spoorcc/busy-light/docs/architecture/README.md

# Architecture

- **Status:** Draft

Describe the system context, decomposition into SW/HW/MECH elements (`ARCH-nnn`),
interfaces between them (electrical, protocol, mechanical), data/power/thermal budgets,
failure behaviour, and test/diagnostic access. Each significant choice links to an ADR in `../decisions/`.
