spoorcc/busy-light/hw/sim/README.md

# Hardware simulation and analysis

- `spice/` -- ngspice netlists/models (with provenance and assumptions in a header comment)
- `scripts/` -- Python analyses (power budget, tolerance/worst-case, level compatibility, pin-mux checks)

Results are referenced by `TC-nnn` and archived per `docs/process/verification-strategy.md`.
