spoorcc/busy-light/mech/analysis/README.md

# Mechanical analysis

Tolerance stack-ups, interference checks (against KiCad STEP), FEM setups and results. Reproducible scripts preferred.
