spoorcc/busy-light/docs/requirements/mech.md

# Mechanical Requirements

- **Status:** Approved (MECH-001 to MECH-009, owner, 2026-11-07, in two steps; bracketed values stay open)
- **Version:** 0.2 (2026-11-07, assistant redraft after ADR-0003 and ADR-0011 Accepted, ADR-0014 Proposed, RV-004, RV-007; all entries stay Draft; only the owner approves)
- **Owner:**

Entries use IDs `MECH-nnn` and follow `docs/templates/requirement.md`.
Process rules: `docs/process/README.md`.

### MECH-001 Housing size

- **Statement:** The printed housing with the board fitted, without cable and plug, shall have a largest outer dimension from 48 mm to 58 mm.
- **Rationale:** SYS-028: size between a table-tennis ball and a tennis ball. Working value in plan 05: diameter [53.0] mm, height [16.5] mm (17.45 mm with feet); the values are redone for horizontal and vertical mounting (RV-004 A1). The cable and its plug are excluded (RV-004).
- **Parent:** SYS-028
- **Acceptance criteria:** A caliper measurement of [3] printed housings gives a largest dimension within the range.
- **Verification method:** Test
- **Verified by:** TC-301
- **Category:** Functional
- **Regulatory:** none
- **Priority:** Must
- **Status:** Approved (owner, Ben Spoor, 2026-11-07, in the working session; recorded by the assistant; values in square brackets stay open until measured)

### MECH-002 Light diffuser

- **Statement:** The housing shall diffuse the light of the 16 LEDs so that no single LED is visible as a point at 1 m and the ring looks like a closed band of colour.
- **Rationale:** SYS-001: the ring is read from desk distance. Points of light make the status harder to read. Owner decision 2026-11-07 (ADR-0011): a wide glow or band, not a sharp ring; concept B (opaque base, one translucent lid) is the working concept and concept A is the fallback only if TC-302 fails.
- **Parent:** SYS-001
- **Acceptance criteria:** Coupon test first: lid coupons of [0.8], [1.2] and [1.6] mm over a ring of 16 LEDs at [4], [6] and [8] mm distance; then the finished lid. A photo test at 1 m under office light shows no point source; the luminous intensity at 0.5 m of SYS-001 is measured through the diffuser.
- **Verification method:** Test
- **Verified by:** TC-302
- **Category:** Functional
- **Regulatory:** none
- **Priority:** Should
- **Status:** Approved (owner, Ben Spoor, 2026-11-07, in the working session; recorded by the assistant; values in square brackets stay open until measured)

### MECH-003 Antenna clearance

- **Statement:** The housing shall have only non-conductive plastic inside a box of [15] mm around the antenna area of the module (no metal, magnet, screw, insert, conductive or metallic filament, metallic or conductive paint, metallised label), and the range test with the finished housing shall show a loss of at most [6] dB against a bare module (the criterion of ADR-0003 spike 7.2). The 15 mm distance from the antenna edge to the nearest wall is a goal, not a pass criterion: it is 14.3 mm at the corners in the working geometry (ADR-0003 finding of 2026-11-04).
- **Rationale:** RISK-011: detuning of the antenna by nearby conductive material. The vendor guideline (15 mm in all directions) also covers LEDs, tracks and ground near the antenna and the centred module: that is a PCB layout matter, recorded in ADR-0003 and HW-005, not a housing requirement. The 15 mm cannot be met literally in a 53 mm unit (plan 05 section 4.6); ADR-0003 (Accepted 2026-11-07) puts the module off-centre toward the rim and lets the spike 7.2 loss decide. DEV-004 covers the keep-out overlap on the PCB spike.
- **Parent:** SYS-038
- **Acceptance criteria:** The housing drawing shows the plastic-only box and the wall distance; the range test of SYS-038 passes with the finished housing, with and without an accessory mounted on the back (RV-007), at three distances.
- **Verification method:** Inspection
- **Verified by:** TC-303
- **Category:** Performance
- **Regulatory:** none
- **Priority:** Must
- **Status:** Approved (owner, Ben Spoor, 2026-11-07, in the working session; recorded by the assistant; values in square brackets stay open until measured)

### MECH-004 Access to USB-C and button

- **Statement:** The housing shall give access to the USB-C connector with a standard cable whose plug overmold fits the Type-C envelope of 12.35 x 6.5 mm, through a window of [14.2] x [8.2] mm, and to the button with a finger, without tools.
- **Rationale:** SYS-017 and SYS-020: the user needs both. Window raised from [14.0] x [8.0] to [14.2] x [8.2] mm by the owner on 2026-11-07: the tolerance check (`mech-housing-first-model.md`) showed zero reserve at worst case with 14.0 x 8.0.
- **Parent:** SYS-017, SYS-020
- **Acceptance criteria:** Fit check with [3] common USB-C cables (including one with an overmolded plug at the envelope limit) and with a finger on the button in the fitted housing, on [3] printed housings; the window is checked at the worst-case tolerance stack (`mech-concept-analysis.md`).
- **Verification method:** Demonstration
- **Verified by:** TC-304
- **Category:** Usability
- **Regulatory:** none
- **Priority:** Must
- **Status:** Approved (owner, Ben Spoor, 2026-11-07, in the working session; recorded by the assistant; values in square brackets stay open until measured)

### MECH-005 Thermal and material

- **Statement:** The housing material (PETG for the prototype, ADR-0011) shall keep its shape at the highest temperature that the analysis or the measurement gives on the housing near the LEDs and the module, with a margin of at least [15] K below the material's heat deflection temperature.
- **Rationale:** RISK-005: printed plastic softens near LEDs and the module.
- **Parent:** SYS-020, SYS-028
- **Acceptance criteria:** The measured temperature at the top current step in the closed housing at [35] C ambient (the run of HW-013 and TC-213, same setup) stays below the heat deflection temperature of the named PETG by the margin; the PETG data (65 to 78 C at 0.45 MPa across brands, ADR-0011 E2) gives a working limit of about [50] C at the housing wall, to be replaced by the data of the actual filament. Orientation: horizontal and vertical. The material and its data sheet are named in the drawing.
- **Verification method:** Test
- **Verified by:** TC-305
- **Category:** Safety
- **Regulatory:** EN 62368-1 *(verify)*
- **Priority:** Must
- **Status:** Approved (owner, Ben Spoor, 2026-11-07, in the working session; recorded by the assistant; values in square brackets stay open until measured)

### MECH-006 Label area

- **Statement:** The housing shall have a flat area of at least [20] x [20] mm on the back of the base, outside the bayonet ring of MECH-007 (in its open centre if ADR-0014 variant V2 is accepted: a circle of [21] mm), for the unit label (identifier, passphrase, QR code) and the "prototype, not for sale" mark, which an accessory on the back does not cover.
- **Rationale:** ADR-0006 puts the passphrase on a label. Owner decision 2026-11-04: the unit is mounted horizontal and vertical and the label is on the back (assumption A1 of plan 05 is withdrawn). The label stays on the base, which does not move when the lid opens, and never on a swappable accessory. The label is inside the 15 mm antenna box of MECH-003, so it must not be metallised. Regulatory labelling is a tight fit on a 53 mm housing (AS4).
- **Parent:** SYS-013
- **Acceptance criteria:** The drawing shows the label area on the back, outside the recess of MECH-007. A printed label of the stated size fits, is not metallised, and stays readable after a wipe test of [20] cycles and after the heat soak of MECH-005. A locked accessory does not cover the label.
- **Verification method:** Inspection and Test
- **Verified by:** TC-306
- **Category:** Usability
- **Regulatory:** none
- **Priority:** Should
- **Status:** Approved (owner, Ben Spoor, 2026-11-07, in the working session, after ADR-0014 was accepted; recorded by the assistant; values in square brackets stay open until the coupon test; [X] N is derived from the heaviest accessory)

### MECH-007 Back mounting interface

- **Statement:** The back of the housing shall have an annular bayonet (ring from radius [16.3] to [21.0] mm, depth [1.2] mm in the 2.0 mm floor, [3] T-shaped lugs of [1.2] mm engagement height behind a lock lip, [3] lock positions) that takes a ring-shaped accessory (stand, clip, rack-mount adapter or blank plate) by a turn of about [30] degrees, with a detent and a release tab, without tools, leaving the centre open, and shall have no metal, magnet or insert in or on the back.
- **Rationale:** NEED-022 and ADR-0014 (Accepted 2026-11-07): a printed bayonet is plastic only, so it respects the antenna box of MECH-003. The annular variant keeps the 21 mm label readable in the open centre (`spike-mech-back-layout.md`, V2); widths are multiples of 0.4 mm (4.4 or 4.8 mm for the ring). The floor skin, print orientation (the recess on the bed side is a bridge), release against a knock and the loads are not shown (RV-007). A printed thread and a tripod socket were rejected. Lock concept confirmed by the owner on 2026-11-07: entry sector, lock sector with a [0.4] mm lip, solid stop (`mech-housing-first-model.md`; `bayonet_geometry.py`).
- **Parent:** NEED-022
- **Acceptance criteria:** The drawing shows the ring, the lugs, the detent and the release tab with tolerances and the print orientation. A test accessory fits and locks on [3] printed housings by one hand in under [10] s, and detaches again; a knock test does not release it. No metal part is in the back (inspection).
- **Verification method:** Inspection and Test
- **Verified by:** TC-307
- **Category:** Functional
- **Regulatory:** none
- **Priority:** Should
- **Status:** Approved (owner, Ben Spoor, 2026-11-07, in the working session, after ADR-0014 was accepted; recorded by the assistant; values in square brackets stay open until the coupon test; [X] N is derived from the heaviest accessory)

### MECH-008 Accessory retention

- **Statement:** An accessory locked to the back shall hold the unit against a pull-off force of at least [X] N (derived from the mass and leverage of the heaviest planned accessory, the rack-mount adapter; the earlier [10] N is withdrawn), before and after [100] attach and detach cycles and after a heat soak at the highest internal temperature of MECH-005.
- **Rationale:** The unit hangs on a wall clip or stands on an accessory. FDM lugs and detents in warm PETG or ASA can creep (plan 05 section 4.8; no strain limit found). The force value is open until it is derived from the heaviest planned accessory; a stand or rack mount loads the lugs in moment and shear (RV-007). PETG creeps when warm (ADR-0014 fallback C, a dovetail, if the coupon fails).
- **Parent:** NEED-022
- **Acceptance criteria:** On [3] housings, the pull-off force is at least [X] N before the cycles, after [100] cycles, and after the heat soak; no lug is cracked; the accessory does not release by itself in a hanging test of [24] h at the soak temperature.
- **Verification method:** Test
- **Verified by:** TC-308
- **Category:** Safety
- **Regulatory:** none
- **Priority:** Should
- **Status:** Approved (owner, Ben Spoor, 2026-11-07, in the working session, after ADR-0014 was accepted; recorded by the assistant; values in square brackets stay open until the coupon test; [X] N is derived from the heaviest accessory)

### MECH-009 PCB retention and reopening

- **Statement:** The housing shall hold the board by snap hooks on the board edge, with no screw through the board and no metal near the antenna zone, and shall open and close [100] times without a broken hook or a loose board.
- **Rationale:** Owner decision 2026-11-07 (ADR-0011 point 7): snap hooks on the board edge, no holes. Metal near the antenna zone detunes it (MECH-003). The unit is opened for programming and repair (HW-006), so reopening has to work; PETG hooks can break (ADR-0011 risk c). The PCB spike outline already carries the notches.
- **Parent:** SYS-028
- **Acceptance criteria:** On [3] printed housings, [100] open and close cycles with no cracked hook; the board does not move by more than [0.3] mm in a shake test; the drawing shows the notches and hooks with tolerances (radial gap D 46 mm to the wall 1.38 mm worst case).
- **Verification method:** Test
- **Verified by:** TC-309
- **Category:** Reliability
- **Regulatory:** none
- **Priority:** Should
- **Status:** Approved (owner, Ben Spoor, 2026-11-07, in the working session; recorded by the assistant; values in square brackets stay open until measured)

### MECH-010 Flammability class of the housing material for units placed on the market

- **Statement:** The housing parts of every unit placed on the market shall be made of a material whose flammability class, at the wall thickness used, meets what the fire classification of SYS-050 asks of the housing.
- **Rationale:** RISK-047. If any circuit is class PS2 and the housing is its fire enclosure, EN IEC 62368-1 asks for V-1 or better for the enclosure material *(verify clause 6.4.8 and Annex S)*; if every circuit is PS1, no fire enclosure is needed and HB is the working minimum. ADR-0011 accepts FDM-printed PETG for the prototype only; common PETG filament has no flammability rating, and a rating of the raw material does not automatically hold for a printed part with layers and infill. This requirement can therefore change the material or the process for sold units, and needs its own ADR.
- **Parent:** SYS-050
- **Acceptance criteria:** The drawing names the material, its maker and grade; the maker's data sheet or a UL yellow card states the class at a thickness at or below the thinnest housing wall; for a printed part, a flame test of [5] printed coupons at the product wall thickness and print settings to IEC 60695-11-10 confirms the class. The 10 internal prototypes are out of scope.
- **Verification method:** Inspection
- **Verified by:** TC-310
- **Category:** Safety
- **Regulatory:** RED 2014/53/EU Art. 3(1)(a); EN IEC 62368-1 clause 6.4 and Annex S; IEC 60695-11-10 *(verify)*
- **Priority:** Must
- **Status:** Draft

### MECH-011 Strength of a wall, ceiling or rack mounting accessory

- **Statement:** An accessory that holds the unit on a wall, on a ceiling or in a rack shall hold a force of [3] times the weight of the unit with its cable, and at least [50] N, applied for [1] min in the direction of the fall, without release or damage.
- **Rationale:** RISK-039. EN IEC 62368-1 clause 8.7 tests the mounting means of equipment that is mounted on a wall or ceiling *(verify the force values and whether the clause applies to a unit of this mass)*. MECH-008 leaves its pull-off force [X] N open; this requirement gives the safety-driven lower bound for the accessories that carry the unit above a person or a surface.
- **Parent:** NEED-022
- **Acceptance criteria:** On [3] printed accessories and housings, the force is applied to the locked unit for [1] min before and after the heat soak of MECH-008; the unit stays locked and no part cracks. A desk stand is out of scope.
- **Verification method:** Test
- **Verified by:** TC-311
- **Category:** Safety
- **Regulatory:** RED 2014/53/EU Art. 3(1)(a); EN IEC 62368-1 clause 8.7 *(verify)*
- **Priority:** Should
- **Status:** Draft
