spoorcc/busy-light/docs/journal/2026-11-07-mech-requirements-redraft.md

# 2026-11-07: mechanical requirements redraft

The assistant redrafted MECH-001 to MECH-008 and added MECH-009 as Draft. Nothing is approved.

Changes: MECH-001 excludes the cable and plug; MECH-002 names the coupon test and the wide-glow decision; MECH-003 turns the 15 mm wall distance into a goal and makes the range loss of at most [6] dB the pass criterion; MECH-004 names the USB-IF plug envelope and the window; MECH-005 names PETG and ties the temperature to the TC-213 run; MECH-006 moves the label to the open centre of the annular bayonet; MECH-007 describes the annular bayonet and is conditional on ADR-0014; MECH-008 withdraws the 10 N figure until it is derived; MECH-009 is new (snap hooks, 100 reopenings).

Open questions for the owner: (1) MECH-003 no longer requires 15 mm to the wall: accept the range test as the criterion; (2) the PETG working limit of about 50 C at the wall comes from the lowest brand data and is replaced by the actual filament data; (3) ADR-0014 is not accepted, so MECH-006, 007 and 008 are conditional; (4) height and label place for horizontal and vertical mounting are not redone (RV-004 A1).

Not run: no CAD, no analysis, no print.
