spoorcc/busy-light/docs/user/specifications.md

# Specifications

- **Status:** Draft -- placeholder, content to be written after requirements are approved
- **Applies to:** product revision TBD (hardware / mechanical / firmware)
- **Source requirements:** TBD

> Scope: Table of electrical, mechanical, environmental and radio data with units and tolerances. Values must trace to requirements.
