spoorcc/busy-light/docs/verification/reports/spike-fab-review.md

# Spike board: assembly and fabrication review (HW-010)

- **Date:** 2026-11-08. **Author:** assistant. **Status:** Draft evidence. Not an approval; only the owner approves a design.
- **Subject:** `hw/kicad/spike-gate/board/busy_light_spike.kicad_pcb` (ring14 run 9, 4 layers, 1.6 mm, 53.9 x 46.1 mm, 100 parts, 59 on the bottom side).
- **Tool and tests:** `hw/kicad/spike-gate/src/pcb_fabreview.py`, `tests/test_pcb_fabreview.py` (7 pass).
- **Basis:** KiCad 10.0.6 `kicad-cli` exports and DRC; JLCPCB numbers of ADR-0020 (Proposed) in `pcb_fabcheck.py`.

## What was run
| Check | Result |
|---|---|
| DRC, all severities, all track errors | 0 unconnected, 0 schematic parity findings; findings only courtyards_overlap 8 and items_not_allowed 1 (U9 antenna keep-out, DEV-004). No silkscreen, solder-mask or edge finding was reported. |
| Fabricator minimums (`pcb_fabcheck.py`) | PASS; via ring at the 0.15 mm absolute minimum on all 131 vias |
| Gerber export (12 files: 4 copper, 2 mask, 2 paste, 2 silkscreen, edge cuts, job), Excellon drill (`.drl`) | files written; not opened in a second viewer |
| Position file (`pos.csv`), BOM (`bom.csv`) | written; see findings |
| `pcb_fabreview.py` (BOM against board, references, fiducials, silkscreen, tbd values) | **4 findings** |

## Findings
| # | Finding | Evidence | Effect |
|---|---|---|---|
| 1 | The schematic BOM has 7 unannotated references: C1B? to C1F?, R_ILIM3B?, R_VD?. The board has them as C1B to C1F, R_ILIM3B, R_VD. | `pcb_fabreview.py` `unannotated`, `bom_vs_board` | The BOM from the schematic does not match the board. Fix in the schematic generator; not investigated. |
| 2 | No reference designators on the silkscreen: all 100 reference texts are on F.Fab or B.Fab. | `refs_on_silk` 0 | Hand assembly, rework and probing have no marks. |
| 3 | No fiducials. | `fiducials` 0 | Pick-and-place machines align on fiducials; JLCPCB assembly may add its own or reject the panel. Not checked with the fabricator. |
| 4 | Five parts still have a tbd value: C2, C3, C4, C5, C6 (HW-014, HW-015, HW-016 are Draft). | `open_values` | The BOM cannot be ordered. |
| 5 | The BOM has no manufacturer part number or supplier number field. | `has_mpn_field` false | No sourcing or availability check is possible. |
| 6 | Two-sided assembly: 41 parts on top, 59 on the bottom; the USB-C receptacle (20 through-hole pads) is edge-mounted. | `pos.csv`, pcbnew | Costs more and needs a second reflow pass; the through-hole part needs hand or selective soldering. |

## Not run
Opening the Gerbers in an independent viewer, a fabricator's own DFM check (JLCPCB online), part availability and lifecycle, 3D fit against the housing (MECH), panelisation, test-point access for a test fixture, RF and antenna, thermal, bench. The 3D render shows the copper only faintly, so solder-mask appearance was not judged.

## Reading
The board file is clean for the DRC and the fabricator minimums. It is **not ready to order**: findings 1 to 5 would stop or slow an assembly order. None of this makes the board "DFx approved" or "fully functional"; both statements need the owner's review, a built board and the bench tests (TC list in the HW-010 verification plan).

## Update after the fixes (2026-11-08, owner choice "all three, including renaming")
| # | Change | Evidence |
|---|---|---|
| 1 | Seven parts renamed to numbered names (KiCad reads a reference without a trailing number as unannotated): C1B to C1F to **C27 to C31**, R_ILIM3B to **R20**, R_VD to **R21**. Generators, rules, tests, evidence files and current reports use the new names; journals, the CHANGELOG and the earlier ring sections keep the old names as history. The schematic was regenerated (`run_full.sh`: ERC 0, intent equal, deterministic) and the board renamed by script (`pcb_rename.py`, 5 tests); one auto-named net (`Net-(R_ILIM3-Pad1)`, now `Net-(R20-Pad2)`) was renamed with it. | BOM has no `?`; BOM and board refs agree; schematic parity shows only the two known C3 and C4 mismatches |
| 2 | Reference designators on the silkscreen by script (`pcb_finish.py`, 12 tests): 73 of 100 parts have one (1.0 mm text, 0.8 mm where tight). 27 parts have none because the DRC found no free place: SW1, D3, DZ14, DZ15, C4, C25 to C27, U1, U14, U15, TP5, R1 to R3, R5, R11 to R15, R17, R18, R20, R_ILIM1, R_ILIM3, R_SU15. | DRC with all severities: no silkscreen finding; render checked by eye (top and bottom) |
| 3 | Four fiducials (two per side, 1.0 mm pad, 2.0 mm mask opening), outside the U9 antenna area, the connector and the rule area. A third per side found no free spot. | `pcb_fabreview.py` counts 4 |

Checks on the finished stored board: strict gate (tolerated classes only: courtyards_overlap 8, items_not_allowed 1, symbol mismatch 2), fab-minimum check PASS, power drops 13.5, 18.0 and 22.7 mV, 131 vias and 1369.9 mm of track (no routing change), 0 unconnected. `pcb_fabreview.py` still reports FINDINGS: 26 parts without a silkscreen designator (the 27th, TP5, is a test point), tbd values C2 to C6, and the BOM has no part-number field. The fiducials are not checked against a fabricator's rules (JLCPCB asks for its own); their count of 4 is below the usual 3 per side.

Name map for the older documents: C1B to C1F = C27 to C31, R_ILIM3B = R20, R_VD = R21.

## Update 2026-11-08 (finding 5, BOM sourcing fields)
`src/sourcing.py` maps a part value to `MPN`, `Manufacturer` and `LCSC`; `layout_full.py` writes them as hidden symbol fields, and the stored schematic was regenerated (ERC 0 findings; the only difference to the old file is the added fields). Only TMUX1101DCKR (U14, U15) has a recorded source (owner decision 2026-11-05, datasheet SCDS410D). `pcb_fabreview.py` now reports parts without an MPN: **92 of the BOM references** (BOM exported with `--ref-range-delimiter ""` so that ranges such as C8-C26 are not counted as one). Finding 5 is therefore half closed: the field exists and is checked; the numbers are not filled in. Filling them needs a datasheet or shop check per part (HW-008, spike 7.4) and was not done; no number was taken from memory. Tests: `tests/test_sourcing.py` (5), `tests/test_pcb_fabreview.py` (+1). Existing defect found, not fixed: a second `layout_full.build()` in one process draws extra symbols (253 then 295), so the new test builds in a fresh process.

## Update 2026-11-08 (MPNs from web lookups)
Owner choice "ICs and specific parts". MPNs and, where seen, LCSC numbers were looked up on the web for 13 more part groups (U1 to U8, U10, U11, U13, D1 to D16, DZ1/DZ14/DZ15, SW1) and stored with their evidence in `src/sourcing.py`. The evidence is mostly distributor listings (DigiKey, LCSC, RS); TI package addenda for TPS3840DL40DBVR and TPS2553DBVR; the ST product page for USBLC6-2P6. No manufacturer ordering table was opened and no datasheet PDF was read for these numbers, so they are lookups, not verified sourcing. Parts without an MPN: **61 references** (92 before).

Points for the owner:
- U9 ESP32-C3-MINI-1: the flash variant (-N4 or -H4) is not decided anywhere in the repo; left empty.
- J1: the GCT USB4085-GF-A in the listings is a through-hole right-angle part, while the footprint is `USB4085_edge`; the edge-mount variant is not identified; left empty.
- U1 TUSB321RWBR: LCSC marks it not recommended for new designs.
- D1 to D16 WS2812B-2020: LCSC lists 2.2 x 2 mm, the footprint is 2.0 x 2.0 mm; check the manufacturer drawing.
- SW1 TL3342F160QG: the force variant is an assumption.
- TVS1, TVS2 (no part chosen), C2 to C6 (tbd), all resistors and capacitors (no manufacturer chosen): left empty.

## Update 2026-11-08 (finding 4, tbd values)
Values set by owner decision (`proposal-tbd-capacitor-values.md`): no tbd value is left (`open_values` empty). Finding 4 is closed for the values; the capacitors have no MPN yet. C4 and C32 are do-not-populate spares and are out of the BOM (`--exclude-dnp`); `pcb_fabreview.py` now takes the DNP footprints out of the BOM comparison and lists them. Parts without an MPN: **60 references** (61 before; C4 left the BOM). Designators missing on the silkscreen: 27 (C32 added). Also corrected: the sourcing fields from the finding-5 update were not on the board footprints, so the strict DRC of the stored board had 100 `footprint_symbol_field_mismatch` warnings after that change (CI would have failed; my check at the time ran ERC only). Fixed in the same change as the capacitor values.

## Update 2026-11-08 (MPNs for passives and U9)
Owner choices: JLCPCB basic-library parts for resistors and capacitors; U9 = ESP32-C3-MINI-1-N4. Added to `src/sourcing.py` with evidence per entry: Uni-Royal 0603WAF series for 10k, 100k, 1k, 330, 470, 150k, 887k; FH thin film TD03G3010BT, TD03G4702BT, TD03G5622BT and Yageo RT0603BRE0727K4L for the 0.1% values; Samsung CL10B104KB8NNNC (100n 0603), CL10A105KB8NNNC (1u), Murata GRM31C5C1H104JA01L (100n C0G 1206); ESP32-C3-MINI-1-N4. Source: LCSC/JLCPCB/DigiKey listing pages found by web search; no datasheet PDF was opened, so these are lookups, not verified sourcing. Open points: 0603WAF1503T5E (150k) LCSC number came from the JLCPCB page only; 0603WAF8873T5E (887k) listing showed 0 stock; the FH 0.1% parts are JLCPCB extended parts (extra feeder fee); 27.4k has no LCSC number; the 0.1% resistor values are not checked against the ILIM tolerance analysis.
Schematic regenerated (strict ERC 0 findings); `pcb_spare_caps.py` copied the fields to the footprints; strict DRC: 9 findings, all the tolerated classes (courtyards_overlap 8, items_not_allowed 1), no parity warning. Tests: `tests/test_sourcing.py` (+1); the 15 errors in `test_gate_logic.py` need the `GATE_NET` environment variable of a run and were not run here.
**Parts without an MPN: 7 references** (60 before): C2, C3, C5, C6 (real parts wait for the DC-bias and effective-capacitance analysis, HW-014/HW-015), J1 (edge-mount variant of the GCT USB4085 not identified), TVS1, TVS2 (no part chosen; the surge decision S1 to S3 of RV-013 is open). Candidate SOD-323 5 V ESD diodes seen in listings, not chosen: Nexperia PESD5V0S1UA (LCSC C179414), Nexperia PESD5V0U1BA (C552574). Their surge rating for a VBUS hit is not checked.

## Update 2026-11-09 (MPNs for C2, C3, C5, C6 after the DC-bias bound)
The maker's DC-bias curves were then read with Claude in Chrome from the Samsung Component Library and replaced the assumed retention (`analysis-dc-bias-caps.md`: C2 1.69 uF at 5.25 V, C5 0.67 uF at 5.5 V). Parts and result in `analysis-dc-bias-caps.md`; script `hw/sim/scripts/dc_bias_caps.py` (9 tests). Value texts changed to `4.7u 16V X5R`, `10u 25V X5R`, `2.2u 16V X5R`, `10u 10V X5R`; MPN, manufacturer and LCSC added to `src/sourcing.py` (listings only, no datasheet opened). Schematic regenerated (strict ERC 0 findings); `pcb_spare_caps.py` synced the footprints; strict DRC: 9 findings, the tolerated classes only (courtyards_overlap 8, items_not_allowed 1). Tests: `tests/test_sourcing.py` (+1, one changed), `test_pcb_fabreview`, `test_pcb_spare_caps`, `test_layout_full` pass. **Parts without an MPN: 3 references** (7 before): J1, TVS1, TVS2. HW-014/HW-015 criterion 1 now uses the maker's typical curve (25 degC, 1 kHz, 1 Vrms); the bench criteria stay open.
