spoorcc/busy-light/docs/verification/reports/spike-pcb-placement-routing.md

# Spike: PCB placement and routing of the full board

Status: spike result, exploratory. It is not a product design and nothing here is approved. ADR-0012 is Proposed, so the PCB flow it describes is not decided, and nothing from this spike merges before the owner decides it. No compliance claim is made.
Traces: HW-010 (Draft proposal), HW-003, ADR-0016, ADR-0012 (Proposed), ADR-0010, SW-009 (proposed readback rule), RISK-042.
Implementation (spike branch `spike/hw-gate`, `hw/kicad/spike-gate/`): `src/pcb_full.py` (placed board), `src/route_grid.py` (router), `src/pcb_check.py`, `src/pcb_dsn.py`, `src/pcb_rules.py`, `run_pcb.sh`, `tests/test_pcb_full.py`, `tests/data/full.net` (netlist of the final full-board sheet).
Rebuild: run `run_full.sh <python> <dir>` for the schematic, then `sh run_pcb.sh <dir> <out>` with the system `python3` (KiCad 10.0.6 `pcbnew`, numpy 2.5.3, scipy 1.18.1, Python 3.14). The `.kicad_pcb` and `.kicad_pro` files are written by script into `<out>/a/` and are not committed, the same rule as the schematic spike. Nothing in them was edited by hand.

**Update (second run, same day):** section 10 adds the mechanical outline from the FreeCAD spike, Freerouting v2.5.0 and the 2-layer against 4-layer comparison. Where sections 1 to 9 differ from section 10 (outline, placement, router, widths), section 10 is the newer result. Sections 1 to 9 describe the first run on a provisional 136 x 64 mm rectangle with the own grid router; they are kept as the record of that run.

## 1. Result in numbers (run of 2026-11-05, final code)

| Item | Result |
|---|---|
| Parts placed | 86 of 86 refs of the netlist (plus 3 provisional mounting holes H1 to H3); no missing and no extra refs |
| Nets | 63 in the netlist (53 named, 10 `unconnected-*`); 63 on the board; 0 pad-to-net differences against the netlist (`pcb_check.py`) |
| Connections to route (excluding GND) | 141; routed 138, **not routed 3** (see section 5) |
| GND | back-layer pour plus a via for every SMD GND pad; **5 GND items stay unconnected** in the KiCad DRC |
| Tracks / vias | 884 track segments, 225 vias, 1646 mm of copper track, router time about 95 s |
| KiCad DRC (`kicad-cli pcb drc`, zones refilled) | **errors: 4 clearance, 8 unconnected items**; warnings: 86 `lib_footprint_issues`, 15 `silk_over_copper`, 1 `hole_to_hole`, 1 `connection_width`, 1 `via_dangling` |
| KiCad schematic parity | 100 warnings, all explained in section 4 (U1, U8, U9 pin names, four substituted capacitor footprints, three holes) |
| Placement build twice | byte-identical (`run_pcb.sh`, uuids normalised) |
| Routing run twice | byte-identical (`cmp` exit 0) |
| Unit tests | `tests/test_pcb_full.py`: 11 tests, all pass under system `python3` (skipped without `pcbnew`) |

The 4 clearance errors: two between a VBUS_IC track and pad 4 (`USB_DP`) of U6 (actual 0.125 mm, rule 0.150 mm) and two between a `+3V3` track and a `CC_OK_NOT_S3` track (actual 0.147 mm, rule 0.150 mm). The board does **not** pass DRC.

## 2. Tools and why

| Tool | Use | Status |
|---|---|---|
| KiCad 10.0.6 `pcbnew` Python | writes the board from the netlist; zone fill; DSN export | used |
| `kicad-cli pcb drc` / `export svg` | DRC with `--schematic-parity --refill-zones`; renders (scratchpad only) | used |
| Own grid router `src/route_grid.py` | A* on a 0.05 mm grid, 2 layers, through vias, Euclidean clearance raster (scipy), neck-down of wide nets, a retry pass | used (fallback) |
| Freerouting v2.5.0 (`freerouting-2.5.0.jar`, GitHub release) | the router I preferred | **not run**: see below |

**Freerouting was not run.** I tried to download the pinned jar into `~/Programming/busy-light-tools/` (outside the repository) and the permission layer of this session refused the download-and-execute action ("Code from External"). I did not work around the refusal. No version hash is recorded because no file was fetched. What exists: `src/pcb_dsn.py export` writes a Specctra DSN from the placed board (tested: it writes 63 nets with the net-class rules, 50 KB), and `pcb_dsn.py import` reads an SES back, refills zones and saves. The import path is **untested**. To use Freerouting the owner can allow the download or run `java -jar freerouting-2.5.0.jar -de x.dsn -do x.ses` on the DSN and then `pcb_dsn.py import`. Its result is likely better than mine (my router has no rip-up and re-route, only one retry pass), but that is an expectation, not evidence.

## 3. Board and placement decisions (all provisional)

- **Layers: 2.** Reasons from the earlier reports: the USB path carries 1.5 A (limit 1.38 to 1.58 A, step 3 up to 2 A worst case), which needs about 0.53 mm (1.5 A) and 0.78 mm (2.0 A) width at 1 oz and a 10 K rise (IPC-2221 curve fit, test `Rules`); the high-impedance ILIM node must stay short; USB 2.0 full speed needs no controlled impedance. The ESP32-C3 antenna wants no copper under or beside it, which a 2-layer board with one GND pour can honour. The cost is that routing is congested (many vias). A 4-layer stack would give an inner GND plane and is the likely answer if Freerouting results are also poor. No stack-up or fabricator rule was checked.
- **Outline 136 x 64 mm**: electronics zone x < 64 mm, 16 WS2812B LEDs in 2 rows of 8 at 8.5 mm pitch with a 100 nF capacitor each, 3 mounting holes M3. Mechanics, LED count and peg azimuth are open, so this outline has no basis in the mechanical design.
- **Rules:** clearance 0.15 mm (the J1 pad gap is 0.15 mm), signal track 0.2 mm (0.15 mm on nets at the 0.4 mm-pitch pads of U1), via 0.6/0.3 mm, copper-to-edge 0.3 mm, hole-to-hole 0.4 mm (relaxed from 0.5 mm because J1's through-hole pads are 0.85 mm apart with 0.4 mm drills). Whether a fabricator accepts these was **not checked**.
- **Placement by rule** (coordinates in `PLACE` in `pcb_full.py`): USB-C J1 with its mating face at the left edge; TVS and ESD parts beside J1; CC IC U1 at J1's CC pads; gate logic cluster in the middle; Q2, Q3, R2, R3 and the three ILIM resistors in a group next to U7 (ILIM parts within 15 mm of U7, tested); U5 with C1 and C1B beside it; the module U9 with its antenna end flush with the top edge and no other pad in its keep-out band (tested); LED field on the right. The placement was adjusted by hand-chosen coordinates and one iteration, not optimised: the render shows long runs.

## 4. Footprints: substitutions and gaps (all PROVISIONAL)

| Ref | Schematic footprint | Used | Why / what to check |
|---|---|---|---|
| U1 TUSB321 | `Package_X2QFN:X2QFN-12` | custom 12-pad footprint made in `pcb_full.py` | The system KiCad libraries have no `Package_X2QFN`. The geometry was read from a **text extract** of TI drawing RWB0012A (1.6 x 1.6 mm, 0.2 mm pads, 0.5 and 0.4 mm pitch). It may be wrong; take the land pattern from the TI drawing before any use. Pad numbers: CC1 1, CC2 2, PORT 4, VBUS_DET 5, GND 10, VDD 12 (datasheet pin table). |
| U9 ESP32-C3-MINI-1 | `RF_Module:ESP32-C3-MINI-1` | `RF_Module:ESP32-C6-MINI-1` | The C3 footprint is not in the libraries. Pad positions of the C6 footprint match the C3 pin diagram (pins 1 to 53, antenna to the top, corner pads 50 to 53), but I did not compare dimensions to datasheet figure 11-1. Its antenna keep-out zone (43 x 20 mm) comes with the footprint. Pad numbers from the C3 datasheet v2.2 table 3-1. |
| U8 REG_3V3 | empty (placeholder) | `SOT-223-3_TabPin2` | No regulator is chosen. Pin map GND 1, OUT 2, IN 3 is an AMS1117-style assumption. A 5 V to 3.3 V linear regulator at the module's peak current dissipates real heat; no thermal analysis was done. |
| C1, C1B | `C_0603` in the sheet | `C_1206` | The 470 nF and 150 nF C0G parts of the N4 addendum are 1206 (the sheet still draws 0603 for them: a schematic follow-up). |
| C3, C4 | `C_0603` | `C_0805`, `C_1206` | 10 uF and bulk values are "tbd"; sizes are guesses. |

Schematic pin names for U1, U8, U9 are names, not pad numbers (the box symbols of the full-board sheet are placeholders), so the generator maps them (`PADMAP`). KiCad's parity check therefore reports 84 `net_conflict` warnings on those three parts. The 13 `footprint_symbol_mismatch` warnings are the substitutions above plus six test points (BOM-exclusion attribute); 3 `extra_footprint` are the mounting holes. All 80 other refs are parity-clean.

## 5. What is not done or not good

- **3 connections are not routed:** `/CC1` and `/CC2` (J1 A5/B5 to U1 pads 1 and 2) and `Net-(U9-GPIO9_(boot))` (U9 pin 23 to TP6). The CC lines are exactly the nets the CC IC depends on (HW-010, HW-003), so the gate is **not** a complete design until they are routed. Likely cause: pads 1 and 2 of my guessed U1 land pattern are 0.4 mm apart with tight neighbours, and the router has no rip-up. I did not diagnose it further.
- **5 GND items unconnected** (U1 pad 10, U2 pad 3, U9 pad 49 and two via stubs): GND stub-and-via pieces that the back pour cannot reach, probably islands cut off by back-layer signal tracks.
- **4 clearance errors** (section 1). The router's raster is conservative but not exact; the DRC is the judge.
- **Layout quality is poor.** The render shows long and winding wide power tracks and 225 vias (about 80 for LED and capacitor GND alone). Track lengths: VBUS_IC 94 mm, +5V 243 mm, +3V3 148 mm. A person would place and route this more tightly.
- **Wide power tracks:** VBUS_IC is routed at 0.8 mm for 75 % of its length and +5V for 67 %; elsewhere it necks down to 0.25 mm near pads (the rest of the 1.5 A path is below the 0.53 mm that IPC-2221 gives, which is a finding, not a pass). +3V3 is meant to be 0.4 mm and is 0.25 mm in places.
- **Thermal relief:** only the zone's thermal spokes on the GND pour. No thermal vias or copper area for the TPS2553 or the regulator.
- **86 `lib_footprint_issues` warnings** mean the footprint libraries are not in a project library table; they say nothing about the layout. **15 silkscreen warnings** and one `hole_to_hole` (J1) were left open.

## 6. Layout rules from the earlier reports: what was measured

| Rule | Result |
|---|---|
| R3 and the U13 tap at the Q3 gate pin | `/ILIM_STEP3_EN` is routed as a star centred on Q3 pad 1 (every pad of the net, U4, U13, R3, R15, goes straight to that pad; 34 mm of track in total). R3 sits 5.7 mm from Q3. Tested only as placement and star setting, not by inspecting every spoke. |
| ILIM resistors near U7, short ILIM trace | R_ILIM1 to 3 within 15 mm of U7; the `/ILIM` net is 16.4 mm of track. "Away from switching nodes" was not analysed. |
| CC lines per the CC IC | **not met**: `/CC1` and `/CC2` are unrouted. |
| Wide VBUS | partly (section 5). |
| Antenna keep-out | no other pad in the band (test); no DRC error inside the rule area. Whether the pour and tracks respect the **real** C3 keep-out was not checked (the zone comes from the C6 footprint). |

## 7. Determinism

- Placement build: two builds are byte-identical (item uuids are set from a fixed seed, then normalised; checked in `run_pcb.sh` and in `test_two_builds_are_identical`).
- Routing: the router uses no random numbers, a fixed net order and fixed tie-breaks. A second routing run on the same placed board gave a byte-identical `.kicad_pcb` (`cmp` exit 0). This holds for this code, machine and KiCad version only. Freerouting, if used, would need its own seed recorded.

## 8. Not run

No signal-integrity, EMC, antenna or thermal analysis. No fabricator DFM check (JLCPCB capabilities, via and annular ring, solder-mask bridges, paste). No 3D or mechanical fit (connector overhang, LED peg positions, mounting holes). No stack-up study, no 4-layer comparison. No Freerouting run. No SPICE. No bench. The footprint substitutions in section 4 need datasheet verification (TUSB321 land pattern, ESP32-C3-MINI-1 land pattern, regulator). Nothing here shows the board is correct, only how far a script-generated layout got.

## 9. Owner items

- Allow the Freerouting download (or run it) and compare with this router; decide 2 or 4 layers from that result.
- Provide a mechanical outline (LED count, peg azimuth, connector position) before a real placement.
- Pick the regulator and confirm the TUSB321 and module land patterns from the datasheets.
- ADR-0012 decides whether this flow is used at all.

## 10. Second run (2026-11-05): mechanical outline, Freerouting, 2 layers against 4 layers

Spike result, exploratory, nothing approved. Code: `src/mech_outline.py` (the mech table with sources), `src/pcb_place.py` (annealing placer), `src/pcb_full.py` (board), `src/pcb_dsn.py` (DSN export, SES import), `src/pcb_stitch.py` (plane vias), `run_pcb.sh`, tests `tests/test_mech_outline.py` (8) and `tests/test_pcb_full.py` (18, need pcbnew). Rebuild: `FREEROUTING_JAR=<jar> sh run_pcb.sh <run_full dir> <out dir> [2|4]`.

### 10.1 Where the outline comes from (all numbers are from a concept spike, not from an Approved design)
Source: branch `spike/mech-concept`, commit `deb9a5c`, file `mech/freecad/busy_light_housing.py` (parameter block) and `docs/verification/reports/mech-spike-model.md` (sections 4 to 6) on that branch. The FCStd files in `.claude/worktrees/agent-ac020049007f58faf/mech/` (V1, V2-posts, V2-pocket) were generated by that script and were not opened with FreeCAD; the script is the source. `spike/mech-back-layout` holds only a 2D back-layout check and gave no PCB numbers. MECH requirements and plan 05 are Draft, ADR-0011 is the concept basis, and the report says "No variant is chosen (HW-005, ADR-0003)".

| Item | Value | Source (script parameter / report) |
|---|---|---|
| PCB disc | D 46.0 mm, 1.6 mm thick | `D_PCB`, `T_PCB` |
| LED ring | 16 LEDs on D 40.0 mm, first LED at 3.75 deg, pitch 22.5 deg | `N_LED`, `D_RING`; `LED_PHASE` is an ASSUMPTION of the mech spike (HW-001 gives no phase) |
| Poka-yoke notch | R 1.5 mm in the edge at 90 deg | `NOTCH_R`, `NOTCH_AZ` |
| Holding | three base posts with edge pegs and hook lugs at 30, 150, 270 deg (post R 20 to 22, 4 mm wide; hook overlaps the PCB top by 0.6 mm); no mounting holes | `POST_AZ`, `R_POST`, `POST_RAD`, `POST_TANG`, `HOOK_OVERLAP` |
| Space under the PCB | 3.0 mm (PCB underside at Z 5.0, floor 2.0) | `Z_PCB_BOT`, `T_FLOOR` |
| Module | 16.6 x 13.2 x 2.4 mm at the board centre, offset 1.0 mm towards azimuth 0, antenna strip 5.4 mm towards -X | `MOD_*` |
| Vendor antenna zone | 15 mm | `ANT_KEEPOUT` (plan 05 section 4.6) |
| USB-C (variant V1) | PCB tab at azimuth 0, 12 mm wide, to R 29.0 (placeholder); receptacle body R 22.5 to 29.85 on the top side (placeholder 7.35 x 8.94 mm) | `V1_TAB_W`, `V1_TAB_R`, `V1_USB_R0`, `USB_L`, `USB_W` |
| Button | side-actuated tact switch at the edge at 240 deg (placeholder body) | `BTN_AZ`, `BTN_BODY_*` |
| Housing limit | largest dimension 58 mm; the V1 model gives 57.43 mm | `MAX_DIM_MECH001`; report 4.1 |

**Variant choice: V1.** It is the only one of the three that passes all 41 checks of the mech report and keeps one-side assembly (SYS-022). Alternatives, not used: V0 (receptacle on the LED side at the board edge) fails its interference check in the mech report; V2-pocket and V2-posts put the receptacle on the PCB underside at azimuth 0 without a tab (plain D 46 disc), conflict with SYS-022 and need a window open through the floor edge, and V2-posts raises the housing by 0.56 mm. V2 would give a plain circular outline and free the top side, so it is worth a second spike if V1 stays infeasible.

### 10.2 Conflicts between the mech placeholders and the real parts of the schematic
The board uses the real footprints of the schematic. Each item is a finding for the owner, not a fix I may decide.
- **Receptacle depth.** The mech spike puts the mouth at R 29.85. With the real WS2812B 5 x 5 pads (reach R 22.3) and the J1 footprint (rear pad edge 9.5 mm behind the mouth) the rear pads of J1 overlap D1 and D16. The generator moves J1 out until the rear pad edge clears the LED pads by 0.45 mm: mouth at R 32.19 mm, tab to R 31.34 mm. Largest housing dimension then about **59.8 mm, above the 58 mm limit (MECH-001)** by 1.8 mm. Open: smaller LEDs or receptacle, a shifted LED phase, a larger limit, or variant V2.
- **LED size.** The mech model uses a 2 mm placeholder LED (corner at R 21.02). The 5 x 5 mm WS2812B reaches R 22.7, which leaves 0.3 mm or less to the edge, overlaps the hook lug areas (DRC `items_not_allowed`: D2 in the hook 30 area, D7 and D8 in hook 150, D13 in hook 270) and puts D5 against the notch (pad 4 of D5 touches the edge, 0.000 mm clearance). Neighbouring LED courtyards overlap (D8/D9, 7.85 mm pitch).
- **Button.** The schematic has a top-actuated TL3342; the mech model has a side-actuated switch at the edge. SW1 is placed inside the ring at R 13, 240 deg. A side-actuated part is needed for the housing hole at the wall.
- **Antenna keep-out.** The vendor zone of 15 mm beyond the module end is not met: the LED ring is 10.16 mm from the antenna edge (mech report 5, "a PCB matter, ADR-0003"). The board keeps only the module's antenna strip (5.4 x 13.2 mm) free of copper and parts on all layers, as a rule area. The module footprint's own 43 x 20 mm keep-out was removed from the board because it would cover half of the PCB. No RF analysis was done.
- **Receptacle on the LED side.** J1 is on the top side at the tab, outside the ring.
- Mech V2 and the posts: the bottom side has 3.0 mm of height, so bottom-side parts must be lower than about 2.5 mm; the footprint heights were not checked.

### 10.3 Placement
- LEDs D1 to D16 on the top side at R 20, azimuth 3.75 deg + k x 22.5 deg, with the footprint rotated so that DOUT of one LED faces DIN of the next. Bypass caps C8 to C23 on the bottom side under the LEDs; the caps of D2 and D13 are moved 2.5 mm tangentially to clear the base posts.
- Module U9 at the centre (offset 1.0 mm), antenna to -X. J1 on the tab. SW1 inside the ring.
- The other 51 parts: a simulated-annealing placer (`pcb_place.py`, seeded, half-perimeter wire length plus overlap penalty, parts may sit on either side) in the region R <= 16.6 mm, outside the module and the antenna strip; on the bottom side also on the tab. Result: no overlapping parts (pad extent plus margin), wire length 474.8 mm (HPWL), seed 1, 160 000 moves, about 7 s. Test points go to the bottom side.
- Determinism: two builds in one process and builds under three different `PYTHONHASHSEED` values give the same file (checked by `sha256`, the first run showed that sets in the cost sum made the result depend on the hash seed; fixed by sorting). The earlier routing runs `m2` to `m5` and `n2`, `n4` in the scratchpad were made before this fix; the numbers in 10.5 are from runs `f2` and `f4` on the final code.
- Both layers carry GND (2 layers: pours on F and B) or GND on In1 and +5V on In2 (4 layers).

### 10.4 Freerouting settings
Freerouting v2.5.0 (release 2026-10-05), jar `freerouting-2.5.0.jar`, sha256 `f6f51bb02245e8e717f9359bd260cc9c5c0b1bc0acc8b7cb2cd5b8ffeb5de3c7`, downloaded with `gh release download` from the official GitHub releases (not committed). Java 27 (OpenJDK). Command: `java -jar freerouting-2.5.0.jar -de b.dsn -do b.ses -mp 60 -mt 4`, defaults otherwise (greedy optimiser, which only runs on a fully routed board). DSN from `pcbnew.ExportSpecctraDSN`; SES imported with `pcbnew.ImportSpecctraSES`, then the zones are filled. Net classes: VBUS_IC and +5V 0.6 mm, +3V3 0.4 mm, default 0.2 mm, clearance 0.15 mm, via 0.6/0.3 mm. Freerouting is not seeded in a way I controlled; the runs `n2` and `f2` (2 layers, planes F and B, 0.6 mm) gave 19 and 31 unrouted connections from different placements, so a second run can differ.
Freerouting treats a net with a pour as a plane net and writes no vias for it. `pcb_stitch.py` adds a via and a short track at each pad of GND or +5V that the DRC reports as unconnected (clearance-checked against pads, tracks, vias, edge and the antenna strip); module ground pads may take a via in the pad. Vias in pads need filled or capped vias at the fabricator (not checked).

### 10.5 Results (runs f2 and f4, final code)
| | 2 layers (planes F and B) | 4 layers (In1 GND, In2 +5V) |
|---|---|---|
| Freerouting, unrouted connections at the end of 60 passes | 31 (173.6 s) | 39 (185.8 s) |
| After import and plane vias: DRC unconnected items | 106: GND 38, +5V 35, VBUS_IC 12, +3V3 11, LED_DATA 2, SEL_STEP2_GPIO 2 | 57: GND 49, +5V 3, ILIM_STEP3_EN 1, CC_OK_NOT_S3 1, CC_OK_1A5 1, U9 GPIO2 strap 1 |
| DRC violations that are not courtyard, silk or library warnings | starved_thermal 7, track_width 4 (0.12 mm tracks, minimum 0.15), copper_edge_clearance 2, pth_inside_courtyard 1, items_not_allowed 5, via_dangling 37 | copper_edge_clearance 2, pth_inside_courtyard 1, items_not_allowed 5, hole_to_hole 1, via_dangling 5 |
| Clearance and short errors | none reported | none reported |
| Courtyard overlaps | 51 (origin not analysed; includes the module's library courtyard) | 51 |
| Vias / track length | 72 / 523 mm | 143 / 693 mm |
| VBUS_IC (1.5 A path) | 8.6 mm routed, 12 connections unrouted | 83.1 mm, all connections routed; 77.2 mm at 0.6 mm and 5.9 mm (7 %) at 0.2 to 0.45 mm near pads |
| CC1 / CC2 | routed, 8.6 / 11.4 mm | routed, 8.0 / 11.5 mm |
| ILIM net | 14.8 mm | 11.7 mm |
| Gate star at the Q3 gate | `/ILIM_STEP3_EN` routed, 15.3 mm | one connection unrouted, 14.7 mm routed |
| Net comparison against the schematic netlist | 0 pad-net differences, 86 of 86 refs | same |
Reading: neither board is DRC clean and neither is fully routed. The 4-layer board routes the signals, the CC lines and the whole VBUS_IC path; its remaining unconnected items are mostly ground: 49 GND items, of which 22 are module ground pads that could not get a via (dense pads, antenna strip) plus pads in tight areas. The `via_dangling` count of the 2-layer board (37) comes from stitching vias that reach no second copper. Earlier runs on an older placement: 2 layers with planes on F and B at 0.8 mm VBUS width 31 unrouted; plane on B only 53; no planes, 4 layers, 48; 4 layers with planes, 0.8 mm, 40; 2 layers at 0.6 mm 19 (the last on the placement before the determinism fix).

### 10.6 Layer decision (owner rule: try 2 layers first, 4 layers only if 2 layers is really hard or infeasible)
Evidence for the switch, with the 2-layer result kept alongside:
- Freerouting could not complete 2 layers in any of four runs (31, 53, 19 and 31 unrouted connections; each run started with 143 unrouted nets and had at most 40 to 60 passes); 0 violations by its own checker, but unconnected.
- The VBUS_IC path at 0.6 mm stays unrouted on 2 layers (12 to 13 connections), the 1.5 A width rule cannot be met there. It is routed on 4 layers.
- The ground return cannot be made a plane on 2 layers because parts sit on both sides and the pour is cut up (7 starved thermal connections, 38 GND items unconnected).
- Contributing causes, not proven separately: movable parts limited to R 16.6 mm inside the ring, 51 parts on two sides, a 16-LED +5V ring, the antenna strip, and a 5 x 5 mm LED ring on a 46 mm board.
On this evidence I took the 4-layer result as the spike's main result. This is a spike decision for the owner to confirm; a 4-layer board changes cost (HW costs, SYS-021) and needs ADR-0012 to cover it.

### 10.7 Comparison with the own grid router
Not run on the new board: `src/route_grid.py` knows only the old rectangular outline (it stays in the repository, untouched, as the record of the first run). Its first-run numbers (138 of 141 connections on the 136 x 64 mm rectangle, 225 vias) are not comparable with the numbers above. Freerouting finished 2 layers with more unrouted connections than the grid router left on the rectangle, but on a board with about a fifth of the area (about 1700 mm2 against 8700 mm2).

### 10.8 Weak points of the first run: status
- **CC lines:** routed on both variants (8 to 11.5 mm each). The lengths are not matched or shielded; Rd/CC rules from the CC IC datasheet were not applied.
- **VBUS width:** 0.6 mm at 1.0 oz external, 10 K rise. The highest current limit in the top step is 1577 mA (E192 0.1 % set); IPC-2221 gives 0.56 mm for 1.577 A (0.53 mm for 1.5 A, 0.78 mm for 2.0 A). The router necks the track to 0.2 to 0.45 mm for 5.9 mm in total at pad exits on the 4-layer board; the rule is not met for those parts. Not checked: the TPS2553 and connector pad neck-down against the thermal limit.
- **Thermal relief:** the TPS2553 and the regulator have no extra copper area or thermal vias; only the pour spokes. With 3.0 mm free under the PCB and the closed housing the thermal question is open.
- **R3 and the U13 tap at the Q3 gate:** the placer keeps R3 within 6 mm of Q3 (tested); the router does not enforce a star. The ILIM net is 11.7 mm (4 layers).
- **Remaining:** 57 unconnected items and 5 DRC findings on the 4-layer board (LED against hook areas, D5 against the notch, one J1 pad in the D1 courtyard, a via pair at 0.11 mm hole distance), and every conflict of 10.2.

### 10.9 Not run
- No signal-integrity, EMC, antenna, thermal or current-density analysis; no fabricator DFM check (via in pad, 0.12 mm tracks, minimum drill, 4-layer stack-up, impedance); no 3D or housing fit (the FreeCAD model was not opened; footprint heights not checked against the 3.0 mm under-PCB space); no comparison with V0 or V2; no second Freerouting setting study (passes, greedy against global optimiser); no SPICE; no bench.
- The stub vias of `pcb_stitch.py` are a heuristic; 49 GND items stay open.
- The TUSB321 land pattern, the module footprint (C6 library part for the C3 module), the regulator and the placeholder capacitor sizes of the first run are still unverified (section 4).
- No compliance claim. Nothing in this section is approved or accepted.

### 10.10 Owner items
Choose the layer count (the evidence is in 10.5 and 10.6) and whether ADR-0012 covers a 4-layer board. Decide the receptacle conflict (10.2: 59.8 mm against the 58 mm limit; options: smaller LED, shifted LED phase, larger limit, variant V2). Choose a side-actuated button. Decide how to treat the antenna keep-out against the LED ring (ADR-0003). Confirm that Freerouting v2.5.0 may be used in this flow, and the via-in-pad rule for the module ground pads.

## Update 2026-11-07: rerun with the AND gate and the supply-pin protection (HW-010, ADR-0018)
- Command: `run_full.sh`, then `run_pcb.sh <dir> <out> 4 inner` with Freerouting v2.5.0 (pinned jar, KiCad 10.0.6). The placer put the new parts (R_SU1, R_SU14, R_SU15, C26, DZ1, DZ14, DZ15, the AND gate U10) without a change to the placement rules.
- Observed: unplaced-board DRC (4 layers, no router): only `unconnected_items` above the waiver (266 > 241). Routed: Freerouting started with 266 unrouted connections and finished with 48 unrouted and 0 violations in 221 s; M1 (routed board, plane nets excluded) 3 unrouted. Stitched: 247 DRC findings = 46 violations + 86 unconnected items on 4 nets (/CC1, /GATE_OK_RB, GND, one 887 k net) + 110 schematic-parity warnings (84 net_conflict, 26 footprint_symbol_mismatch, the known placeholder and stand-in cases).
- The strict waiver check **fails**: 86 unconnected items, 6 track_width errors, 9 via_dangling warnings and 1 hole_to_hole warning are not on the waiver list. This is worse than the earlier run on unconnected items and has not been analysed. Routing is not deterministic.
- Not done: the net fixture `tests/data/full.net` and the committed DRC fixtures are not refreshed; no manufacturing check; the new parts are not placed with intent (the annealer did it).

## Update 2026-11-07: strict-gate fixes after the AND-gate rerun (HW-010, DEV-006)
- Causes found: Freerouting 2.5.0 writes 0.10 and 0.12 mm wires at tight pads (the SES file has them), so `track_width` failed; it also leaves vias with copper on one layer (`via_dangling`); the stitcher checked every pad against all layers and in sorted order, so a pad never joined a via that its neighbour got later; the stitcher did not check hole-to-hole distance between vias of the same net.
- Changes: default track 0.15 mm (the 0.2 mm default made the router squeeze); dangling vias removed before stitching; stitcher retries in passes and joins existing ground vias with a track on the pad's layer only; via search keeps 0.7 mm centre distance to every via; silk of U9, U2, U4, TVS2 and J1 ignored by a named `.kicad_dru` rule (DEV-006, proposed).
- Observed (run on the full flow, 4 layers, planes `none`, Freerouting 522 s, 34 unrouted in its log; one run, not deterministic): stitched board strict check: `clearance`, `track_width`, `via_dangling`, `hole_to_hole`, `isolated_copper`, silk classes and `lib_footprint_mismatch` all 0; still failing: `unconnected_items` 50 (21 ground pads of the module U9 inside the antenna keep-out, 7 small ground pads, the rest on signal nets the router left open) and `track_dangling` 2 (ends of the open signal nets).
- A via in a U9 ground pad inside the keep-out was tried; it gave 18 `items_not_allowed` and dangling vias (the inner plane has the cut-out), so it was reverted.
- Not run: a second router run; the committed DRC fixtures are not refreshed.

## Update 2026-11-07 (later): antenna strip corrected, slot added (HW-005, ADR-0003, DEV-004)
- Cause of the 21 module ground pads in the strip: the strip was 5.4 mm and the pad area was centred in the module body. The ESP32-C3-MINI-1 datasheet v2.2 (fig 11-1, section 3.1) puts the antenna area beyond the pad rows: 16.6 - 11.2 - 0.8 = 4.6 mm, and the pad area is not centred. The board also uses the ESP32-C6-MINI-1 footprint as a stand-in for the C3 (pad rows 9.8 mm apart, as in the C3 figure; other dimensions not compared).
- Changes: `MOD_ANT_L` 4.6 mm; U9 placed so that its pad area starts at the end of the strip (moved 1.6 mm toward +X); a 1.0 mm slot in Edge.Cuts 1.5 mm beyond the antenna end (owner idea, vendor guide 1.4.7 advises cutting the board around the antenna), with a copper keep-out of 0.5 mm round it because the router does not see Edge.Cuts slots (first run without it: 22 `copper_edge_clearance`); tests for the strip length, the pad position and the slot (pure and pcbnew).
- Observed (one run, Freerouting 177 s, 20 unrouted in its log): stitched board strict check: 0 unconnected ground items, 0 copper-edge, 0 silk, 0 `via_dangling`, 0 `track_width`, 0 `hole_to_hole`; still failing: `unconnected_items` 30 (14 on VBUS_IC, 14 on +3V3, 1 /ILIM_STEP2_EN, 1 /CC_OK_NOT_S3), `clearance` 2 (an In2 track at 0.114 and 0.121 mm from a SUP_CT via), `track_dangling` 1.
- Not done: the slot is not in the housing or the mechanical model (the housing has no part under it; posts and hooks are at 30, 150 and 270 degrees); no RF check that the slot helps; the real C3 footprint (pad sizes) is not drawn; fabricator slot rules not checked (1.0 mm router bit assumed). The STEP model is saved in the datasheet folder; the Autodesk footprint source link of the datasheet returns 404.

## Update 2026-11-07 (last): placement and routing experiments (HW-010, ADR-0012)
All runs: same netlist, 4 layers, Freerouting 2.5.0, KiCad 10.0.6, strict check of the stitched board (`stitched-4l`). Numbers are from single runs.

| Run | Change | Unconnected items | Other strict findings |
|---|---|---|---|
| A | antenna strip 4.6 mm, slot, slot keep-out | 30 | 2 clearance, 1 dangling track |
| B | threads 1, 2, 4 and passes 25 to 150 | 30 each (identical) | same; the router is deterministic here, its settings are exhausted |
| C | +3V3 width 0.4 to 0.3 mm (1.0 A by IPC-2221, TLV757P rating) | 23 | 0 clearance, 5 dangling tracks |
| D | C plus VBUS_IC placement weight 3.0 and `R_MOVE` 16.6 to 17.3 mm (owner choice: loosen the ring) | **14, all VBUS_IC** | 1 clearance, 1 dangling track |
| E | D with VBUS_IC routed first and locked (`KEYFIRST=1`) | 8 (2 GND, 5 USB data, 1 UART RX) | 4 clearance, 3 dangling tracks |
| F | E with the four USB data nets also first | 12 | 11 clearance |
| (earlier) | all 17 key nets first and locked, before the placement change | 56 | 2 `items_not_allowed` |

- Reading: placement was the lever (D); routing order is not: locking the first stage's tracks pushes the failure to other nets (E, F). Neither D nor E is clean.
- The 14 items of D are the pads of VBUS_IC (R_SU1, R_SU14, R_SU15, R_VD, R1, R6, C2, TVS1, U5, U6, U7 and the J1 pins), a net of 10 or more pins that is routed at 0.6 mm everywhere, although only the path J1 to U6 carries the 1.5 A; the branches (supply-pin resistors, divider, TMUX supply) carry microamps. A router class cannot give one net two widths.
- Options that need a decision (not made): (a) a VBUS_IC copper pour on one layer near the connector; (b) a schematic change that names the low-current branches as a separate net behind the main path; (c) narrower tracks on the branches by a post-route step that is not yet written.
- Not done: no commit; the committed DRC fixtures and the README images are not refreshed; no electrical or RF check of the result.

## Update 2026-11-07 (main path split): VBUS_IC routed in two classes (HW-010, ADR-0012)
- Idea: only the path connector J1, TPS2553 input (U7 pin 1), C2 and TVS1 carries the switch current (up to 1.577 A, 0.6 mm by IPC-2221). The other pins of VBUS_IC (supervisor, ESD part, dividers, supply-pin resistors, enable) draw microamps. `run_pcb.sh` with `KEYFIRST=1` routes the main path alone at 0.6 mm (stage 1), locks it, then routes everything else with the VBUS_IC class at `BRANCH_WIDTH` 0.2 mm (stage 2); the branches join the locked main path. No schematic change. Code: `pcb_rules.MAIN_PATH_PADS`, `is_main_path_pad`, `pcb_dsn.py keyonly` and `branchwidth`.
- Observed, one run each (4 layers, planes `inner`, Freerouting 2.5.0; the router is not deterministic with 4 threads):

| Run | Setting | Unconnected | Clearance | Dangling |
|---|---|---|---|---|
| pl4 | planes `none` | 2 | 1 | 0 |
| pl5 | planes `inner` | **3** | **0** | **0** |
| pl6 | `inner`, In1 and In2 as power layers in the DSN | 22 | 3 | 0 |
| pl7 | as pl5 (same settings), after changing the via removal | 7 | 5 | 1 |

  pl5 and pl7 have the same settings; the difference is router variance, not a design change. The best run is not a result that can be repeated on demand.
- Reading: the split removes the VBUS_IC problem (stage 1 routes all main-path nets without an open item; the 14 open VBUS_IC items of the single-pass run are gone). What is left is 2 to 12 mixed findings that change from run to run: ground stubs, /ILIM_STEP2_EN, a few clearance findings at U9 and a via. Marking In1 and In2 as power layers (so that signals stay off the planes) leaves the board unroutable (pl6): this stack needs signals on the inner layers, and the router puts some VBUS_IC and signal tracks on In1 and In2, which cuts the GND plane in places. That is a layout weakness, not checked electrically.
- Via removal: a via that the DRC calls dangling is removed only when no pad is there and its track ends lie on one layer (`pcb_rules.joins_nothing`); the earlier version could remove a layer change.
- Not done: no run is clean; no repeatable result; a post-route cleanup of the leftovers (a small maze router, or hand-placed copper by script) is the next step; the README images and the DRC fixtures are not refreshed; no commit.

## Update 2026-11-07 (clean-up): post-route grid router `pcb_fix.py` (HW-010, ADR-0012)
- Method: after Freerouting and the stitcher, `run_pcb.sh` (`CLEANUP=1`, default) calls `src/pcb_fix.py auto`: up to 3 rounds of (1) remove the track run (up to junctions, vias and pads) at each `clearance` finding, (2) connect every `unconnected_items` pair with a deterministic A* grid router (0.05 mm grid, four layers, through vias; obstacles are the copper of other nets, the board edge, the slot, rule areas and the hole-to-hole distance, grown by the clearance plus half the track width plus 0.06 mm), (3) rip up and reroute a net from its pads when a pair still fails (also with the nearest blocking nets; all or nothing), (4) remove free-ended track pieces and dangling vias, (5) check with the strict DRC. The result is `final.kicad_pcb`. The router is checked only by the KiCad DRC.
- Observed (run pl8: `KEYFIRST=1`, planes `inner`, Freerouting 2.5.0, KiCad 10.0.6; the clean-up itself has no random part): stitched board 5 unconnected items and 135 findings; after the clean-up **1 unconnected item** (/ILIM, U7 pin 5 on the back to R_ILIM3 on the front) and in the strict check only the tolerated known classes: `courtyards_overlap` 14 and `items_not_allowed` 1 (both U9, DEV-004), `footprint_symbol_mismatch`, `net_conflict`, `ignored_checks`. Clearance, track width, hole-to-hole, copper-to-edge, silk (DEV-006), dangling vias and dangling tracks: 0.
- Rerun of the clean-up alone on the same stitched board of pl8: rounds gave 2, 8, 1, 1 open items (the second figure is after the ripup step, before routing).
- Open: the /ILIM connection (pin 5 of the TPS2553 sits in a crowded spot on the back); Freerouting's own output varies from run to run, so the stitched input differs between runs (pl5 to pl8: 3 to 7 open items); the clean-up has been run on pl7 and pl8 only. The inner layers still carry some signal and VBUS_IC tracks (cuts in the GND plane, not checked electrically). Stand-in footprints, antenna arrangement (DEV-004), electrical and RF checks: not done.
- Tests: `tests/test_pcb_fix.py` (6: description parsing, track runs, counts, a real route round a foreign pad on a small board with the clearance checked, a blocked board gives no path); 87 tests pass in the pcb, mech-outline, placement and run-script files.

## Update 2026-11-07: ignored checks switched on, six repeat runs

- Change: the generated project files now switch on the checks KiCad ignores by default. ERC: `single_global_label`, `four_way_junction`, `simulation_model_issue`, `footprint_filter` (`lib_tables.ERC_ON`). DRC: `missing_courtyard`, `track_not_centered_on_via`, `tuning_profile_track_geometries`, `footprint_filters_mismatch`, `footprint_type_mismatch` (`pcb_full.DRC_ON`). The ignored-check maxima in `known-open-violations.json` are 0 now.
- ERC (`run_full.sh`, `SPIKE_ALLOW_KNOWN_OPEN=0`): 0 findings, drawn nets equal intent nets (55), output identical on a second run.
- Six full flows in parallel (`KEYFIRST=1`, planes `inner`, 4 threads each, runs q1 to q6): open items after the clean-up 2, 1, 3, 1, 0, 0. Runs q5 and q6 have 0 open items, no clearance, track-width, dangling-via, hole or edge finding, strict DRC (`SPIKE_ALLOW_KNOWN_OPEN=0`) shows only the tolerated items: courtyards_overlap 14 and items_not_allowed 1 (U9, DEV-004), footprint_symbol_mismatch 26, net_conflict 84, and the new `footprint_filters_mismatch` 16 (the LED stand-ins D1 to D16, DEV-002, added to the waiver list). So 2 of 6 runs end complete; the flow is not deterministic (Freerouting).
- Local fix of /ILIM by rip-up of neighbouring ground and +5V stubs failed on the pl8 board: the VBUS_IC main path on In1 and the TPS2553 pin pattern block every layer. Not pursued; repeated runs were the cheaper way.
- Not run: schematic-to-board parity beyond the DRC parity items, electrical checks of the plane cuts by VBUS_IC tracks on In1/In2, RF check. Tests: 96 passed in pcb_full, pcb_fix, pcb_rules, lib_tables, mech_outline, pcb_place; `test_gate_logic.py` errors without a checkout change (missing dependency, not analysed).

## Update 2026-11-08: real footprints, best-of-N, power check

- Footprints (from the datasheets, tests in `tests/test_pcb_full.py`): U9 is `CUSTOM:ESP32-C3-MINI-1`, the library C6-MINI-1 pads without zone and 3D model; the numbers equal datasheet v2.2 figure 11-1 (48 pads 0.8 x 0.4, four 0.7 corner pads, 3 x 3 grid of 1.45 mm ground pads, rows 11.9 and 9.9 mm). U1 land pattern redrawn from TI drawing RWB0012A (read as an image); **the earlier provisional pattern was wrong** (pad sizes and rows). U8 is TLV75733PDBV in SOT-23-5 (ADR-0019), EN tied to IN, pin 4 marked no-connect. The LEDs use the KiCad symbol `LED:WS2812B-2020` with the 2020 footprint (ADR-0004; the part number is still open). **Finding:** the 2020 symbol numbers its pins 1 DOUT, 2 VSS, 3 DIN, 4 VDD; the earlier board paired the 5050 symbol numbers (1 VDD, 2 DOUT, 3 VSS, 4 DIN) with the 2020 footprint, which would have wired the LEDs wrong. Still stand-ins: C3 (0805) and C4 (1206), values open; test points and mounting holes.
- ERC: 0 findings. `footprint_symbol_mismatch` fell from 26 to 8.
- Routing (`run_best.sh`, 6 parallel runs, `KEYFIRST=1`): with VBUS_IC and +3V3 kept off the inner layers (`OUTER_ONLY=1`, a `use_layer` rule in the DSN, honoured by `pcb_fix.py`) the best run has 4 open items; with the inner layers allowed (`OUTER_ONLY=0`) the best run has 1 open item (U9 GPIO8 to R17) and the others 4 to 9. So the plane protection costs routability on this placement.
- Best run (inner allowed) under strict DRC: 1 unconnected item, 1 `connection_width` (a 0.14 mm ground stitch track), 1 `silk_overlap` (U6, DZ15), `lib_footprint_issues` 100 (limit 93); the rest tolerated as before. **It does not pass the strict gate.**
- Power check (`src/pcb_power_check.py`, 0.1 mm raster, copper 35 um outer and 17.5 um inner assumed; currents are the analyst's assumptions, the 50 mV target is not a requirement): on that board VBUS_IC J1 to U7 85 mV at 1.5 A (57 mOhm), +3V3 53 mV at 0.5 A (106 mOhm), +5V 24 mV at 1.0 A. Both VBUS_IC and +3V3 miss 50 mV. The GND plane (In1) has 5 pieces with 36.5 % removed and carries 285 mm of signal track; the +5V plane (In2) has 2 pieces, 38 % removed, 299 mm of signal track. Run q5 (old footprints, same method) had VBUS_IC at 47 mV. The solver result for a net with no joined path is reported as `inf`/null; copper thickness, current crowding and temperature are not modelled.
- Not run: the flow on a placement tuned for the real footprints; antenna or RF checks; fabricator rules; thermal.
- Owner decisions 2026-11-08 (session): VBUS_IC and +3V3 stay off the plane layers (`OUTER_ONLY=1`, default); DEV-006 silk waiver declined, so it is off by default now (`SPIKE_SILK_WAIVER=1` for comparison) and the silk findings count again; DEV-004 stays open; DEV-002 shrunk and the ignored-check part of DEV-003 closed (texts in `docs/standards/deviations.md`). Consequence: the board needs a placement made for the real footprints before it routes complete with the plane rule on (best run with the rule: 4 open items).

## Update 2026-11-08 (later): re-placement for the real footprints

- Method: `run_best.sh` with 8 runs; run i uses the placement seeds 16(i-1)+1 to 16i (`PLACE_SEED_START`), plane rule on (`OUTER_ONLY=1`), `KEYFIRST=1`, real footprints. Open items after the clean-up per run: 6, 13, 7, 5, **1**, 12, 17, 26 (the last two also have 1 hard finding). Earlier batch with the old placement and the same rule: best 4.
- Best run (run 5): 1 open item, a pair of GND copper clusters at about (38.4, 30.3) mm (R2 pin 2 side on F.Cu and U4 pin 2 side on B.Cu); both clusters have ground vias, so the likely cause is a split In1 ground plane there (not confirmed; the plane has 4 pieces). Findings: courtyards_overlap 15 (limit 16), items_not_allowed 1 (U9), silk_edge_clearance 2 (J1; the silk waiver is off). It does not pass the strict gate.
- Power check on that board: VBUS_IC 34.5 mOhm, 51.8 mV at 1.5 A (target 50 mV, an analyst value, narrowly missed); +3V3 26.4 mV at 0.5 A; +5V 23.5 mV at 1.0 A. In1 (GND): 4 pieces, 26.6 % removed, 316 mm of signal track still on it; In2 (+5V): 1 piece, 31 % removed, 293 mm of signal track. The plane rule moves VBUS_IC and +3V3 only; the signal nets still use In1 and In2.
- Not done: close the last open item; keep the signals off In1; fix the J1 silk at the board edge; analyse `lib_footprint_issues`.

## Update 2026-11-08 (night): fine rules, ground plane kept solid, fabricator facts

- Fabricator facts (JLCPCB, read 2026-11-08, only this fabricator): capability page, multilayer column: track and space 0.09 mm (1 oz), via hole minimum 0.15 mm, via diameter minimum 0.25 mm, annular ring recommended 0.20 and absolute minimum 0.15 mm, via hole to hole 0.2 mm, pad hole to pad hole 0.45 mm, pad to track 0.1 mm, SMD pad to pad 0.15 mm, copper to routed edge 0.2 mm. Stack-ups JLC04161H-7628 and -3313: outer copper 35 um, inner copper 15.2 um (0.5 oz). My first experiment profile (via 0.45 / 0.2, ring 0.125) was under the absolute ring minimum; it was stopped and rerun with 0.5 / 0.2 (ring 0.15). The power check now uses the 15.2 um inner copper.
- Rules in the code: `SPIKE_PROFILE=fine` (0.1 mm track and clearance, vias 0.5 / 0.2), `SPIKE_IN1_SIGNALS` (0 default: In1 carries GND only; the router gets `use_layer` rules for every class), `OUTER_ONLY` (VBUS_IC, +3V3 outer layers). The J1 footprint is a project copy without the three silk lines at the board edge (`CUSTOM:USB_C_Receptacle_GCT_USB4085_edge`).
- Experiment (4 runs each, placement seeds 1 to 64, `run_best.sh`, `KEYFIRST=1`, new footprints): signals allowed on In1 (`exA`): open items after the clean-up 0, 2, 1, 1. Signals off In1 (`exB`): 0, 4, 0, 2. Earlier, spike rules: best 1 (In1 allowed) and 6 (In1 closed).
- Best run `exB` run 3 under the strict gate (`SPIKE_PROFILE=fine`, `SPIKE_ALLOW_KNOWN_OPEN=0`, board in its run folder with its libraries): 0 unconnected, no clearance, width, edge, hole or silk finding; tolerated only: courtyards_overlap 14 and items_not_allowed 1 (U9, DEV-004), footprint_symbol_mismatch 8, net_conflict 77. ERC 0 findings. In1 (GND): 1 piece, 11.7 % removed, no signal track; In2 (+5V): 2 pieces, 29.7 % removed, 444 mm of signal track.
- Power check on that board (15.2 um inner copper): VBUS_IC 39.6 mOhm, 59.3 mV at 1.5 A (above my 50 mV target, an analyst value; not a requirement), +3V3 24.2 mV at 0.5 A, +5V 11.8 mV at 1.0 A.
- Not run: the batch with the annular ring raised to the recommended 0.20 mm; a fabricator DFM check; other fabricators; thermal; antenna and RF; a repeat of this result (2 of 4 runs complete on exB, not a guarantee); the VBUS_IC path is not yet widened or shortened.
- Decision draft: `docs/decisions/ADR-0020-pcb-fab-rules-and-inner-layer-use.md` (Proposed).

## Update 2026-11-08 (late): generated LED ring cells, pin swap check

- Ring cells (`src/pcb_ring.py`, tests `tests/test_pcb_ring.py`, 4 tests): the 16 LEDs on the top layer and their bypass capacitors on the bottom layer form one cell each; the capacitor is turned so its +5V pad lies under the LED +5V pad (14 of 16 cells within 1 mm; D2 and D13 are shifted by the placement). Per cell: +5V and GND, LED pad to via to capacitor pad (grid router of `pcb_fix.py`, outer layers only, 0.25 mm stubs; the vias meet the In2 and In1 planes), and the data link DOUT to the next DIN (15 links, 0.1 or 0.15 mm). All 47 links complete on the placed board; no clearance, hole, edge or width finding in the test. The ring is locked before the autorouter runs; the router does not see the +5V pads of the ring (`RING=1`, default; the DSN export blanks them).
- Effect (12 and 8 run batches, fine rules, signals off In1): complete runs 2 of 8 (first batch) and 3 of 8 (second batch); the strict gate leaves one or two small findings on each complete run (dangling track, off-centre track end on a via, silk). VBUS_IC drops 37.8 mV at 1.5 A on the best run of the first batch (was 59 mV without the ring cells) and 44.8 mV on the best of the second; +5V plane in 1 piece, 18.7 to 28 % removed; GND plane 1 piece, 11.5 % removed, no signal track.
- Pin swaps: the module pads of the eight movable GPIOs (GPIO0, 3, 4, 5, 6, 7, 10; GPIO1 and 4 are reserved for the sensor) were tested over all assignments on the placed board, wire length (half perimeter) 77.4 mm now, best 75.2 mm: a 3 % gain. The pin map is written into HW-010 and the ADRs. Not changed.
- Picker: `pcb_pick.py` ranks runs by open items, then by the FAIL lines of the strict gate; `run_best.sh` copies the libraries with the best board.
- Not run: a batch that finishes with the strict gate clean (running when this was written); fabricator DFM check; antenna and RF checks; thermal check.

## Update 2026-11-08 (end of day): 12 runs with the ring cells and the strict-gate picker

- `run_best.sh`, 12 runs, fine rules, ring cells, signals off In1: open items after the clean-up 2, 8, **0**, 3, **0**, **0**, 3, 7, 1, 1, 4, **0**; strict FAIL lines per run 4, 3, 1, 2, 2, 3, 3 ...; 4 of 12 runs have no open item.
- Best run (run 3): 0 open items; one strict FAIL left: `connection_width` 1 (a ground neck under 0.1 mm); everything else tolerated (courtyards_overlap 14, items_not_allowed 1 on U9, footprint_symbol_mismatch 8, net_conflict 77). VBUS_IC 37.8 mOhm, 56.6 mV at 1.5 A on this run (the best runs of the other batches gave 37.8 and 44.8 mV; the value varies from run to run), +3V3 35.6 mV at 0.5 A, +5V 9.7 mV at 1.0 A. GND plane 1 piece, 11.7 % removed, no signal track; +5V plane 1 piece, 26 % removed.
- After the batch: `connection_width` was added to the findings the clean-up removes and routes again (`pcb_fix.RIPUP_KINDS`); not rerun. So no run passes the whole strict gate yet; the nearest has one warning.
- Not run: the batch with that change; the VBUS_IC path is not yet fixed by constraint (drop varies 38 to 59 mV against my 50 mV target); fabricator DFM check; antenna and RF; thermal.

## Update 2026-11-08 (late): `connection_width` clean-up and power-path ties (HW-010)

Fine rules, ring cells, 12 runs per batch, same inputs (`full7`). Evidence: `ring4.log`, `ring5.log` in the session scratchpad (not committed).

| Batch | Change | Runs with 0 open items | Runs with 0 strict findings | Best run | Drops VBUS_IC / +5V / +3V3 (mV) |
|---|---|---|---|---|---|
| ring4 | `connection_width` added to the rip-up kinds | 4 of 12 (runs 3, 5, 6, 9) | 1 (run 3) | run 3: gate clean (waived items only) | 38.8 / 8.9 / 56.6 |
| ring5 | plus soft placement ties J1 A4, J1 B9, C2.1 to U7.1 (weight 3) and U8.5 to U9.3 (weight 6) | 1 of 12 (run 4) | 0 | run 4: 0 open, 3 strict warnings (`silk_over_copper` 1, `track_dangling` 1, `track_not_centered_on_via` 1) | 9.5 / 13.0 / 18.1 |

Reading: the ties cut every drop by a factor of 2 to 3 (the +3V3 drop falls from 56.6 to 18.1 mV, below the 50 mV analyst target), but routing completion got worse in this batch (12 runs only; Freerouting is not deterministic, so the difference may be partly chance). The 50 mV target is an analyst assumption, not a requirement. The ring5 best run is not gate-clean; the ring4 best run is, but its +3V3 drop is above the target. Not run: lower tie weights, more runs.

### ring6: tie weights halved (VBUS_IC ties 1.5, +3V3 tie 3.0)

12 runs, same inputs. Evidence: `ring6.log` (session scratchpad, not committed).

| Runs with 0 open items | Runs with 0 strict findings and 0 hard findings | Best run | Drops VBUS_IC / +5V / +3V3 (mV) | GND plane | +5V plane |
|---|---|---|---|---|---|
| 4 of 12 (runs 3, 4, 5, 6) | 2 (runs 4 and 6) | run 4 | 16.5 / 19.9 / 41.5 | 1 piece, 11.8 % removed | 1 piece, 22.4 % removed |

Reading: the halved ties keep routing completion at the ring4 level and still bring all three drops under the 50 mV analyst target (an assumption, not a requirement). This is the chosen setting. One batch only; Freerouting is not deterministic. Not run: antenna/RF, thermal, fab DFM check of the result.

## Update 2026-11-08 (evening): datasheet pad numbers on U1 and U9, test points out of the BOM (HW-010)

Change: the box symbols of U1 (TUSB321) and U9 (ESP32-C3-MINI-1) carry the pad numbers of the datasheets (`layout_full.PAD`; TI SLLSEO6C section 5; Espressif datasheet v2.2 table 3-1, the nine centre pads are pin 49). The name-to-pad table `pcb_full.PADMAP`, which only the board side used, is deleted, so the DRC schematic parity check now covers both parts. The test point symbols are out of the BOM, like their footprints. ERC 0 findings, intent and drawing 55 nets each, two builds identical (`full8`). Tests: `test_layout_full.py` 30 pass (new: datasheet pad numbers, 22 GND pads on GND, test points out of the BOM); `test_pcb_full.py`, `test_kicad_strict.py`, `test_pcb_ring.py`, `test_lib_tables.py` 63 pass. The fixture `tests/data/full.net` is the new netlist.

### ring7: 12 runs, fine rules, ring cells, ring6 tie weights, input `full8`

Evidence: `ring7.log` (session scratchpad, not committed); `git status` at the start in `ring7.gitstatus` (the four changed files of this update).

| Runs with 0 open items | Runs with 0 strict findings and 0 hard findings | Best run | Drops VBUS_IC / +5V / +3V3 (mV) | GND plane | +5V plane |
|---|---|---|---|---|---|
| 2 of 12 (runs 1, 3) | 0 | run 1 | 30.4 / 9.3 / 24.3 | 1 piece, 11.5 % removed | 1 piece, 20.1 % removed |

Best run, strict gate (`stitched-4l`): 16 findings, against 98 in ring6 run 4. `net_conflict` 0 (was 77), `footprint_symbol_mismatch` 2 (was 8: only C3 and C4 left, sizes not designed, HW-014 Draft), `courtyards_overlap` 12 and `items_not_allowed` 1 (all on U9, antenna, DEV-004, ADR-0003), and one strict FAIL: `silk_over_copper` 1 (silk outline of U9 over pad 4 of U3, a part the placer put in the module area).

Reading: the pin numbers removed every `net_conflict`. No run of this batch passes the strict gate (ring6 had 2 of 12). The changed netlist changes the placement input, so this batch is a new random draw; one batch each cannot show whether the change made routing worse. Not run: a second batch; fabricator DFM check; antenna and RF; thermal.

## Update 2026-11-08 (ring8 to ring10): tidiness score, placement grid, antenna keep-out

Aim (owner request): a board that looks hand-made. Basis: HW-010 (Approved, spike board); no new requirement. All batches: 12 runs, `SPIKE_PROFILE=fine`, `SPIKE_ALLOW_KNOWN_OPEN=0`, `full8` netlist, Freerouting 2.5.0, tree not clean (new files `src/pcb_quality.py`, `tests/test_pcb_quality.py`; see below). One change per batch. Freerouting is not deterministic: one batch is one batch.

New tools: `src/pcb_quality.py` (vias, track length, off-45 length, sharp corners, LED ring spread, share of passives in rows, share of parts on 90 degrees, distance of a passive to its partner) is the tie-break of `pcb_pick.py` after the gate score; `run_best.sh` takes `SEED_OFFSET`; `pcb_place.py` takes `PLACE_GRID` (mm, default 0 = off); `pcb_full.py` takes `PLACE_ANT_KEEPOUT=1` (no movable part in the vendor keep-out of `mech_outline.vendor_keepout_rect`, 15 mm beyond the module end).

| Batch | Change against ring7 | Runs with 0 open items | Runs with 0 strict FAIL and 0 open | Rows (mean of 12) | Best run |
|---|---|---|---|---|---|
| ring7 | none (reference) | 2 | 0 | 33 % | run 1 |
| ring8 (3 x 12) | new seeds, tidiness tie-break | 11 of 36 | 0 | not measured | 1 FAIL at best |
| ring9 g05 | `PLACE_GRID=0.5` | 2 | 0 | 79 % | run 8: 2 FAIL |
| ring9 g10 | `PLACE_GRID=1.0` | 5 | 0 | 95 % | run 4: 1 FAIL (courtyards 15 > 14); parts left of the module, in the antenna keep-out |
| ring10 | grid 1.0 and `PLACE_ANT_KEEPOUT=1` | 1 | **1 (run 3)** | 95 % | run 3 |

ring10 run 3, strict gate `stitched-4l`: 0 open items, 0 FAIL, 0 hard findings. Tolerated classes: courtyards_overlap 9 (max 14, U9 antenna, DEV-004), items_not_allowed 1 (DEV-004), footprint_symbol_mismatch 2 (C3, C4, HW-014 Draft). Power check: drops 42.6 / 18.7 / 27.8 mV (ring7 best: 30.4 / 9.3 / 24.3), all within the 50 mV analyst target (an assumption, not a requirement); GND plane 1 piece, 12.2 % removed; +5V plane 1 piece, 20.9 % removed. Tidiness: 149 vias, 1536 mm track, 21 sharp corners, 14.4 mm off-45 (about 123 segments, mostly 0.1 mm jogs at pads of the rotated ring LEDs), passive to partner 5.0 mm (ring7: 3.4).

Reading: the grid made the passives line up (33 % to 95 %); the keep-out removed the parts from the antenna zone. One gate-clean run of 12 is a single result, not a rate. The run is worse than ring7 run 1 in vias (149 against 124), track length and decoupling distance. Not attributed: the grid and the keep-out were not tested apart in the final batch. Test of the keep-out: `AntennaKeepout` in `tests/test_pcb_full.py` passes; it was not shown to fail without the rule.

Not run: a second ring10 batch, decoupling ties for C5/C6 at U8, grouped placement of the USB/power/CC blocks, fab DFM check, RF, thermal, bench. The 13 antenna findings stay per ADR-0003 and DEV-004 until spike 7.2.

## Update 2026-11-08 (ring11 to ring14): regulator ties, functional blocks, orientation, clean-up fix

Aim and basis as in the ring8 to ring10 section (owner request: a board that looks hand-made; HW-010 Approved; no new requirement). All batches: 12 runs, `SPIKE_PROFILE=fine`, `SPIKE_ALLOW_KNOWN_OPEN=0`, `full8` netlist, Freerouting 2.5.0, grid 1.0 and antenna keep-out unless stated. Evidence: `ring11.log` to `ring14.log` in the session scratchpad (not committed).

| Batch | Change against the previous one | Runs with 0 open items | Runs with 0 open and 0 strict FAIL | Best run |
|---|---|---|---|---|
| ring11 | pin ties C5-U8 and C6-U8 (`PIN_TIES`) | 1 | 0 | run 10: 2 FAIL (track_dangling 2, track_not_centered_on_via 3) |
| ring12 | `PLACE_BLOCKS=3` (7 functional blocks, `pcb_rules.BLOCKS`) and `PLACE_ORIENT=1.5` (like parts on one axis, switch circuits as twins) | 4 | 0 | run 8: 1 FAIL (track_not_centered_on_via 2) |
| ring13 | ring12 plus `PLACE_STRICT=1` (ICs match in rotation and side) and `PLACE_ROWS=3` (test points in a row) | 0 | 0 | run 8: 1 open, 2 FAIL |
| ring14 | ring12 settings, strict and rows off, `SEED_OFFSET=200`, clean-up fix in the pipeline | 3 (runs 4, 8, 9) | **2 (runs 4, 9)** | run 9 |

Clean-up fix (`pcb_fix.snap_to_vias`, called by `last_pass`): the function existed but nothing called it. Track ends 0.009 and 0.05 mm beside a via made the gate fail with `track_not_centered_on_via`. The call moves such ends onto the via centre and removes a track that ends up with no length. It acts only at the sites the gate reported: a first version that snapped everywhere broke a clearance (0.093 against 0.100 mm). Regression tests: `tests/test_pcb_fix.py::SnapToVias`. Applied by hand to a copy of ring12 run 8 (gate clean), then run inside the pipeline in ring13 and ring14.

ring14 run 9 (best), strict gate `stitched-4l`: 0 open items, 0 FAIL, 0 hard findings. Tolerated classes: courtyards_overlap 8 (max 14, U9 antenna, DEV-004), items_not_allowed 1 (DEV-004), footprint_symbol_mismatch 2 (C3, C4, HW-014 Draft). Power check (`pcb_power_check.py`; the 50 mV target is an analyst assumption, not a requirement): +3V3 22.7 mV, +5V 18.0 mV, VBUS_IC 13.5 mV. Planes: GND 1 piece, 11.7 % removed; +5V 1 piece, 21.5 % removed. Layout numbers: 131 vias, 1370 mm track, 14 sharp corners, 95 % of passives in rows, 87.5 % of like parts on one axis, passive to partner 3.8 mm, block member to anchor 7.5 mm. ring14 run 4 also has 0 FAIL but one path drops 58.0 mV (over the 50 mV assumption); it is not chosen.

Visual review of run 9 (3D render, `kicad-cli pcb render`; the render shows the copper only faintly): the LED ring is even and the antenna slot is clear. Flaws a reviewer can name: the six test points are spread over the lower half instead of one row; the ICs point in mixed directions; the 1206 bulk capacitors stand alone; the blocks are looser than in ring12 run 8.

Reading: ring12 gave the most open-item-free runs, but none passed the gate until the clean-up fix. With the fix, ring14 (same settings, new seeds) gave 2 gate-clean runs of 12. That is a single batch, so the pass rate is not known beyond "above 0 of 12". The strict-IC and test-point-row rules (ring13) did not help: 0 of 12 route fully; they are left off by default. The ties of ring11 changed the partner distance by about 0.2 mm, within the noise of one batch.

Not run: a second ring14 batch, fab DFM check (a partial check against fabricator minimums is in the next section), RF, thermal, bench. No statement "DFx approved" or "fully functional" is made. The 13 antenna findings stay per ADR-0003 and DEV-004 until spike 7.2. Schematic simplification (one resistor for the ILIM pair, fewer supervisor timing capacitors) is a separate revision: it needs a requirement and an ADR (owner decision 2026-11-08).

### Fabricator-minimum check of ring14 run 9 (`src/pcb_fabcheck.py`, tests `tests/test_pcb_fabcheck.py`, 8 pass)

What it is: a read-only script that compares the board with the JLCPCB multilayer minimums recorded in ADR-0020 and `pcb_rules.py` (capability page read 2026-11-08, not read again). It is not a fabricator review: no fabricator saw the files and no other fabricator was checked.

| Check | Limit (JLCPCB) | Board (run 9) | Result |
|---|---|---|---|
| Track width | 0.09 mm | 0.10 mm minimum | pass |
| Via diameter | 0.25 mm | 0.50 mm | pass |
| Via drill | 0.15 mm | 0.20 mm | pass |
| Annular ring | 0.15 mm absolute minimum | 0.15 mm (all 131 vias) | pass at the minimum |
| Via hole to via hole | 0.2 mm | no pair below | pass |
| Pad hole to pad hole (slots as capsules) | 0.45 mm | no pair below | pass |
| SMD pad to pad (KiCad DRC rule, 0.15 mm) | 0.15 mm | 0 violations | pass |

Notes: (1) All 131 vias are below the recommended ring of 0.20 mm; they sit exactly at the absolute minimum, with no margin. (2) The track minimum has 11 % margin (0.10 against 0.09 mm). (3) Track and space and the copper to edge distance are not recomputed: the strict gate holds 0.1 mm clearance and 0.3 mm edge, both above the fabricator minimums. (4) The first version of the hole check treated the 2.1 mm slots of the USB-C shell as circles and reported four false failures; slots are now modelled as capsules (test first). (5) The pad-to-pad rule was shown to detect: at a limit of 0.5 mm it reports 155 pairs.

Not checked: Gerber and drill export and a viewer check, silkscreen against pads on the fabricator side, solder-mask bridges and slivers, paste, panelisation, assembly (DFA: courtyards, orientation, polarity, fiducials), impedance, stack-up. The fine profile that every gate-clean board used is an experiment: ADR-0020 is **Proposed**, the owner has not decided, and the risk register entry for yield at 0.1 mm lines is not written. This check therefore does not support the statement "DFx approved" or "fabrication ready".

## Update 2026-11-08 (ring15): test points pulled softly into a row (HW-010)

Basis as in ring14: 12 runs, `SPIKE_PROFILE=fine`, `SPIKE_ALLOW_KNOWN_OPEN=0`, `full8` netlist, Freerouting 2.5.0, `PLACE_GRID=1.0`, `PLACE_ANT_KEEPOUT=1`, `PLACE_BLOCKS=3`, `PLACE_ORIENT=1.5`, `SEED_OFFSET=300`. One change against ring14: `PLACE_ROWS=0.5` (ring13 used 3 together with strict ICs and gave no fully routed run). Strict ICs stay off.

| Batch | Change | Runs with 0 open and 0 strict FAIL | Best run |
|---|---|---|---|
| ring15 | `PLACE_ROWS=0.5`, new seeds | **3 (runs 1, 2, 5)** | run 1 |

Picker table (unconnected / strict FAIL; tidy = sharp corners, off-45 mm, vias, track mm): run 1: 0 / 0, (12, 18.5, 133, 1330.1); run 2: 0 / 0, (19, 11.0, 126, 1364.5); run 5: 0 / 0, (16, 11.3, 135, 1411.2). The other nine runs have 1 to 8 unconnected nets or 1 to 3 strict FAIL.

Power check of the three gate-clean boards (`pcb_power_check.py`; drops at 1.5 A VBUS_IC, 1.0 A +5V, 0.5 A +3V3; target 50 mV is an analyst assumption):

| Board | VBUS_IC | +5V | +3V3 |
|---|---|---|---|
| ring15 run 1 (picker's best) | 50.4 mV, over target | **no path found (infinite)**; the +5V plane is in 2 pieces | 34.3 mV |
| ring15 run 2 | 42.5 mV | 19.0 mV | 6.3 mV |
| ring15 run 5 | 41.9 mV | 17.2 mV | 24.2 mV |
| ring14 run 9 | 13.5 mV | 18.0 mV | 22.7 mV |

The picker ranks by gate and tidiness only, so it chose run 1. The power check shows run 1 is not usable as the best board (the checker finds no copper path on +5V although the DRC reports 0 unconnected; the cause was not investigated). Run 5 (next candidate) was checked in full: strict gate pass (courtyards_overlap 10), fab-minimum check PASS, power check pass; sharp corners 16, vias 135, track 1411 mm, passives in rows 0.951, like parts on one axis 0.929, block member 8.18 mm. In its bottom render the six test points are not in a row, so `PLACE_ROWS=0.5` did not do its job.

Against ring14 run 9 (13.5 mV on VBUS_IC, 14 sharp corners, 131 vias, 1370 mm, rows 0.951, like parts 0.875, block member 7.47 mm), run 5 is better only on like parts on one axis. **Ring15 produced no better board; ring14 run 9 stays the stored result.** Tooling change made afterwards: `pcb_pick.py` now ranks power-check failures (`power_fails_from`, 2 tests) after the gate and before tidiness. Re-picking the 12 ring15 runs gives run 5 (run 1 has 2 power FAIL); the pick is still below ring14 run 9 on the numbers above.

Limits: one batch, so three of 12 is a rough number, not a rate. The effect of `PLACE_ROWS=0.5` cannot be separated from seed luck. ADR-0020 is Proposed and the fab numbers are JLCPCB only. Not run: full fab review (Gerber, silkscreen, solder mask, assembly), RF, thermal, bench; no statement "DFx approved" or "fully functional" is made.

The 15 errors of `tests/test_gate_logic.py` are by design: the tests read a netlist named by the environment variable `GATE_NET` (see its docstring) and are not run without it. They are not a defect of the placer or router.

## Stored result (2026-11-08)
The board is stored in `hw/kicad/spike-gate/board/` (ring14 run 9; provenance and checks in its README). The README images (`docs/verification/reports/images/spike-*.png`) are re-rendered from it with `render_readme_images.sh`. The strict gate was re-run on the stored copy: 11 tolerated findings, none else.
