spoorcc/busy-light/docs/verification/reports/images/spike-hw-kicad-render.png

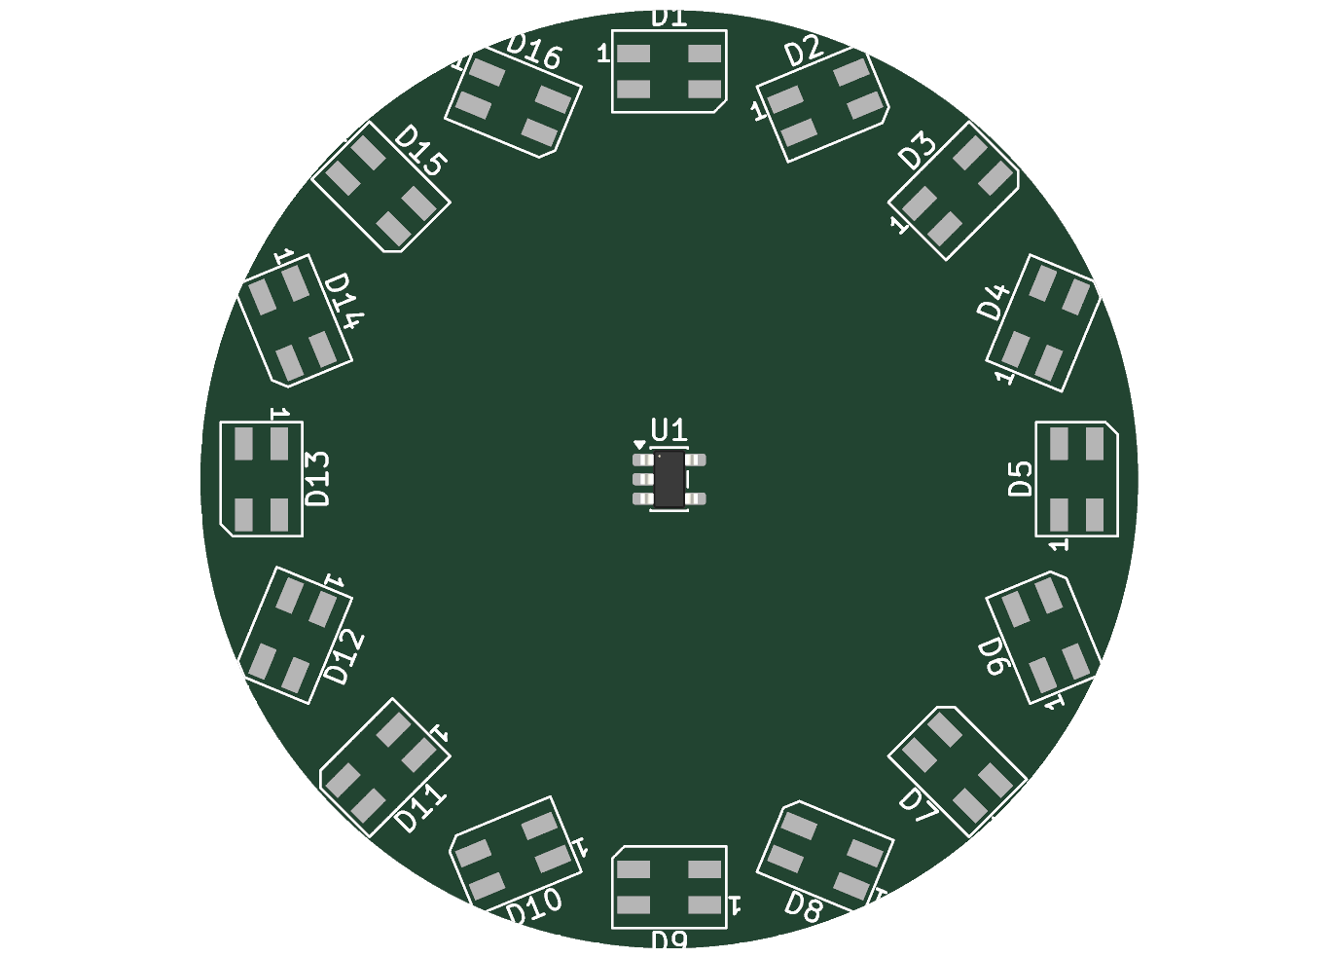
docs/verification/reports/images/spike-hw-kicad-render.png
