spoorcc/busy-light/docs/verification/reports/images/spike-mech-back-layout.png

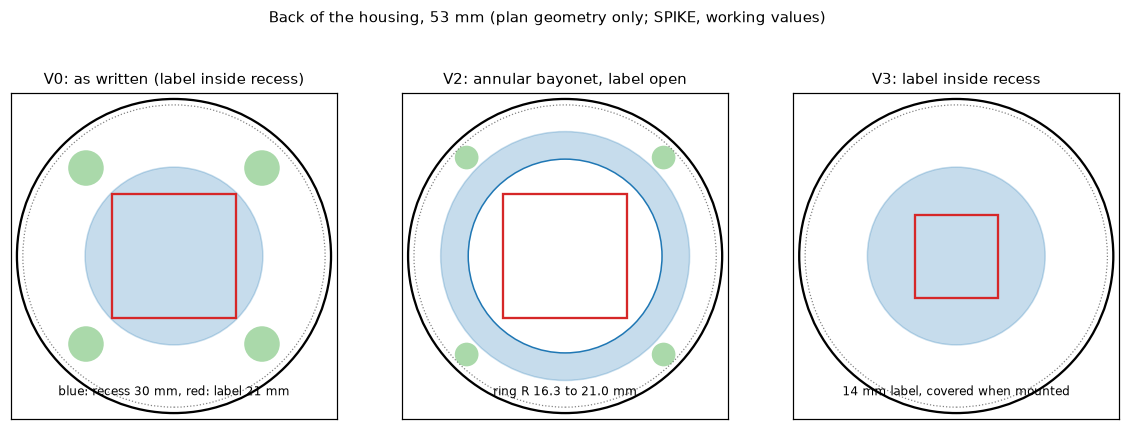
docs/verification/reports/images/spike-mech-back-layout.png
