spoorcc/busy-light/docs/verification/reports/images/spike-mech-back-options.png

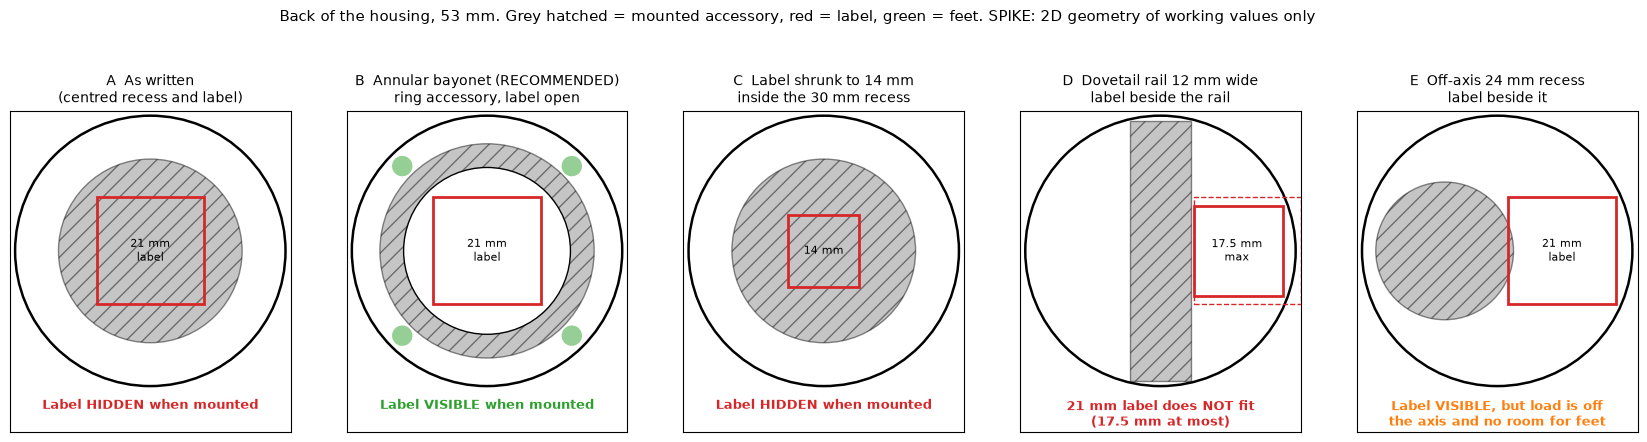
docs/verification/reports/images/spike-mech-back-options.png
