spoorcc/busy-light/docs/verification/reports/images/spike-mech-housing-concept-b.png

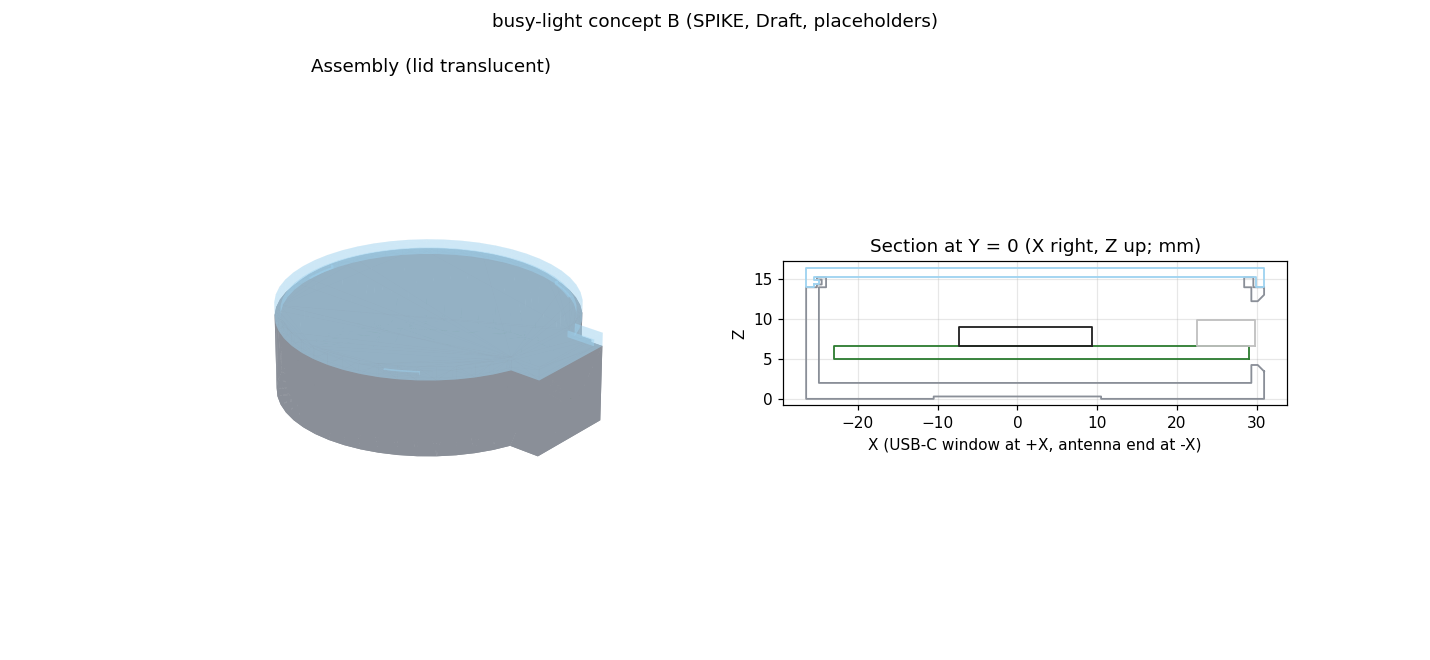
docs/verification/reports/images/spike-mech-housing-concept-b.png
