spoorcc/busy-light/docs/user/installation.md

# Installation and Setup

- **Status:** Draft -- placeholder, content to be written after requirements are approved
- **Applies to:** product revision TBD (hardware / mechanical / firmware)
- **Source requirements:** TBD

> Scope: Mounting, power, first start, network or app pairing (if any), firmware version check.
