spoorcc/busy-light/docs/user/user-guide.md

# User Guide

- **Status:** Draft -- placeholder, content to be written after requirements are approved
- **Applies to:** product revision TBD (hardware / mechanical / firmware)
- **Source requirements:** TBD

> Scope: How to use every function. Include the indicator state table (state, colour, pattern, meaning, user action).
