spoorcc/busy-light/docs/verification/test-cases-sw.md

# Software test cases

- **Status:** Draft stubs; the procedures of TC-105, TC-106, TC-107, TC-109 and TC-110 are approved as the working procedures by the owner (2026-11-07, after RV-011); bracketed values stay open; nothing has been run

### TC-101 Input limits of the extractor and mapper

- **Verifies:** SW-001
- **Level:** Unit / integration
- **Procedure:** TBD
- **Expected result / pass criteria:** see acceptance criteria of SW-001
- **Automated:** TBD
- **Evidence:** TBD

### TC-102 Limit on concurrent network sessions

- **Verifies:** SW-002
- **Level:** Unit / integration
- **Procedure:** TBD
- **Expected result / pass criteria:** see acceptance criteria of SW-002
- **Automated:** TBD
- **Evidence:** TBD

### TC-103 Fuzz tests of external inputs

- **Verifies:** SW-003
- **Level:** Unit / integration
- **Procedure:** TBD
- **Expected result / pass criteria:** see acceptance criteria of SW-003
- **Automated:** TBD
- **Evidence:** TBD

### TC-104 Image confirmation and forced restart

- **Verifies:** SW-004
- **Level:** Unit / integration
- **Procedure:** TBD
- **Expected result / pass criteria:** see acceptance criteria of SW-004
- **Automated:** TBD
- **Evidence:** TBD

### TC-105 Raise the current limit only after a stable reading

- **Verifies:** SW-005
- **Level:** Unit / integration, then bench with TC-203
- **Procedure:** see the procedure below
- **Procedure (2026-11-07, approved by the owner as the working procedure after RV-011; values in brackets are the open values of the requirement; not run):** Unit level: the injected-clock and fake-GPIO cases (a) to (g) of the proposed outline below, written as ztest cases in `sw/app/tests/` with the module under test linked on the host (native_sim). Each case lists the read sequence as a table and the expected select output at each tick. Add: (h) the value table of SW-005 criterion 3 with one CC input: CC_OK_1A5 low gives step 1, CC_OK_1A5 high gives step 2 until TC-213 allows step 3 (the middle step is the Kconfig constant `BL_ADVERT_STEP`, Proposed amendment of SW-005); (i) a changed read period of [50] ms keeps the count at [6]; (j) HOLD_OK_RB low for one read inside the count restarts it. Bench: as the outline below, with a scope on HOLD_OK_RB and the select GPIO. Pass: all unit cases green in CI; at the bench the step is selected within [700] ms of the HOLD_OK_RB rise. Not run; no firmware or test harness exists.
- **Expected result / pass criteria:** see acceptance criteria of SW-005
- **Automated:** TBD
- **Evidence:** TBD
- **Proposed procedure outline (Draft, 2026-11-05, owner decision; proposal P6 of `docs/verification/reports/analysis-sw005-holdoff-timing.md`; it belongs to the Proposed amendment of SW-005 and is not Approved; "Procedure: TBD" above stays until the owner approves the amendment):** Unit level with an injected clock and a fake GPIO: (a) 6 equal reads at 100 ms give the step at read 6; (b) a change at read 5 restarts the count; (c) HOLD_OK_RB low during the count restarts it; (d) a falling edge of HOLD_OK_RB sets the select outputs low and the next raise needs a new count; (e) a default reading never sets a select output; (f) the step arrives within 700 ms of the rising edge of HOLD_OK_RB with 5 ms of clock jitter; (g) [changed by the Proposed single-input amendment of SW-005] each unknown state gives step 1 and a logged count: EN2 high with select 2 low; EN3 high with select 3 low; EN2 and EN3 both high; HOLD_OK_RB low. Bench level, with TC-203: a scope on HOLD_OK_RB and on the select GPIO, a 1.5 A source, the limit step read from the input current; the time from VBUS applied to the raised step is recorded against the [2] s of SYS-020 (TC-020). Not run: no firmware exists.

### TC-106 Reduce load before lowering the current step

- **Verifies:** SW-006
- **Level:** Unit / integration, then bench with TC-203
- **Procedure:** see the procedure below
- **Procedure (2026-11-07, approved by the owner as the working procedure after RV-011; not run):** Unit level on native_sim with an injected clock and a fake LED layer that records the requested budget: (a) the stable advertised value falls (SW-005 read period [100] ms): the LED layer is asked for the lower budget within [50] ms measured from the read that shows the fall, and the select output goes low after the budget is reached, not before; (b) the select output is never lowered while the old budget is still requested; (c) a falling edge of HOLD_OK_RB is covered by TC-109 and not repeated here; (d) the time base is the injected clock, and the case fails if the read period constant is changed without the [50] ms being recomputed. Bench, with TC-203: scope on the CC input read and the LED current, a source that changes its advertisement from 1.5 A to default. Pass: unit cases green; at the bench the LED current is lowered within [50] ms of the read that shows the fall. Not run; no firmware exists.
- **Expected result / pass criteria:** see acceptance criteria of SW-006
- **Automated:** TBD
- **Evidence:** TBD

### TC-107 Back-off after a brown-out reset

- **Verifies:** SW-007
- **Level:** Unit / integration, then bench with TC-203
- **Procedure:** see the procedure below
- **Procedure (2026-11-07, approved by the owner as the working procedure after RV-011; not run):** Unit level in `sw/app/tests/gate/` on native_sim with a fake retained store, a fake reset-cause source, an injected clock and a fake HOLD_OK_RB. Cases: (a) a forced brown-out with both HOLD_OK_RB high and the flag clear counts once and holds the lowest step for [60] s on the injected clock; the step is not raised at [60] s minus one tick and is raised at [60] s (the window edge is inclusive); (b) [3] counted resets within [10] min keep the lowest step after a further reset until a power-up, and the LED state shows it; the third reset at [10] min plus one tick does not trigger it; (c) a forced reset with HOLD_OK_RB low at the first read does not change the counter; (d) a forced reset with the retained flag set does not change the counter, and the flag is read before the readback configuration of SW-009 and cleared only after use; (e) the counter and the reset cause survive the reset hook; (g) a stale flag: the gate closed without a reset, the flag was set, HOLD_OK_RB is high again and the hold-off has ended; the flag is cleared at that point, and a later real brown-out is counted (proposed rule, needs the owner's decision); (i) a watchdog reset counts like a brown-out: [3] watchdog resets in [10] min keep the lowest step until the next power-up (Proposed amendment of SW-007); (h) the clock for the [60] s and the [10] min window is a stored elapsed time or an RTC stamp, not an absolute tick count that restarts at 0; the case resets the injected clock to 0 and the back-off still ends at the right time; (f) with the retention switched off by the test (fallback option (b) of SW-007) only HOLD_OK_RB at the first read decides, and a reset longer than the remaining hold-off is counted (documented cost). Bench, with TC-203: force a brown-out by a VBUS dip with a hold-off active and one with it finished; read the counter over the debug port; check that the RTC memory keeps the flag over this reset cause (the open check of SW-007). Pass: all unit cases green in CI. Bench: if the flag survives the reset, the result passes; if it does not, SW-007 option (b) is used, case (f) is rerun as the governing case and the cost is recorded. Not run; no firmware exists.
- **Expected result / pass criteria:** see acceptance criteria of SW-007
- **Automated:** TBD
- **Evidence:** TBD

### TC-108 Tolerance of Power Delivery traffic and source changes

- **Verifies:** SW-008
- **Level:** Unit / integration, then bench with TC-203
- **Procedure:** TBD
- **Expected result / pass criteria:** see acceptance criteria of SW-008
- **Automated:** TBD
- **Evidence:** TBD

### TC-109 Follow the hardware gate state and shed load

- **Verifies:** SW-009
- **Level:** Unit / integration, then bench with TC-210
- **Procedure:** see the procedure below
- **Procedure (2026-11-07, approved by the owner as the working procedure after RV-011; values in brackets are the open values of the requirement; not run):** Unit level: cases (a) to (g) of the proposed outline below, with a fake GPIO that can raise an edge and an injected clock, in `sw/app/tests/`. The time [X] is a parameter of the test; the test fails if [X] is left unset. Inspection: the build-configuration items of the outline below are checked by a script that reads `.config` and the devicetree output and fails on any difference. Bench, with TC-210: dips of 10 us, 10 ms and 100 ms on VBUS; record the time from the HOLD_OK_RB fall to the lower LED current, whether the processor resets, and the 5 V and 3V3 fall times (this gives the hold-up time that sets [X]); read the pad configuration registers of GPIO20 and GPIO21 over the debug port at the first read of the readbacks. Pass (unit): all cases green, and the test fails while [X] is unset. Pass (bench, after [X] is set by the owner from the record of this test): the measured shed time is at most [X]. SW-009 gives [X] in the statement and [50] ms in the acceptance criterion; until the owner resolves which governs, [X] is the parameter and [50] ms is its proposed value. Not run; no firmware exists.
- **Expected result / pass criteria:** see acceptance criteria of SW-009
- **Automated:** TBD
- **Evidence:** TBD
- **Proposed procedure outline (Draft, 2026-11-05, owner decision; proposal P6 of `docs/verification/reports/analysis-sw005-holdoff-timing.md`; it belongs to the Proposed amendment of SW-009 and is not Approved; "Procedure: TBD" above stays until the owner approves the amendment):** Unit level: (a) edge interrupt to load shed within [X] ms of the falling edge of HOLD_OK_RB, EN2 or EN3, with [X] open until a rail hold-up is measured; (b) a falling edge shorter than the poll period is latched and not missed; (c) HOLD_OK_RB low with CC_OK inputs high gives the lowest step; (d) [changed by the Proposed amendment of SW-009, ADR-0018 option E] with the gate open, a fall of GATE_OK_RB caused by a limiter fault sheds the load within [X] ms and lowers the selects; (e) the readback code calls gpio_pin_configure with GPIO_INPUT only, and a readback before configuration is reported as invalid; (f) no test or run drives both select outputs; (g) a forced reset with HOLD_OK_RB low, and one with the retained flag set, do not increase the brown-out counter (SW-007). Inspection: the build configuration lists usb_serial as zephyr,console, uart0 disabled, CONFIG_SERIAL_ESP32_USB=y, CONFIG_UART_ESP32 not set, CONFIG_ESP_CONSOLE_USB_SERIAL_JTAG=y (zephyr.dts and .config stored in docs/verification/). Bench, with TC-210: a forced VBUS dip of 10 us, 10 ms and 100 ms; record the time from the HOLD_OK_RB fall to the LED current and whether the MCU resets (recorded, not a pass criterion until [X] is set); read IO_MUX_GPIO20_REG and IO_MUX_GPIO21_REG after start-up (FUN_WPU and FUN_WPD 0, MCU_SEL 1); the log is visible on USB-C alone and no UART activity is seen on GPIO21 after the application starts; unplug the cable with 3V3 up and show that the firmware uses the lowest step. Not run: no firmware exists.

### TC-110 Restart of a hung firmware returns the current limit to the lowest step

- **Verifies:** SW-010
- **Level:** Unit / integration, then bench with TC-210
- **Procedure:** see the procedure below
- **Procedure (2026-11-07, approved by the owner as the working procedure after RV-011; values in brackets are the open values of the requirement; not run):** Unit level: a test build with a hook that stops the select loop but leaves a timer and an interrupt running; the watchdog fake must show no service from the timer or the interrupt, and a timeout within [10] s. Bench, with TC-210: with a select output high and a 1.5 A source, trigger the hook; record the time to reset with a scope on the 3V3 rail and the select GPIO, the select GPIO state through the reset (pull-downs at reset, ADR-0010), and the input current after the restart (at most [623] mA until SW-005 raises a step again). Pass: reset within [10] s, select outputs low after the reset, current at most [623] mA. Repeated hang: three forced hangs in [10] min leave the step lowest until the next power-up (Proposed amendment of SW-010). Repeat 10 times; pass is 10 of 10, with the current meter accuracy stated and added to the [623] mA limit check. The watchdog fake records the calling context (loop, timer, interrupt). Not run; no firmware exists.
- **Expected result / pass criteria:** see acceptance criteria of SW-010
- **Automated:** TBD
- **Evidence:** TBD

### TC-111 Security configuration policy

- **Verifies:** SW-011
- **Level:** Inspection
- **Preconditions / setup:** release build of the firmware with its `build/zephyr/.config`.
- **Procedure:**
  1. Run `python3 -I scripts/check_kconfig_policy.py --dotconfig build/zephyr/.config`.
  2. Record the SWC-001 and SWC-002 findings.
- **Expected result / pass criteria:** see acceptance criteria of SW-011
- **Automated:** yes (`scripts/ci_sw_static.sh`, CI job software)
- **Evidence:** native_sim gate build on 2026-11-10: 0 forbidden options; 5 hardening options not set (HW stack protection, canaries, fortify, watchdog, MCUboot), report only

### TC-112 Static analysis of the project C code

- **Verifies:** SW-012
- **Level:** Inspection
- **Preconditions / setup:** west workspace; native_sim build with `compile_commands.json`; clang-tidy and cppcheck installed.
- **Procedure:**
  1. Run `scripts/ci_sw_static.sh build` with `SW_CI_OUT` set.
  2. Keep `clang-tidy.txt` and the cppcheck XML files.
  3. Record the files marked NOT RUN.
- **Expected result / pass criteria:** see acceptance criteria of SW-012
- **Automated:** yes (`scripts/ci_sw_static.sh`, CI job software)
- **Evidence:** local run on 2026-11-10 (clang-tidy 18.1.3, cppcheck 2.13.0): clang-tidy no finding in main.c and gate.c; cppcheck MISRA on gate.c 0 Mandatory/Required, 14 Advisory (15.5 x11, 17.8 x2, 8.7 x1, categories from the table in `check_sw_static.py`, verify); main.c NOT RUN for cppcheck

### TC-113 Radio settings stay within the approved values

- **Verifies:** SW-013
- **Level:** Integration
- **Preconditions / setup:** target hardware with the release firmware; the module's RED test report (power table, channels).
- **Procedure:**
  1. Read the active country code and transmit power limit from the driver after start.
  2. Repeat after a factory reset and after a settings import.
  3. Try to change them through each interface.
- **Expected result / pass criteria:** see acceptance criteria of SW-013
- **Automated:** TBD
- **Evidence:** none yet
