spoorcc/busy-light/docs/verification/test-plan.md

# Verification Plan

- **Status:** Draft

Strategy per level (unit/integration/system/bench), tooling (Zephyr `twister`, native_sim,
HIL), environments, evidence retention, and entry/exit criteria. Test cases (`TC-nnn`) follow
`docs/templates/test-case.md`.
