spoorcc/busy-light/docs/templates/test-case.md

### TC-000 Short title

- **Verifies:** SW-000
- **Level:** Unit | Integration | System | Bench | HIL | Inspection | Analysis
- **Preconditions / setup:** Equipment, calibration status, firmware/hardware revision under test.
- **Procedure:**
  1.
- **Expected result / pass criteria:**
- **Automated:** yes (`path/to/test`) | no
- **Evidence:** Where results are stored (CI artefact, `docs/verification/reports/TC-000-<date>.md`)
