spoorcc/busy-light/CHANGELOG.md

# Changelog

All notable changes to this project are documented in this file.

The format is based on [Keep a Changelog](https://keepachangelog.com/en/1.1.0/),
and this project adheres to [Semantic Versioning](https://semver.org/spec/v2.0.0.html).

Scope: the changelog covers the product as a whole (software, hardware, mechanical and user-visible documentation).
Hardware and mechanical revisions are named in the entries (for example "hardware rev A").

## [Unreleased]

### Added
- Regulatory documents brought to technical-file form (all Draft, legal references from secondary sources and marked *(verify)*): product description (`technical-file/01-general/`); applicability assessment RAA-001 v0.3 restructured with a scope test per act, the manufacturer role, acts found not applicable with reasons, conformity strategy, dates and open decisions D1 to D8; product risk assessment (`technical-file/03-risk-and-safety/risk-assessment.md`: method, scales, proposed criteria, 32 scored hazards for safety, EMC, radio, cybersecurity summary and substances; 9 High, none shown as reduced); standards list v0.2 with the EN IEC 62368-1 clauses that shape the design (power source classes, fire enclosure, touch temperature, mounting, optical radiation), EMF route, basic EMC standards, guidance documents and standards not applied; conformity test plan with the port classification; compliance matrix v0.3 with one table per act and article.
- Draft requirements from the safety and radio assessment: SYS-050 (fire safety and energy source classification), SYS-051 (accessible surface temperature), SYS-052 (RF exposure), SYS-053 (flash rate of light patterns), HW-021 (board material flammability), MECH-010 (housing material flammability for sold units), MECH-011 (mounting accessory strength), SW-013 (radio settings within the module's approved values), with TC-050 to TC-053, TC-113, TC-221, TC-310, TC-311; risks RISK-047 to RISK-054 (fire, burn, ESD, over-voltage from a faulty source, substances, flashing light, small parts, radio settings).
- Automated rule HWC-010 (report): supply track width against the IPC-2221 formula for the net's design current; on the spike board many segments of VBUS_IC and +5V are narrower than the 0.57 mm it asks for 1.6 A on an outer layer (copper areas are not counted).

### Fixed
- The secret scan flagged its own test file once the file was tracked (a quoted option name in `scripts/test_check_sw_policies.py`); the test string is now split.
- Automated compliance checks in CI (Proposed ADR-0022, catalogue `docs/regulatory/automated-checks.md`): hardware rules HWC-001 to HWC-009 on the KiCad files without a KiCad install (`scripts/check_hw_compliance.py`, `scripts/kicad_sexp.py`; ESD clamp on every external interface net, test points, board identification, MPN, RoHS/REACH register, lifecycle, debug-access inventory); firmware rules SWC-001 to SWC-009 (Kconfig security policy `sw/kconfig-policy.yaml`, secret scan, SHA-pinned actions and verified downloads, clang-tidy CERT C and cppcheck MISRA addon in `scripts/ci_sw_static.sh`, suppression hygiene, SPDX SBOM by `west spdx`); DOC-001 compliance-matrix consistency check. All with tests. First run on the spike board: CC1 and CC2 without an ESD clamp, VBUS_IC without a test point, no board name or revision text, J1/TVS1/TVS2 without MPN in the stored schematic (sourcing.py not applied), TUSB321 marked NRND; waived under DEV-007 (Proposed).
- Materials register `hw/compliance/materials.yaml` (33 part numbers, RoHS/REACH status unknown for all, no declaration on file) and the approach `technical-file/07-supplier-declarations/rohs-reach-weee.md` (HW-019).
- Regulatory documents: candidate standards list per RED article and for the CRA (`technical-file/04-standards-and-testing/standards-list.md`), CRA Annex I mapping with gaps, labelling and user-information item list; applicability assessment update of 2026-11-10 (RED cyber delegated act repealed from 11 December 2027 by (EU) 2026/339, CRA reporting from 11 September 2026, default CRA class); compliance-matrix rows for every requirement with a regulatory reference. All legal references from secondary sources and marked *(verify)*.
- Draft requirements SYS-048 (regulatory marking and user information), SYS-049 (EMC), HW-018 (ESD clamp on every external interface net, includes the CC lines), HW-019 (material declarations and lifecycle), HW-020 (board name and revision), SW-011 (firmware security configuration), SW-012 (static analysis), with TC-048, TC-049, TC-111, TC-112, TC-218 to TC-220; deviation DEV-007 (Proposed).
- Spike board: real capacitor parts for C2 (4.7 uF 16 V), C3 (10 uF 25 V), C5 (2.2 uF 16 V), C6 (10 uF 10 V) with MPN and LCSC numbers, and a DC-bias bound script `hw/sim/scripts/dc_bias_caps.py` (Samsung DC-bias curves read for each part; HW-014, HW-015, HW-010). BOM references without MPN: 2 (J1, TVS2; closed by a later entry).
- DC-bias analysis extended to the 100 nF X7R capacitors (CL10B104KB8NNN, retention 0.998 at 5.6 V) and to the room for the spares C4 and C32 (65 uF nominal together); protection-part capacitance bounded at 1 nF against 3.67 uF of room on VBUS_IC (snippets); a real spare value still open (HW-014, HW-015).
- Spike board TVS1 chosen by the owner under surge option S1 (measure the real hot-plug surge first, RV-013 finding 9): Nexperia PESD5V0S1BA,115 (LCSC C19224) in the sourcing table; a plain 5 V TVS clamps at 10 to 14 V, so the 6 V and 7 V parts rely on the supply-pin resistors and zeners and on the TC-210 step 4 measurement (HW-010).
- Part evidence for TVS1 (`hw/evidence/parts/pesd5v0s1ba.yaml`, 11 claims) and the Nexperia BZX84-C5V1 (11 claims added to `bzx84c5v1.yaml`) from the downloaded datasheets; a source-missing claim for the USBLC6-2P6 VBUS pin capacitance; all claims unverified (HW-012, HW-010).
- Spike board J1 and TVS2 have an MPN now: J1 GCT USB4085-GF-A (LCSC C7095263; no edge-mount variant exists, the project footprint is the USB4085 pad pattern at the board edge), TVS2 Nexperia PESD3V3L1BA,115 (LCSC C51450, owner choice 2026-11-09); evidence files `usb-c-receptacle.yaml` and `pesd3v3l1ba.yaml` (unverified), the placeholder `tvs-sod323.yaml` is removed. BOM references without MPN: 0 (HW-008, HW-010, HW-012). The USBLC6-2P6 VBUS-pin capacitance is not published; the sensitivity shows 3.67 uF would be needed to matter (HW-015).
- Draft ADR-0021 (surge option S1, measure first), draft requirement HW-017 (damping footprint in the VBUS path of the prototype), TC-217 and RISK-046; nothing Approved or Accepted, no board change yet.
- Spike board capacitor values (owner decisions 2026-11-08, finding 4 of `spike-fab-review.md`): C2 4.7u, C3 10u 0805, C5 2.2u, C6 10u, C4 and new C32 are 1206 do-not-populate spares on +5V (HW-014, HW-015, HW-016, proposal report `proposal-tbd-capacitor-values.md`); `pcb_spare_caps.py` with tests applies them to the stored board (C32 on the bottom side, routed by `pcb_fix.py`); no tbd value is left and the C3/C4 footprint-mismatch waiver is gone. Fix: the sourcing fields of the previous change were missing on the board footprints, which gave 100 `footprint_symbol_field_mismatch` warnings in the strict DRC; they are now written to the footprints.
- Spike board BOM sourcing fields (finding 5 of `spike-fab-review.md`): hidden `MPN`, `Manufacturer` and `LCSC` fields on every schematic part from `hw/kicad/spike-gate/src/sourcing.py` (only parts with a recorded source: 28 part groups, web lookups of 2026-11-08, to be re-checked at order time; 7 of the BOM references have none yet: C2, C3, C5, C6, J1, TVS1, TVS2) and a `pcb_fabreview.py` finding that lists parts without an MPN; stored schematic regenerated (ERC 0, no other change). Numbers for the other parts need datasheet or shop evidence (HW-008, HW-010).
- Spike board tooling: tidiness score `pcb_quality.py` (vias, off-45 length, sharp corners, rows, ring spread, passive distance) as tie-break of the run picker, placement grid `PLACE_GRID`, antenna keep-out `PLACE_ANT_KEEPOUT`, `SEED_OFFSET` for `run_best.sh`; batches ring8 to ring10 recorded (HW-010). One of 12 ring10 runs passes the strict gate. Batches ring11 to ring14: regulator pin ties, functional blocks and orientation costs in the placer (`PLACE_BLOCKS`, `PLACE_ORIENT`, off by default), and a clean-up fix (`snap_to_vias` is now called); two of 12 ring14 runs pass the strict gate. Batch ring15 (`PLACE_ROWS=0.5` soft test-point row): three of 12 runs pass the strict gate, none better than ring14 run 9; the run picker now ranks power-check failures before tidiness. Assembly check `pcb_fabreview.py` and the report `spike-fab-review.md` (4 findings). Fixes: seven parts renamed to numbered references (C27 to C31, R20, R21), silkscreen designators for 73 of 100 parts and four fiducials by script (`pcb_finish.py`, `pcb_rename.py`); still not ready to order (tbd values, no part numbers). CI: `scripts/ci_hw.sh` checks the stored spike board through the strict wrapper (waiver list, DEV-004) instead of the raw kicad-cli exit code; the board project now switches on the four default-ignored ERC checks; ruff line-length and format fixes in `bulk_cap_bounds.py`. The routed board (ring14 run 9) is stored in `hw/kicad/spike-gate/board/` and the README images are re-rendered from it. Fabricator-minimum check `pcb_fabcheck.py` (JLCPCB numbers of ADR-0020; run 9 passes, ring at the absolute minimum; partial, ADR-0020 still Proposed).
- Skill `pcb-route-and-gate` (order of work, gate and lessons for the spike board), reviewed by goldfish (RV-012).
- Draft requirement HW-014 (bulk capacitance of the +5V rail, [10] to [100] uF effective) with TC-214, the analysis `analysis-5v-bulk-capacitance.md` and the script `hw/sim/scripts/bulk_cap_bounds.py` with tests (HW-004, HW-010).
- Draft requirement HW-015 (capacitance on VBUS before the switch, 1.0 to 10.0 uF effective, USB 2.0 Device Capacitance ECN) with TC-215.
- Goldfish review RV-013 of HW-014 and HW-015: rejected for In Review; the HW-014 lower bound is not sound as drafted.
- HW-014 redrafted after the owner decision of 2026-11-08 (lower bound = part makers' minimum, upper bound [100] uF); draft requirement HW-016 (spare capacitor footprints on +5V) with TC-216; bound script with a sensitivity table.

### Changed
- Strict waiver limits of the spike profile `stitched-4l` lowered to the observed counts (owner decision 2026-11-08): `net_conflict` 0, `footprint_symbol_mismatch` 2 (C3, C4 only), `courtyards_overlap` 14 (U9 only); test added (DEV-002, DEV-004).
- Spike board: U1 and U9 schematic symbols carry the datasheet pad numbers (`layout_full.PAD`), `pcb_full.PADMAP` deleted, test points out of the BOM in the schematic; batch ring7 removes all 77 `net_conflict` findings (98 to 16 findings), no run passes the strict gate (HW-010, DEV-002).
- README images and captions of the hardware spike regenerated from the best of 12 runs (HW-010).
- Hardware spike PCB placement: soft ties pull the VBUS_IC and +3V3 current paths together (weights 1.5 and 3.0; in one 12-run batch two boards pass the strict gate and all power drops are under the 50 mV assumption); clean-up re-routes `connection_width` findings (HW-010).

### Fixed
- Hardware spike PCB gate: wires under 0.15 mm (default track now 0.15 mm), dangling vias (removed), hole-to-hole of stitch vias, silk findings (waiver DEV-006, declined by the owner 2026-11-08, off by default); the stitcher joins pads to existing ground vias, layer by layer, in retry passes; 6 new tests. Antenna strip set to the 4.6 mm of the ESP32-C3-MINI-1 datasheet and the module pad area placed outside it (the 21 unconnected module ground pads are gone); 1 mm slot beside the antenna end with a copper keep-out. Placement: VBUS_IC weight and movable-part radius 17.3 mm; +3V3 track 0.3 mm; optional two-pass routing (`KEYFIRST`, `FR_THREADS` in `run_pcb.sh`). VBUS_IC main path (J1, TPS2553 input, C2, TVS1) routed first at 0.6 mm and locked, branches at 0.2 mm (`KEYFIRST=1`); via removal keeps layer changes. Post-route clean-up `src/pcb_fix.py` (grid router for the leftover connections, rip-up of clearance findings, stub removal), 6 tests: on run pl8 the final board has 1 unconnected item (/ILIM) and only the tolerated known findings; the Freerouting step still varies between runs, so the board is not complete and the full flow is not proven repeatable (HW-010, HW-005, ADR-0003, ADR-0012).
- Hardware spike gate: ERC and DRC project files switch on the default-ignored checks (ignored-check maxima now 0); ERC has 0 findings; six repeat routing runs gave 2 complete boards (0 open items) and 4 with 1 to 3 open items; the LED stand-in footprint-filter finding is waived under DEV-002 (HW-010, ADR-0012, DEV-002).
- Hardware spike board uses datasheet-based footprints: ESP32-C3-MINI-1 (figure 11-1 numbers tested), TUSB321 X2QFN-12 redrawn from the TI drawing (the old pattern was wrong), TLV75733P SOT-23-5 for the 3.3 V regulator (ADR-0019, enable tied to input), WS2812B-2020 LED symbol with matching pin numbers (the old pairing mismatched the pins). New: `run_best.sh` (best of N routing runs), `pcb_power_check.py` (voltage drop and plane cuts), router rule to keep VBUS_IC and +3V3 off the plane layers (`OUTER_ONLY`). With the real footprints no run passes the strict gate yet (best: 1 open item); the VBUS_IC path drops 85 mV at 1.5 A in the best run (HW-010, ADR-0004, ADR-0019, DEV-002).
- Hardware spike board: experiment profile `SPIKE_PROFILE=fine` (0.1 mm track and space, vias 0.5 / 0.2 mm, within the JLCPCB multilayer minimums read 2026-11-08), ground plane In1 kept free of signals, J1 footprint copy without edge silk, `run_best.sh` copies the libraries; best of 4 runs is complete, strict-gate clean (waived findings only), ground plane in 1 piece; VBUS_IC drops 59 mV at 1.5 A (above the 50 mV analyst target). ADR-0020 drafted (Proposed, the owner decides) (HW-010, ADR-0020, DEV-006).
- CI: the licence-map check lists the TLV75733P and TMUX1101 evidence files as data (HW-012, ADR-0015).

### Added
- README: status table, schematic and board images and captions refreshed for the spike board with the AND gate and the supply-pin protection (one routed run, strict check fails), new housing model images (exploded and back view) drawn by `mech/render_readme_images.sh`; FreeCAD views are tool output (HW-010, MECH-007, ADR-0014).
- Hardware spike schematic: SN74LVC1G08 AND gate for GATE_OK_RB (HOLD_OK and FAULT_N), GPIO4 and GPIO1 freed, series resistor, 100 nF and BZX84C5V1 zener at the TUSB321 and TMUX1101 supply pins; six new tests; PCB stage not rerun (HW-010, HW-012, ADR-0016, ADR-0018).
- Hardware: datasheet evidence for the BZX84C5V1 zener and the SN74LVC1G08 AND gate (quotes checked against the PDF pages); surge analysis rerun with the zener datasheet corners (HW-010, HW-012, ADR-0016, ADR-0018).
- Mechanics: housing model completed with lid spigot and snap bumps, PCB posts, button hole and a bayonet detent; tolerance check for the spigot, skirt and ledge (MECH-001, MECH-004, MECH-005, MECH-007, MECH-009).
- Mechanics: FreeCAD coupon generator for the diffuser (3 plates, 3 spacer rings) and the bayonet floor; bayonet lock concept (entry sector, lips, stop) with a mating accessory ring and a model check of the lock action (MECH-002, MECH-007, ADR-0014).
- Mechanics: first FreeCAD housing generator (base with USB-C window, annular bayonet recess, three PCB snap hooks, lid), shared dimension file and a tolerance check with tests; evidence report `mech-housing-first-model.md` (MECH-001, MECH-004, MECH-006, MECH-007, MECH-009).
- HW-012 evidence files for the TLV75733P (supply, current and thermal-resistance ratings) and the TMUX1101 (supply ratings): 9 claims, all `unverified` (AI-extracted, quotes checked against the PDF pages by `scripts/check_part_evidence.py`, 0 errors); the PDFs are in the local datasheets folder, not in the repository (HW-012, ADR-0017, ADR-0019, ADR-0016).
- Gate logic `sw/app/src/gate.c` with 20 unit tests on native_sim (SW-005, SW-006, SW-007, SW-009, SW-010; host level only, 20 of 20 pass, mutation check 8 of 20 fail, gcc and clang-tidy clean); evidence report `docs/verification/reports/sw-gate-unit-tests.md`; no Zephyr binding, no target build, no bench (plan 07).
- Plan 07 increment 1: ztest smoke test under `sw/app/tests/gate/` (builds and passes on native_sim/native/64 with Zephyr v4.5.0 locally; tests no requirement); `scripts/ci_sw.sh` runs twister on `native_sim/native/64` (plan 07, SW-005, SW-009).
- Owner accepted ADR-0014 (annular bayonet, coupon test as the gate, dovetail fallback) and approved MECH-006, MECH-007 and MECH-008 on 2026-11-07 (ADR-0014, MECH-006, MECH-007, MECH-008).
- Owner approved MECH-001, MECH-002, MECH-003, MECH-004, MECH-005 and MECH-009 on 2026-11-07; MECH-006 to MECH-008 wait for ADR-0014 (MECH-001 to MECH-009).
- Mechanical requirements MECH-001 to MECH-008 redrafted (version 0.2, all Draft) to match ADR-0003, ADR-0011 and ADR-0014 (PETG, off-centre module, annular bayonet, thermal limit, window and label), new MECH-009 (PCB snap hooks and reopening) with stub TC-309; open items are listed in the journal (MECH-001 to MECH-009, ADR-0011, ADR-0014).
- TC-210 step 4 extended: peak of VBUS_IC and +5V at hot-plug against the part ratings, with a trigger for the fallback options; owner chose to measure first (HW-010, TC-210, ADR-0010).
- Part-rating table for VBUS_IC and +5V (`docs/verification/reports/analysis-vbus-5v-part-ratings.md`): the TPS2553 (7 V), the 3V3 regulator (6 V) and the LED placeholder (5.3 V) are not safe against an 8 to 15 V TVS clamp, so the surge problem is wider than the two pins that got a resistor and a zener; three options for the owner, nothing decided (HW-010, ADR-0010, ADR-0016, RV-011).
- Owner approvals of 2026-11-07 (second round): SW-009 and HW-010 amendments folded in as Approved, the TC-105, TC-106, TC-107, TC-109, TC-110, TC-210 and TC-213 procedures approved as working procedures (nothing run), plan 07 approved with conditions; RV-011 resolution record (SW-009, HW-010, RV-011, TC-105, TC-210).
- ADR-0018 Accepted by the owner as option E: FAULT_N is combined with the hold-off readback by an AND gate that replaces the buffer, so GPIO1 and GPIO4 are free for the orientation sensor and the firmware still sheds on a limiter fault; SW-009 and HW-010 text changes are Proposed (ADR-0018, SW-009, HW-010, HW-011).
- Owner approvals of 2026-11-07 recorded: ADR-0019 Accepted (standard-package regulator with a firmware limit); SW-005 single-input table and unknown states, SW-007 flag, clock and watchdog counting, SW-010 timeout of [8] s folded into the requirements; ADR-0010 update for open points 3 and 4 (ADR-0019, ADR-0010, SW-005, SW-007, SW-010).
- Proposed single-input rewrite of SW-005 criterion 4 and TC-105 cases (g) and (h): one CC input, unknown states are readback inconsistencies (SW-005, RV-011 findings 8 and 9).
- ADR-0018 (FAULT_N input removed for the sensor pins; the assistant recommended keeping it, the owner chose removal) and ADR-0019 (3V3 regulator, standard package with a firmware limit; the assistant recommended the pad package), both Proposed; Proposed amendments of SW-007 and SW-010 for the flag, elapsed-time clock and watchdog resets (ADR-0018, ADR-0019, SW-007, SW-010, SW-009, HW-010).
- Goldfish review RV-011 of plan 07, the draft test procedures and the supply-pin, regulator and CC-pin analyses: 17 merged findings, outcome "approved with actions"; fixes to the surge script (zener corners, 27 tests), TC-106, TC-107, TC-109, TC-110 and TC-210 (RV-011, HW-010, SW-005, SW-006, SW-007, SW-009, SW-010).
- Regulator heat analysis (`hw/sim/scripts/regulator_heat.py`, tests): the TLV75733P is cool in normal Wi-Fi use; a firmware download is marginal in the standard package; continuous transmit fails. DYD (exposed pad) variant recommended. Owner approved the supply-pin surge values on 2026-11-07. Options note for the TUSB321 CC pins (HW-010, HW-013, ADR-0016; `docs/verification/reports/analysis-regulator-heat.md`, `analysis-cc-pin-protection.md`).
- Supply-pin surge analysis: ngspice script and tests derive 1 kohm (TMUX1101) and 470 ohm (TUSB321) series resistors with 100 nF and a 5.1 V zener at the pins; Proposed amendment of HW-010 updated; zener datasheet not read, nothing measured (HW-010, ADR-0016, DEV-001; `docs/verification/reports/analysis-supply-pin-surge.md`).
- Owner decisions of 2026-11-07 recorded as Proposed amendments: series resistor and 5.1 V zener at the TMUX1101 and TUSB321 supply pins, TLV75733P as the 3V3 regulator candidate, FAULT_N given up for the orientation sensor pins, SW-005 gives the middle step for 1.5 A and 3 A chargers until TC-213 (HW-010, HW-011, SW-005, SW-009, HW-013; `docs/journal/2026-11-07-surge-regulator-pins-steps.md`).
- Firmware plan 07 for the gate logic slice (Draft, not reviewed) with the spike GPIO pin map taken from the generator, and a draft TC-107 procedure; the shortlist report now carries the TUSB321, TPS3840 and TLV757P datasheet readings (SW-005, SW-006, SW-007, SW-009, SW-010, HW-010; `docs/plans/07-gate-firmware.md`).
- Draft test procedures for TC-210, TC-213, TC-105, TC-109 and TC-110 (HW-010, HW-013, SW-005, SW-009, SW-010; Draft, not reviewed, not run) and a shortlist report for TVS1 and the 3V3 regulator with the finding that a plain 5 V TVS cannot clamp below the 6 V switch supply rating (`docs/verification/reports/shortlist-tvs1-3v3-regulator.md`; HW-010, HW-012, ADR-0016).
- Owner decisions of 2026-11-07 recorded: ADR-0003 Accepted (antenna option A first, spike 7.2 as a hard gate), ADR-0011 Accepted for the prototype only (concept B, FDM, PETG); ADR-0014 stays Proposed; M4 sag band to be measured first. Record: `docs/journal/2026-11-07-adr-0003-0011-decisions.md` (ADR-0003, ADR-0011, ADR-0014, HW-010).
- Spike generators and test fixtures brought to the approved HW-010 values: E96 ILIM resistors, six 100 nF hold-off capacitors, TMUX1101 supply from VBUS_IC, CC_OK_3A path deleted; 185 spike tests pass; routing and the routed DRC fixtures are not regenerated (HW-010, ADR-0016, ADR-0012).
- ADR walkthrough of 2026-11-07: ADR-0001, ADR-0002, ADR-0004, ADR-0005, ADR-0006, ADR-0007, ADR-0008, ADR-0010, ADR-0012, ADR-0017 and ADR-0016 Amendment 2 Accepted by the owner (with the open conditions recorded in each ADR); ADR-0003, ADR-0011 and ADR-0014 revised and not accepted. Record: `docs/journal/2026-11-07-adr-approval-walkthrough.md`.
- Goldfish review RV-010 of the HW-010 gate bundle (HW-010, SYS-020, SW-005 to SW-009, ADR-0016 Amendment 2): 29 findings, outcome "rejected for approval as written" until the open actions close; no approval. `hw/sim/scripts/amendment2_numbers.py` reproduces the Amendment 2 hold-off and ILIM numbers. Corrections: ADR-0016 option C score 57 and Related list, SYS-020 worst case about 1175 ms for the six 100 nF set. HW-010 Proposed text is consolidated into one revision (current-values table, acceptance criteria to add, open owner decisions); notes added to the 2026-11-05 owner record and DEV-001 for the E96 resistor decision. Proposed drafts for RV-010 findings 15 and 26: SYS-020 reset wording, SW-005 count as the normative criterion, SW-006 time base, SW-007 retained-flag options, SW-009 shed and reset handling. Owner decisions of 2026-11-07 recorded in the journal; Draft HW-013 (thermal limit at the top step) and SW-010 (watchdog restart to the lowest step) with TC-213 and TC-110; Proposed DEV-005 (ADR-0016 accepted before its review); SYS-020 Proposed text for the three steps; TUSB321 debounce note (datasheet states 133 ms typical, no maximum). Owner decision 3 (TMUX1101 over-voltage removed by design): analysis `analysis-tmux1101-supply-from-vbus.md`, ADR-0016 update, HW-010 Proposed revision, DEV-001 and RISK-045 notes (switch supply from VBUS_IC; Proposed, nothing built or measured).
- Spike library tables (plan 06 A-11; spike only, nothing Approved): the generators write the project file, `sym-lib-table`, `fp-lib-table`, a `busylight_gate` symbol library and a `CUSTOM` footprint library next to the generated schematic and board, so kicad-cli resolves every library nickname. ERC `footprint_link_issues` 96 to 0 and `lib_symbol_issues` 241 to 0, placed DRC `lib_footprint_issues` 93 to 0; the matching caps are removed from `known-open-violations.json` (HW-010, ADR-0012).
- PCB spike G3 second run and plan 06 amendments A-8 to A-10 (Proposed, owner-decided 2026-11-06; nothing Approved): `planes=inner` for the router (only the inner GND plane visible; `pcb_rules.router_keeps_zone`, early argument check in `run_pcb.sh`, tests first), cap investigation (ERC and DRC caps not raised; the excess is +7 net parts and the missing library table) and the observed `inner` run: M1 = 16, M2 = 92, M3 = 0 (gate not met). Spike only.
- ADR-0016 Amendment 2 (Proposed, nothing Accepted): ILIM select switch TMUX1101DCKR (fallback TS5A3166DBVR), 0.1 % ILIM resistors 47.0 k / 56.2 k / 27.4 k + 301 ohm and hold-off capacitor set 6 x 100 nF C0G (owner choice 2026-11-06; earlier 220 + 220 + 100 + 68 nF), with four alternatives, weighted criteria from `analysis-ilim-switch-replacement.md`, the open 3V3-off condition (DEV-001, RISK-045), bench check TC-210 (d) and critical review (ADR-0016, HW-010, SYS-020).
- Owner decisions of 2026-11-05 (second record, `docs/verification/reports/owner-decisions-2026-11-05-b.md`) as Proposed amendments only, nothing Approved: SYS-020 time to the raised limit [2] s; HW-010 ILIM select switch TMUX1101DCKR (fallback TS5A3166), ILIM resistors 47.0 k / 56.2 k / 27.4 k + 301 ohm, hold-off capacitor 220 + 220 + 100 + 68 nF C0G; SW-005, SW-006, SW-007 and SW-009 amendments; Draft outlines of TC-105, TC-109 and TC-210; DEV-001 (Proposed) and RISK-045 for the 3V3-off ILIM condition (SYS-020, HW-010, SW-005, SW-006, SW-007, SW-009, ADR-0016).
- PCB spike clean-route plan 06 (Approved by the owner 2026-11-05 for the spike only), goldfish review RV-009 (readiness NO-GO three times; last fixes not re-reviewed) and the G1 geometry work: 16 smaller LED stand-in footprints, largest-dimension check (59.8 mm spike limit), placement acceptance rules and DRC fixtures. Work in progress: strict placed DRC still fails (29 `footprint_symbol_mismatch` against a cap of 13), T13 and the overlap-penalty floor are not written, nothing is routed.
- PCB spike G2: all PCB rule numbers in `pcb_rules.py` (pure Python), a generated `.kicad_dru`, `net_class_widths`, a per-ref DRC allow-list with DEV-002 (proposed, not approved) and a placement overlap floor (plan 06; spike only; nothing Approved).
- PCB spike G3 (first run, plan 06 amendment A-7; spike only, nothing Approved): `run_pcb.sh` checks the pinned Freerouting jar hash, stitches, writes `run_meta.json` and runs the `stitched-4l` DRC; metric helpers `count_unrouted` (M1) and `count_unconnected` (M2); the stitcher exits non-zero when a pad fails. Result of the run: M1 = 0, M2 = 71 (GND), so the G3 pass criterion is not met. DEV-003 and DEV-004 proposed, not approved.
- README gallery shows the spike schematic (two legible crops) and the 4-layer spike board (3D view and copper layers), exported by `hw/kicad/spike-gate/render_readme_images.sh`; the captions state the numbers of that run (Freerouting left 40 nets unrouted; after stitching 252 DRC violations and 57 unconnected items on 4 nets; the strict waiver check of 475 items was not rerun on this routing) and that nothing is approved (README, ADR-0012).
- Datasheet evidence format (ADR-0017 Proposed, HW-012 Draft, TC-212 stub): `hw/evidence/` with a JSON Schema and per-part YAML files for the components of the full-board schematic, `scripts/check_part_evidence.py` and `scripts/part_evidence.py`. All 348 entries are `unverified` or `source-missing`; none is verified (`docs/verification/reports/part-evidence-fill-report.md`).
- Spike (ADR-0012 Proposed, nothing Approved): full-board schematic, exclusive current-limit steps (U13), E192 0.1 % ILIM values, parallel C0G hold-off capacitors, and a script-generated PCB with placement, a mechanical outline taken from the `spike/mech-concept` spike and a Freerouting run, in `hw/kicad/spike-gate/`; the board is not DRC clean and not fully routed (`docs/verification/reports/spike-pcb-placement-routing.md`).
- Draft process rules for generated hardware designs (`docs/process/hw-generated-design-guardrails.md`): strict ERC/DRC, independent checks, protected paths, sign-off gates; the spike ERC/DRC scripts now fail on any finding that is not on a visible waiver list (`hw/kicad/spike-gate/known-open-violations.json`).
- Consolidation record of the branches `docs/review-actions`, `spike/hw-gate` and `feature/part-evidence` (`docs/verification/reports/consolidation-2026-11-05.md`) with the open owner decisions.
- HW-006 (Draft) no longer lists UART test points; HW-010 proposed amendment names GPIO20 and GPIO21 for the two gate-enable readbacks (owner choice "test point route", 2026-11-04; module datasheet read: pins 30 and 31 are not strapping pins; GPIO21 outputs ROM messages at start-up) (HW-006, HW-010, SW-009).
- Reports of the gate spike moved from branch `spike/hw-gate` into `docs/verification/reports/`: gate fragment, own schematic writer, goldfish reviews of versions 2 and 3a, datasheet evidence for the gate logic, the supervisor and the inverter (HW-010, ADR-0016). The spike code stays on the branch and is not merged (ADR-0012 is Proposed).
- Proposed amendment to HW-010 (readback inputs of the hold-off and gate enable states for SW-009); the Approved text is unchanged until the owner confirms.
- SW-009 (follow the hardware gate state and shed load when the gate closes, Draft, needs a readback line that HW-010 does not have yet) and TC-109 stub; RISK-044 extended with the findings of the second goldfish review of the gate (SW-005, HW-010).
- RISK-044 (hold-off supervisor of the current-limit gate fails or is mis-set) and a TC-210 extension (VBUS dip restart, shorted or open delay capacitor, supervisor output forced high); candidate supervisor and datasheet evidence are on branch `spike/hw-gate` (HW-010, RISK-042).
- Re-run of the ADR-0012 gate G1 stand-in spike (`docs/verification/reports/hw-flow-g1-rerun.md`, Draft): ERC, parity, DRC 0 and identical dumps reproduced locally; CI, Freerouting run, pinning and the peg-azimuth decision still open; ADR-0012 stays Proposed on the owner's choice "not yet".
- HW-010 (hardware current limit on the USB input) Approved by the owner 2026-11-04 on instruction in the session; uncovered faults stay listed (RISK-029, RISK-042).
- HW-003 (USB-C power input) Approved by the owner 2026-11-04 on instruction in the session.
- CC detection IC chosen by the owner: TUSB321, PTN5150A as fallback if the IC ambient exceeds 70 C (ADR-0016, HW-003, RISK-043).
- Licence record: per-file licence tag counts of the pinned Zephyr, MCUboot, hal_espressif and Mbed TLS trees, NonCommercial definition from the licence text; HW-010 hold-off upper limit of [600] ms (spike finding F7: a plain CMOS threshold is too loose for the timer).
- Start-up hold-off of at least [200] ms on the high-step gate: HW-010 acceptance criteria, TC-210 procedure points, ADR-0016 amendment (owner to confirm) and RISK-042 (reason: the IC output level before its first debounce is not stated in the datasheet).
- Datasheet evidence record for the CC detection IC (`docs/verification/reports/cc-ic-datasheet-evidence.md`, Draft): TUSB321 Rev C read (supply from VBUS, 0 to 70 C, CC pins 6 V, thresholds, OUT1 and PORT behaviour; power-up output level not stated); PTN5150 Rev 1 (older) as a second-source hint; RISK-026 and RISK-043 updated.
- Spike on branch `spike/hw-gate`: owner decisions of 2026-11-05 (b) implemented in the schematic generators (TMUX1101 ILIM select switches U14 and U15 with 100 kohm pull-downs on SEL, ILIM resistors 47.0 k / 56.2 k / 27.4 k + 301 ohm at 0.1 %, hold-off set 220 + 220 + 100 + 68 nF C0G), placer weights for the gate rules, analysis re-run (step windows, hold-off window, readback margin) and report `docs/verification/reports/spike-decisions-2026-11-05-b-implementation.md` (Draft; no bench run, stock and 3V3-off open item not closed).
- Desk reports of 2026-11-05 on the hardware gate spike (all Draft, nothing Approved): ILIM select switch replacement for the 2N7002 with a 3V3-off sequencing addendum (TMUX1101 recommended, open item), JLCPCB stock and purchasable C0G hold-off sets, Zephyr USB-Serial-JTAG console and GPIO pull facts for SW-009, and a SW-005 against hold-off timing analysis (SYS-020 1 s not met) with script and test (`hw/kicad/spike-gate/sim/sw005_holdoff_timing.py`). Not bench-run; stock figures unconfirmed.
- Spike on branch `spike/hw-gate`: the ADR-0016 gate fragment built from code (SKiDL), checked with KiCad ERC, a netlist parity check and a truth-table test; report `docs/verification/reports/spike-hw-gate-fragment.md` (Draft; exploratory, no design content for `main`).
- ADR-0010 open points 1 and 2 decided by owner instruction (recommended options: first step 506 to 623 mA with a 500 mA firmware budget; top step 1366 to 1577 mA with a 1350 mA firmware value); HW-010 and RISK-027 carry the numbers. ADR status stays Proposed.
- Licence compatibility table and record of licence facts (`docs/regulatory/technical-file/05-cybersecurity/licence-compatibility.md`, Draft): KiCad libraries, Mbed TLS, Noto Sans and Creative Commons facts checked against sources on 2026-11-04; Zephyr and MCUboot top-level licence files read, Mbed TLS pinned commit and the Espressif binary module declaration (Apache-2.0) read; Espressif's own terms not verified (ADR-0015 item 8, RV-008 P14).
- Draft software requirements SW-005 to SW-008 (raise the USB current step only after a stable reading, reduce load before lowering, back-off after brown-out, tolerance of Power Delivery traffic) and test stubs TC-105 to TC-108; closes the RV-008 action "write the software requirement" (RV-006 S3 to S6). Status Draft; owner approval needed.
- Goldfish review RV-008 of ADR-0015 and ADR-0016 with amendments (gate covers every step above the first; independence only against firmware faults; RISK-042 and RISK-043; `LICENSE.md` reworded to what the licences grant; SPDX headers on the remaining `sw/` files; outside pull requests paused in the template).
- ADR-0015 (licensing corrected and completed) and ADR-0016 (independent hardware gate for the high current step) Accepted by the owner 2026-11-04; ADR-0013 and ADR-0009 are Superseded. Applied: `.claude/` under Apache-2.0, `NOTICE` file, SPDX headers on code files, `LICENSE.md` with the purchased-unit grant, the non-commercial reading, name, patents and authorship points (not legal advice).
- Options sheet for the back layout (five options with the accessory mounted); `scripts/check_license_map.py` (fails when a code file falls under the documentation licence, in CI); HW-003 and HW-010 drafted for the CC detection IC gate of ADR-0016; NEED-012 renamed with an acceptance criterion. Owner instruction to follow the recommended options recorded in ADR-0015 and ADR-0016 (status stays Proposed).
- Review actions: spike report on the layout of the back (annular bayonet proposed; spike code on `spike/mech-back-layout`), ADR-0015 (licensing corrected and completed; would supersede ADR-0013), ADR-0016 (independent hardware gate for the high current step; recommends a CC detection IC ANDed with the firmware GPIO).
- Goldfish reviews RV-005 (ADR-0013 licensing), RV-006 (ADR-0009 and ADR-0010 USB power) and RV-007 (ADR-0014 and the orientation and mounting requirements); RISK-035 to RISK-041; outside contributions paused until the contributor terms have a legal check; REUSE code globs extended.
- Diagram check (`scripts/build_diagrams.sh --check`) compares structure, labels and colours, not coordinates, because text widths depend on the machine's font metrics (`scripts/svg_normalize.py`, with tests).
- Diagrams use an explicit font (Noto Sans) and CI installs it, so box sizes do not depend on the machine's default font.
- README gallery: architecture block diagram, stand-in KiCad board render and placeholder housing concept preview (image of the mechanical spike under `docs/verification/reports/images/`).
- CI docs job: PlantUML 1.2026.8 pinned by SHA-256 (the Ubuntu package draws differently); block diagram uses the built-in layout engine so Graphviz versions cannot change it.
- Draft requirements NEED-020 to NEED-022 (orientation, clock mode later, mounting), SYS-047, HW-011, MECH-007, MECH-008 and test-case stubs TC-047, TC-211, TC-307, TC-308; MECH-006 rewritten for the label on the back.
- ADR-0014 (mounting interface on the back; Proposed: printed bayonet, fallback dovetail). Owner decisions recorded 2026-11-04: unit mounted horizontal and vertical, label on the back, orientation sensor added, clock mode in a later release.
- Goldfish review RV-004 of plan 05 and ADR-0011 (housing): not ready for approval; 30 findings with resolutions and owner decisions listed. Plan 05 section 3 scores corrected to the ADR values.
- CI fixes after the first GitHub run: npm lockfile for the diagram tools, root user in the KiCad container, pinned FreeCAD AppImage, virtual environment for the software job.
- Risk register: RISK-027 to RISK-030 (hardware current limit band, 5 V rail collapse, limit step stuck high, limit switch availability) from ADR-0010.
- Continuous integration (`.github/workflows/ci.yml`): documentation checks, Python tool checks, hardware (`scripts/ci_hw.sh`), mechanical (`scripts/ci_mech.sh`) and software (`scripts/ci_sw.sh`) jobs; `pyproject.toml` for the tool environment. Hardware and mechanical jobs report NOT RUN until sources exist.
- README rewritten as a project front page (honest status, planned features, roadmap); licences added: Apache-2.0 for code, CC BY-NC-SA 4.0 for documentation, hardware and mechanics (`LICENSE.md`, `LICENSES/`, `REUSE.toml`, `reuse lint` in CI); ADR-0013 (licensing, Accepted by the owner 2026-11-04); draft contribution terms in `CONTRIBUTING.md`.
- ADR-0012 (hardware design flow, Proposed) with goldfish review RV-003, a KiCad feasibility spike report (Draft) and RISK-032 to RISK-034.

### Changed
- HW-010 revision: the pull-down sentence now describes the network that the spike draws (10 kohm and 100 kohm in parallel on each gate enable net); no part change (HW-010, SW-009).
- DEV-005 (ADR-0016 accepted before its own goldfish review) Approved by the owner on 2026-11-07 with updated compensating measures; DEV-001 stays Proposed until TC-210 (d) (DEV-005, DEV-001, ADR-0016).
- HW-013 Approved by the owner on 2026-11-07 (thermal limit in the closed housing at the top current step); bracketed figures stay open and the TC-213 procedure is still to be written (HW-013, SYS-020, RISK-005).
- SW-010 Approved by the owner on 2026-11-07 (watchdog serviced only from the select loop, restart returns the select outputs to low within [10] s); the select pin state at reset is checked on the prototype (SW-010, SYS-020, SYS-027).
- SW-009 Approved by the owner on 2026-11-07 with all three amendments folded in (HOLD_OK_RB validity, GPIO20 and GPIO21 without pulls, USB-Serial-JTAG console, shed in [X] ms, reset after a gate closure tolerated); [X] is set from a measured rail hold-up and the Kconfig symbols are not verified by a build (SW-009, SW-007, SYS-020).
- SW-007 Approved by the owner on 2026-11-07 with both amendments folded in (hold-off brown-out definition, retained flag with HOLD_OK_RB-only fallback); retention of the flag is checked on the prototype (SW-007, SW-009).
- SW-006 Approved by the owner on 2026-11-07 with both amendments folded in (shed within [50] ms of the stable fall or an enable readback fall, select low after; reset wording aligned with SYS-020); the [50] ms stays open until a latency is measured (SW-006, SYS-020, SW-009).
- SW-005 Approved by the owner on 2026-11-07 with both amendments folded in (6 equal reads at 100 ms, 700 ms from HOLD_OK_RB rising, restart after every falling edge, value table); bracketed values stay open until measured (SW-005, SYS-020).
- HW-010 revision approved by the owner on 2026-11-07 (TMUX1101 switches on VBUS_IC, E96 resistors, six 100 nF hold-off, nine bench criteria, CC_OK_3A deleted); the debounce margin, the M4 sag band and the unchosen TVS1 and 3V3 regulator stay open (HW-010, ADR-0016).
- SYS-020 Approved by the owner on 2026-11-07 with the three amendments folded in: [2] s to the raised limit, a reset after the gate closes is allowed with restart at the lowest step, and three current steps with step 2 as the thermal cap. Bracketed values stay open until measured (SYS-020, HW-010, HW-013).
- Spike on branch `spike/hw-gate-pcb-g3`, owner decision 2026-11-06: ILIM resistors in the schematic generators are now one 56.9 k (R_ILIM2) and one 27.7 k (R_ILIM3), 0.1 % 0603, R_ILIM1 stays 47.0 k; R_ILIM3B (301 ohm) and its net are removed (53 nets, 92 components); fixtures, tests, `sim/ilim_steps.py` and the implementation report are updated. These two values have no confirmed LCSC or JLCPCB source at 0.1 % 0603. Windows 504.2 to 616.6, 929.6 to 1085.9 and 1381.2 to 1566.7 mA; Freerouting and bench not run; nothing Approved (HW-010, SW-009, ADR-0016).
- Zephyr pin in `sw/west.yml` moved from v4.2.0 to v4.5.0 (owner approval 2026-11-03).

### Added
- FreeCAD spike model results (branch `spike/mech-concept`, not merged): skirt fixed, module offset 1.0 mm gives about 15 mm antenna clearance, USB-C variant V1 (board tab) passes all checks at 57.43 mm.
- RISK-031: the FreeCAD spike model shows the USB-C receptacle collides with the LED ring; options listed in the owner guide.
- Mechanical plan 05 revised (Draft): label on the underside and a flat-lying unit assumed (owner confirms), housing 53.0 x 16.5 mm with PCB 46 mm, antenna rules split between MECH-003 and an ADR-0003 finding; analysis re-run in the concept report (section 8).
- Draft mechanical plan 05, ADR-0011 (housing concept: opaque base plus translucent lid, FDM, PLA excluded) and the concept analysis report (light, thermal, tolerance); no CAD yet.
- Owner input recorded: read USB-C CC with the ADC (ADR-0009) and have a hardware current limit; draft HW-010 and TC-210; ADR-0004 item 4 updated.
- ADR-0010 (Proposed): hardware current limit on the USB input, recommends TPS2553 with a firmware-switched limit resistor (HW-010).
- Draft RISK-024..026 from ADR-0009; ADR-0009 summarised in the owner guide.
- Draft ADR-0009 (Proposed): USB-C power input and detection of the advertised source current; ADC read of the CC lines recommended, dedicated CC IC as fallback; cap value and ADC-or-IC choice left to the owner (SYS-020, HW-003).
- Power budget addendum for 900 and 1350 mA limits; SYS-001 rationale notes that the brightness figure depends on the source's current.
- Owner decision recorded: allow a higher USB current when the source advertises it (SYS-020, HW-003, ADR-0004, RISK-003); default stays [500] mA.
- PC prototype record for the ADR-0004 current limiter (scratchpad only): 41.7 M test frames without failure, 532 B code on rv32imc; proposals for level mode and the below-dark-current case noted in ADR-0004.
- PC prototype of the ADR-0005 extractor and mapper (scratchpad only): 27 tests, 5 million fuzz executions without crash, 4057 B and 512 B stack on rv32imc; document nesting limit and number wording added to SW-001 and ADR-0005 (Draft/Proposed).
- Spike 7.5 paper power budget with datasheet sources: at 500 mA the Wi-Fi TX peak leaves 46 mA (LDO) to 148 mA (buck) for 16 LEDs; USB current-limit decision added to the owner guide.
- Spike 7.1 E12 and E2b follow-up (build only): WPA2-Enterprise costs about +70 KB flash and +6 KB static RAM; the step-7 jump is flash padding; TLS heap can be reduced in builds that link.
- Draft vulnerability handling and disclosure process (`05-cybersecurity/vulnerability-handling.md`); contact and legal entity open.
- Owner review guide (`docs/plans/04-owner-review-guide.md`): approvals waiting, open decisions with recommendations, findings so far, side effects.
- Spike 7.1 E2b size ladder (build only): throw-away product-like image is 792 KB signed (43 % of the default slot), static RAM 285 KB of 360 KB; flash looks less critical than RAM.
- ADR-0007 evidence update and RISK-023: secure boot and flash encryption are not available in the Zephyr sysbuild MCUboot for the C3; the standalone Espressif port with a pinned ESP-IDF HAL is the only route found (owner decision pending).
- Draft spike 7.1 runbook for the first hardware session (read-only kit checks, flashing the two E1 images, log format); not run.
- Consistency pass over ADRs, key-management draft, SYS-036, RISK-006/008/009 and the spike reports (stale text and contradictions fixed after a fresh-reviewer check).
- Consistency pass over plans 02/03, ADR headers and spike reports.
- Spike 7.1 E2a paper flash budget: default 4 MB layout leaves 128 KiB unassigned; image limit at 75 % of a slot is about 1.31 MiB (1.38 MiB with unused areas reclaimed).
- Chip revision >= v0.3 (secure boot) added to HW-008 and ADR-0007; virtual-eFuse rehearsal noted in ADR-0007 and RISK-022.
- Spike 7.1 E11a partial record: ECDSA P-256 build works (bootloader 5 KB smaller than RSA-2048); virtual eFuse option and ESP32-C3 revision >= v0.3 requirement for secure boot found in source; secure boot and encryption not yet built.
- Spike 7.1 E1 build record: hello_world and Wi-Fi shell build for `esp32c3_devkitm` with Zephyr v4.5.0 and SDK 1.0.1 (build only; nothing flashed or run); default 4 MB flash layout and default signing key noted.
- Desk-survey findings applied to the Proposed ADR-0004, 0006, 0007, 0008 and the key-management draft: SPI LED route, radio-first rule for keys and passphrases, PSA key handling, one-client access point, RSA-3072 secure-boot key vs EC256 release key, flash `write-block-size` and swap-mode checks.
- Owner decision recorded: a lost or leaked release key means a recall of locked units (no second key in the bootloader); ADR-0007, key-management document and RISK-006 updated.
- Spike 7.1 E0 pass 2: Zephyr v4.5.0 source read (AP+STA in the driver, WPA2-Enterprise mapped to the Espressif blob, SPI LED route, hardware random source needs the radio on, EC256 signing fits secure boot plus encryption).
- Spike 7.1 E0 desk survey report (documentation only, nothing built): ROM secure boot signs the bootloader with RSA-3072, only an SPI `ws2812` route found for the LEDs, AP+STA, captive-portal DNS and WPA2-Enterprise unconfirmed on the C3.
- Goldfish review RV-002 of plan 03 (spike 7.1); plan 03 revised: desk survey E0, split E2/E11, power experiment E14, secrets handling, kit accounting and evidence rules.
- Draft plan 03 for spike 7.1 (Zephyr on ESP32-C3): 13 experiments with pass rules and fallbacks, shopping list, branch and report rules.
- Draft hardware requirements HW-001..009 and mechanical requirements MECH-001..006 with test case stubs TC-201..209 and TC-301..306 (no CAD work done; values in brackets are proposals).
- Goldfish readiness pass recorded in RV-001: verdict NO-GO with ranked blockers; plan 02 header and ARCH note brought up to date.
- Draft key-management document (`docs/regulatory/technical-file/05-cybersecurity/key-management.md`): key inventory, signing rules, production steps, rotation and recovery; owner review pending.
- Draft requirements SYS-043 (secure boot and flash encryption), SYS-044 (SBOM), SYS-045 (vulnerability handling, 5-year support), SYS-046 (recovery of locked units), SW-001..004 (input limits, session limit, fuzz tests, image confirmation) with test case stubs TC-043..046 and TC-101..104; SYS-026 now says what the 25 % margin refers to.
- Owner input on market (EU), distribution (open source first, sellable later), support period (5 years) and security (secure boot and flash encryption wanted) recorded in the regulatory applicability, ADR-0007 (revised to a staged secure boot and flash encryption plan, still Proposed) and RISK-022.
- Risk register with 21 draft risks (RISK-001..021), architecture blocks ARCH-001..019 in `docs/architecture/blocks.md`, and a first regulatory applicability assessment with open compliance questions and draft compliance-matrix rows (none verified, owner has not reviewed).
- Project structure for Zephyr software (`sw/`), KiCad hardware (`hw/`) and FreeCAD mechanics (`mech/`).
- Engineering process: lifecycle with gates, Elephant-Goldfish planning, document control, verification strategy.
- Standards: C coding (CERT C and MISRA C subset), hardware and mechanical design-for-X, writing (ASD-STE100 based), diagrams as code.
- Regulatory scaffolding for EU market access: applicability assessment, compliance matrix, technical-file index.
- Traceability check (`scripts/check_traceability.py`), documentation style check (`scripts/check_docs_style.py`), diagram build (`scripts/build_diagrams.sh`).
- Stakeholder needs (NEED-001 to NEED-019) and draft system requirements (SYS-001 to SYS-031) for the first release:
  Jenkins status by push and by REST polling, 16-LED RGB ring, Wi-Fi provisioning with web interface, OTA update,
  user-uploaded CA certificates, per-unit password, 3D printed housing.
- Draft user documentation skeleton, `CONTRIBUTING.md` and `SECURITY.md`.
- System design plan 02 with ADR-0002 to ADR-0008 (platform ESP32-C3, antenna, LED drive, mapping model, provisioning, update and boot security, transport protection) and goldfish review record RV-001. All ADRs are Proposed (ADR-0007 was Accepted and set back by the owner after the review).
- Draft system requirements SYS-032 to SYS-042 (level display, push liveness, LAN transport protection, own certificate, WPA2-Enterprise headroom, PC simulation, Wi-Fi range, web password rules, push request format, factory reset scope, device name) with test case stubs.
- Claude Code project instructions and skills (`CLAUDE.md`, `.claude/skills/`).
