spoorcc/busy-light/docs/journal/2026-11-07-adr-0003-0011-decisions.md

# 2026-11-07: ADR-0003 and ADR-0011 decisions, ADR-0014 and M4 handling

Owner decisions taken in the session after the open-decision walkthrough (the assistant recorded them; only the owner approves).

| Item | Decision |
|---|---|
| ADR-0003 | Accepted: option A first (module off-centre, built-in antenna). Spike 7.2 (loss of at most [6] dB against a bare module) is a hard gate before any product layout. The fail path is not pre-picked; the owner chooses later between relaxing SYS-022, a changed LED ring, or a bare chip with its own ADR. |
| ADR-0011 | Accepted for the prototype only: concept B, FDM, PETG. Dimensions stay working values; TC-305 gates any thermal claim; production material not decided. |
| ADR-0014 | Stays Proposed. Decided after ADR-0003 and ADR-0011, with the coupon test (100 cycles, heat soak) as the gate and the dovetail as fallback. |
| M4 (VBUS sag band) | Measure first (TC-210 case 5), accept as a bounded residual risk with a deviation if it cannot be closed; add a fix only if the measurement fails. No design change now. |

Not run: no antenna spike, no thermal test, no coupon, no bench measurement.
Open check: DEV-004 names ESP32-C6-MINI-1 while the ADRs name the ESP32-C3. Not verified which is right.

Correction (same day, later): the C6 question is answered. The PCB spike uses the ESP32-C6-MINI-1 footprint only as a stand-in because the C3 footprint is not in the KiCad library (`docs/verification/reports/spike-pcb-placement-routing.md`, row for U9); the module is the ESP32-C3-MINI-1 (ADR-0002). DEV-004 names the stand-in footprint.
