spoorcc/busy-light/docs/templates/risk.md

### RISK-000 Short title

- **Hazard / failure mode:**
- **Cause:**
- **Effect:**
- **Severity (1-5):**  **Likelihood (1-5):**  **Initial risk:**
- **Mitigated by:** SYS-000, ARCH-000
- **Residual risk (after mitigation):**
- **Verified by:** TC-000
- **Status:** Open | Mitigated | Accepted (justify) | Closed
