spoorcc/busy-light/docs/user/maintenance-and-disposal.md

# Maintenance, Update and Disposal

- **Status:** Draft -- placeholder, content to be written after requirements are approved
- **Applies to:** product revision TBD (hardware / mechanical / firmware)
- **Source requirements:** TBD

> Scope: Cleaning, firmware update (and end-of-support date), repair, recycling.
