spoorcc/busy-light/docs/user/troubleshooting.md

# Troubleshooting

- **Status:** Draft -- placeholder, content to be written after requirements are approved
- **Applies to:** product revision TBD (hardware / mechanical / firmware)
- **Source requirements:** TBD

> Scope: Symptom, cause, action. Link each symptom to the indicator state table.
