spoorcc/busy-light/hw/kicad/spike-gate/board/busy_light_spike.kicad_pcb

## KiCad design hw/kicad/spike-gate/board/busy_light_spike.kicad_pcb (2026-11-09)

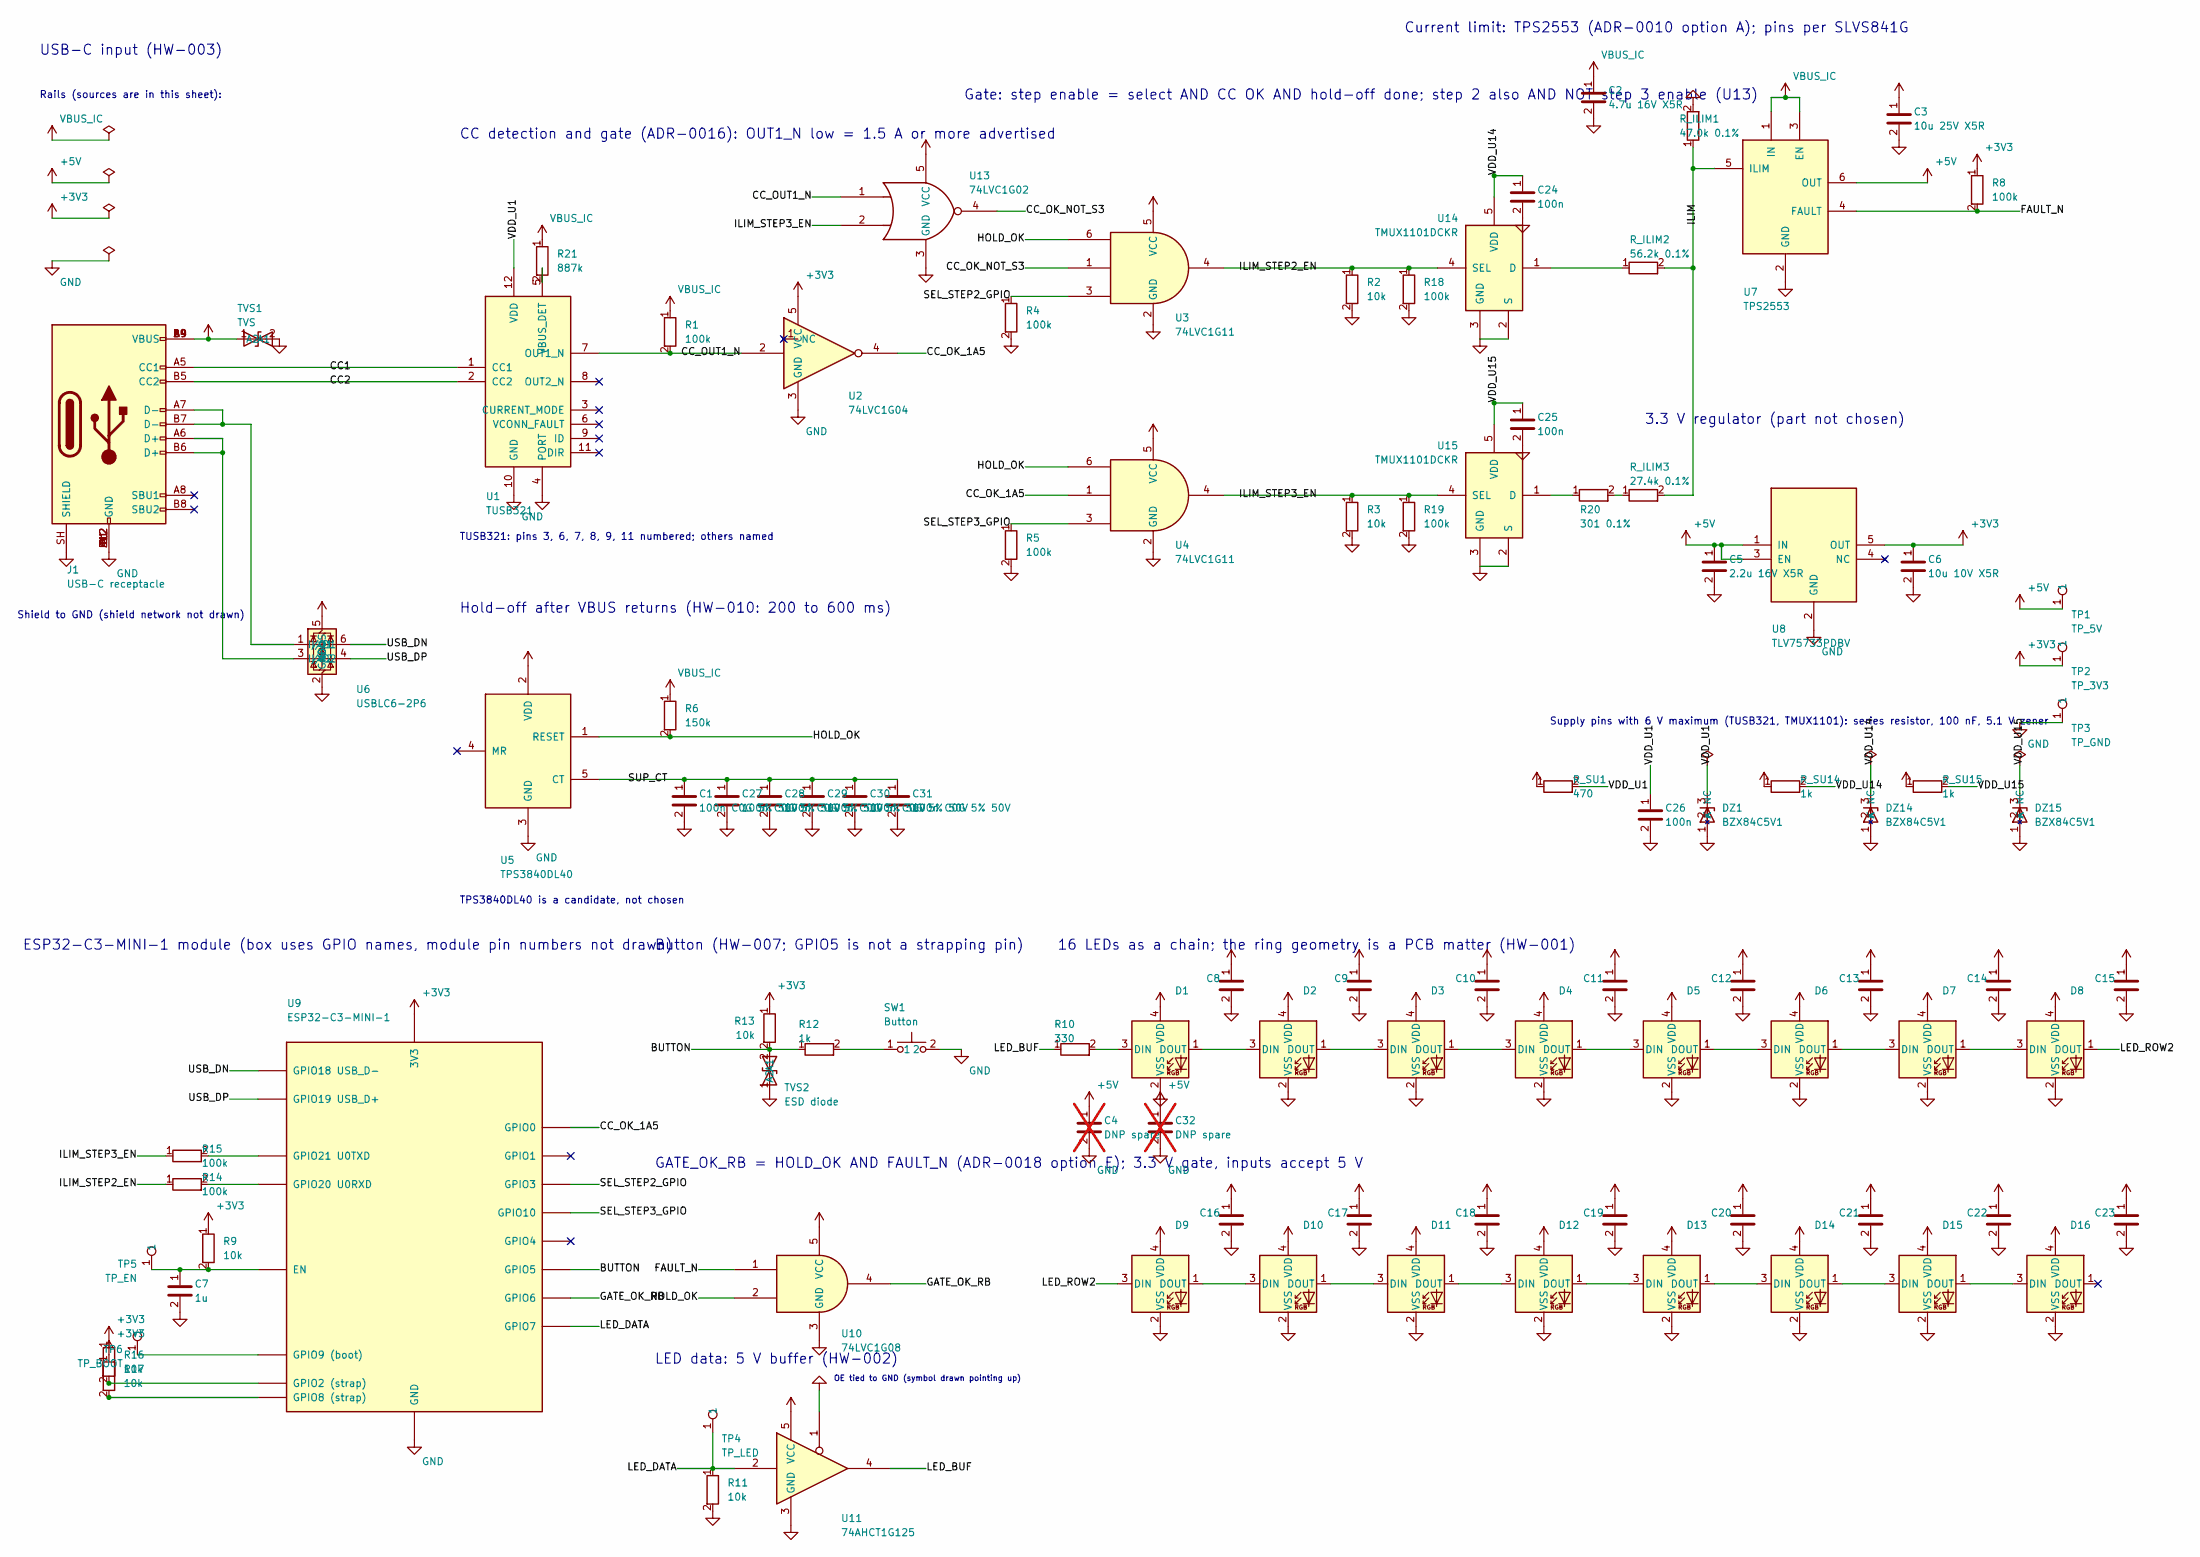
[picture p11: schematic busy_light_spike.kicad_sch, busy-light full board (spike, exploratory)]

Parts:
C1, C27, C28, C29, C30, C31: 100n C0G 5% 50V; C_1206_3216Metric; MPN GRM31C5C1H104JA01L; LCSC C97946
C2: 4.7u 16V X5R; C_0603_1608Metric; MPN CL10A475KO8NNNC; LCSC C19666
C3: 10u 25V X5R; C_0805_2012Metric; MPN CL21A106KAYNNNE; LCSC C15850
C4, C32: DNP spare; C_1206_3216Metric; not fitted
C5: 2.2u 16V X5R; C_0603_1608Metric; MPN CL10A225KO8NNNC; LCSC C23630
C6: 10u 10V X5R; C_0603_1608Metric; MPN CL10A106KP8NNNC; LCSC C19702
C7: 1u; C_0603_1608Metric; MPN CL10A105KB8NNNC; LCSC C15849
C8, C9, C10, C11, C12, C13, C14, C15, C16, C17, C18, C19, C20, C21, C22, C23, C24, C25, C26: 100n; C_0603_1608Metric; MPN CL10B104KB8NNNC; LCSC C1591
D1, D2, D3, D4, D5, D6, D7, D8, D9, D10, D11, D12, D13, D14, D15, D16: WS2812B; LED_WS2812B-2020_PLCC4_2.0x2.0mm; MPN WS2812B-2020; LCSC C965555
DZ1, DZ14, DZ15: BZX84C5V1; SOT-23; MPN BZX84-C5V1,215; LCSC C294621
J1: USB-C receptacle; USB_C_Receptacle_GCT_USB4085_edge
R1, R4, R5, R8, R14, R15, R18, R19: 100k; R_0603_1608Metric; MPN 0603WAF1003T5E; LCSC C25803
R2, R3, R9, R11, R13, R16, R17: 10k; R_0603_1608Metric; MPN 0603WAF1002T5E; LCSC C25804
R6: 150k; R_0603_1608Metric; MPN 0603WAF1503T5E; LCSC C22807
R10: 330; R_0603_1608Metric; MPN 0603WAF3300T5E; LCSC C23138
R12: 1k; R_0603_1608Metric; MPN 0603WAF1001T5E; LCSC C21190
R20: 301 0.1%; R_0603_1608Metric; MPN TD03G3010BT; LCSC C666860
R21: 887k; R_0603_1608Metric; MPN 0603WAF8873T5E; LCSC C23259
R_ILIM1: 47.0k 0.1%; R_0603_1608Metric; MPN TD03G4702BT; LCSC C667109
R_ILIM2: 56.2k 0.1%; R_0603_1608Metric; MPN TD03G5622BT; LCSC C667119
R_ILIM3: 27.4k 0.1%; R_0603_1608Metric; MPN RT0603BRE0727K4L
R_SU1: 470; R_0603_1608Metric; MPN 0603WAF4700T5E; LCSC C23179
R_SU14, R_SU15: 1k; R_0603_1608Metric; MPN 0603WAF1001T5E; LCSC C21190
SW1: Button; SW_SPST_TL3342; MPN TL3342F160QG; LCSC C2886898
TP1: TP_5V; TestPoint_Pad_D1.5mm
TP2: TP_3V3; TestPoint_Pad_D1.5mm
TP3: TP_GND; TestPoint_Pad_D1.5mm
TP4: TP_LED; TestPoint_Pad_D1.5mm
TP5: TP_EN; TestPoint_Pad_D1.5mm
TP6: TP_BOOT; TestPoint_Pad_D1.5mm
TVS1: TVS; D_SOD-323
TVS2: ESD diode; D_SOD-323
U1: TUSB321; X2QFN-12_RWB; MPN TUSB321RWBR; LCSC C139392
U2: 74LVC1G04; SOT-23-5; MPN SN74LVC1G04DBVR; LCSC C7827
U3, U4: 74LVC1G11; SOT-23-6; MPN SN74LVC1G11DBVR
U5: TPS3840DL40; SOT-23-5; MPN TPS3840DL40DBVR
U6: USBLC6-2P6; SOT-666; MPN USBLC6-2P6
U7: TPS2553; SOT-23-6; MPN TPS2553DBVR; LCSC C55266
U8: TLV75733PDBV; SOT-23-5; MPN TLV75733PDBVR; LCSC C485517
U9: ESP32-C3-MINI-1; MPN ESP32-C3-MINI-1-N4; LCSC C2838502
U10: 74LVC1G08; SOT-23-5; MPN SN74LVC1G08DBVR
U11: 74AHCT1G125; SOT-23-5; MPN SN74AHCT1G125DBVR
U13: 74LVC1G02; SOT-23-5; MPN SN74LVC1G02DBVR
U14, U15: TMUX1101DCKR; SOT-353_SC-70-5; MPN TMUX1101DCKR; LCSC C2673506

Connections:
+3V3: C6.1, R8.1, R9.1, R13.1, R16.1, R17.1, TP2.1, U2.5 (VCC), U3.5 (VCC), U4.5 (VCC), U8.5 (OUT), U9.3 (3V3), U10.5 (VCC), U13.5 (VCC)
+5V: C3.1, C4.1, C5.1, C8.1, C9.1, C10.1, C11.1, C12.1, C13.1, C14.1, C15.1, C16.1, C17.1, C18.1, C19.1, C20.1, C21.1, C22.1, C23.1, C32.1, D1.4 (VDD), D2.4 (VDD), D3.4 (VDD), D4.4 (VDD), D5.4 (VDD), D6.4 (VDD), D7.4 (VDD), D8.4 (VDD), D9.4 (VDD), D10.4 (VDD), D11.4 (VDD), D12.4 (VDD), D13.4 (VDD), D14.4 (VDD), D15.4 (VDD), D16.4 (VDD), TP1.1, U7.6 (OUT), U8.1 (IN), U8.3 (EN), U11.5 (VCC)
/BUTTON: R12.1, R13.2, TVS2.2 (A2), U9.19 (GPIO5)
/CC1: J1.A5 (CC1), U1.1 (CC1)
/CC2: J1.B5 (CC2), U1.2 (CC2)
/CC_OK_1A5: U2.4, U4.1, U9.12 (GPIO0)
/CC_OK_NOT_S3: U3.1, U13.4
/CC_OUT1_N: R1.2, U1.7 (OUT1_N), U2.2, U13.1
/FAULT_N: R8.2, U7.4 (FAULT), U10.1
/GATE_OK_RB: U9.20 (GPIO6), U10.4
/HOLD_OK: R6.2, U3.6, U4.6, U5.1 (RESET), U10.2
/ILIM: R_ILIM1.1, R_ILIM2.2, R_ILIM3.2, U7.5 (ILIM)
/ILIM_STEP2_EN: R2.1, R14.1, R18.1, U3.4, U14.4 (SEL)
/ILIM_STEP3_EN: R3.1, R15.1, R19.1, U4.4, U13.2, U15.4 (SEL)
/LED_BUF: R10.1, U11.4
/LED_DATA: R11.1, TP4.1, U9.21 (GPIO7), U11.2
/LED_ROW2: D8.1 (DOUT), D9.3 (DIN)
/SEL_STEP2_GPIO: R4.1, U3.3, U9.6 (GPIO3)
/SEL_STEP3_GPIO: R5.1, U4.3, U9.16 (GPIO10)
/SUP_CT: C1.1, C27.1, C28.1, C29.1, C30.1, C31.1, U5.5 (CT)
/USB_DN: U6.6 (I/O1), U9.26 (GPIO18 USB_D-)
/USB_DP: U6.4 (I/O2), U9.27 (GPIO19 USB_D+)
/VDD_U1: C26.1, DZ1.3 (K), R_SU1.2, U1.12 (VDD)
/VDD_U14: C24.1, DZ14.3 (K), R_SU14.2, U14.5 (VDD)
/VDD_U15: C25.1, DZ15.3 (K), R_SU15.2, U15.5 (VDD)
GND: C1.2, C2.2, C3.2, C4.2, C5.2, C6.2, C7.2, C8.2, C9.2, C10.2, C11.2, C12.2, C13.2, C14.2, C15.2, C16.2, C17.2, C18.2, C19.2, C20.2, C21.2, C22.2, C23.2, C24.2, C25.2, C26.2, C27.2, C28.2, C29.2, C30.2, C31.2, C32.2, D1.2 (VSS), D2.2 (VSS), D3.2 (VSS), D4.2 (VSS), D5.2 (VSS), D6.2 (VSS), D7.2 (VSS), D8.2 (VSS), D9.2 (VSS), D10.2 (VSS), D11.2 (VSS), D12.2 (VSS), D13.2 (VSS), D14.2 (VSS), D15.2 (VSS), D16.2 (VSS), DZ1.1 (A), DZ14.1 (A), DZ15.1 (A), J1.A1 (GND), J1.A12 (GND), J1.B1 (GND), J1.B12 (GND), J1.SH (SHIELD), R2.2, R3.2, R4.2, R5.2, R11.2, R18.2, R19.2, R_ILIM1.2, SW1.2, TP3.1, TVS1.2 (A2), TVS2.1 (A1), U1.4 (PORT), U1.10 (GND), U2.3 (GND), U3.2 (GND), U4.2 (GND), U5.3 (GND), U6.2 (GND), U7.2 (GND), U8.2 (GND), U9.1 (GND), U9.2 (GND), U9.11 (GND), U9.14 (GND), U9.36 (GND), U9.37 (GND), U9.38 (GND), U9.39 (GND), U9.40 (GND), U9.41 (GND), U9.42 (GND), U9.43 (GND), U9.44 (GND), U9.45 (GND), U9.46 (GND), U9.47 (GND), U9.48 (GND), U9.49 (GND), U9.50 (GND), U9.51 (GND), U9.52 (GND), U9.53 (GND), U10.3 (GND), U11.1, U11.3 (GND), U13.3 (GND), U14.2 (S), U14.3 (GND), U15.2 (S), U15.3 (GND)
unnamed: D1.3 (DIN), R10.2
unnamed: D1.1 (DOUT), D2.3 (DIN)
unnamed: D2.1 (DOUT), D3.3 (DIN)
unnamed: D3.1 (DOUT), D4.3 (DIN)
unnamed: D4.1 (DOUT), D5.3 (DIN)
unnamed: D5.1 (DOUT), D6.3 (DIN)
unnamed: D6.1 (DOUT), D7.3 (DIN)
unnamed: D7.1 (DOUT), D8.3 (DIN)
unnamed: D9.1 (DOUT), D10.3 (DIN)
unnamed: D10.1 (DOUT), D11.3 (DIN)
unnamed: D11.1 (DOUT), D12.3 (DIN)
unnamed: D12.1 (DOUT), D13.3 (DIN)
unnamed: D13.1 (DOUT), D14.3 (DIN)
unnamed: D14.1 (DOUT), D15.3 (DIN)
unnamed: D15.1 (DOUT), D16.3 (DIN)
unnamed: J1.A6 (D+), J1.B6 (D+), U6.3 (I/O2)
unnamed: J1.A7 (D-), J1.B7 (D-), U6.1 (I/O1)
unnamed: R12.2, SW1.1
unnamed: R20.2, R_ILIM3.1
unnamed: R21.2, U1.5 (VBUS_DET)
unnamed: C7.1, R9.2, TP5.1, U9.8 (EN)
unnamed: R16.2, U9.5 (GPIO2 (strap))
unnamed: R17.2, U9.22 (GPIO8 (strap))
unnamed: TP6.1, U9.23 (GPIO9 (boot))
unnamed: R14.2, U9.30 (GPIO20 U0RXD)
unnamed: R15.2, U9.31 (GPIO21 U0TXD)
unnamed: R_ILIM2.1, U14.1 (D)
unnamed: R20.1, U15.1 (D)
VBUS_IC: C2.1, J1.A4 (VBUS), J1.A9 (VBUS), J1.B4 (VBUS), J1.B9 (VBUS), R1.1, R6.1, R21.1, R_SU1.1, R_SU14.1, R_SU15.1, TVS1.1 (A1), U5.2 (VDD), U6.5 (VBUS), U7.1 (IN), U7.3 (EN)

Notes on the sheet:
USB-C input (HW-003)
CC detection and gate (ADR-0016): OUT1_N low = 1.5 A or more advertised
Gate: step enable = select AND CC OK AND hold-off done; step 2 also AND NOT step 3 enable (U13)
Hold-off after VBUS returns (HW-010: 200 to 600 ms)
Current limit: TPS2553 (ADR-0010 option A); pins per SLVS841G
3.3 V regulator (part not chosen)
TUSB321: pins 3, 6, 7, 8, 9, 11 numbered; others named
TPS3840DL40 is a candidate, not chosen
ESP32-C3-MINI-1 module (box uses GPIO names, module pin numbers not drawn)
Button (HW-007; GPIO5 is not a strapping pin)
GATE_OK_RB = HOLD_OK AND FAULT_N (ADR-0018 option E); 3.3 V gate, inputs accept 5 V
OE tied to GND (symbol drawn pointing up)
LED data: 5 V buffer (HW-002)
16 LEDs as a chain; the ring geometry is a PCB matter (HW-001)
Rails (sources are in this sheet):
Shield to GND (shield network not drawn)
Supply pins with 6 V maximum (TUSB321, TMUX1101): series resistor, 100 nF, 5.1 V zener

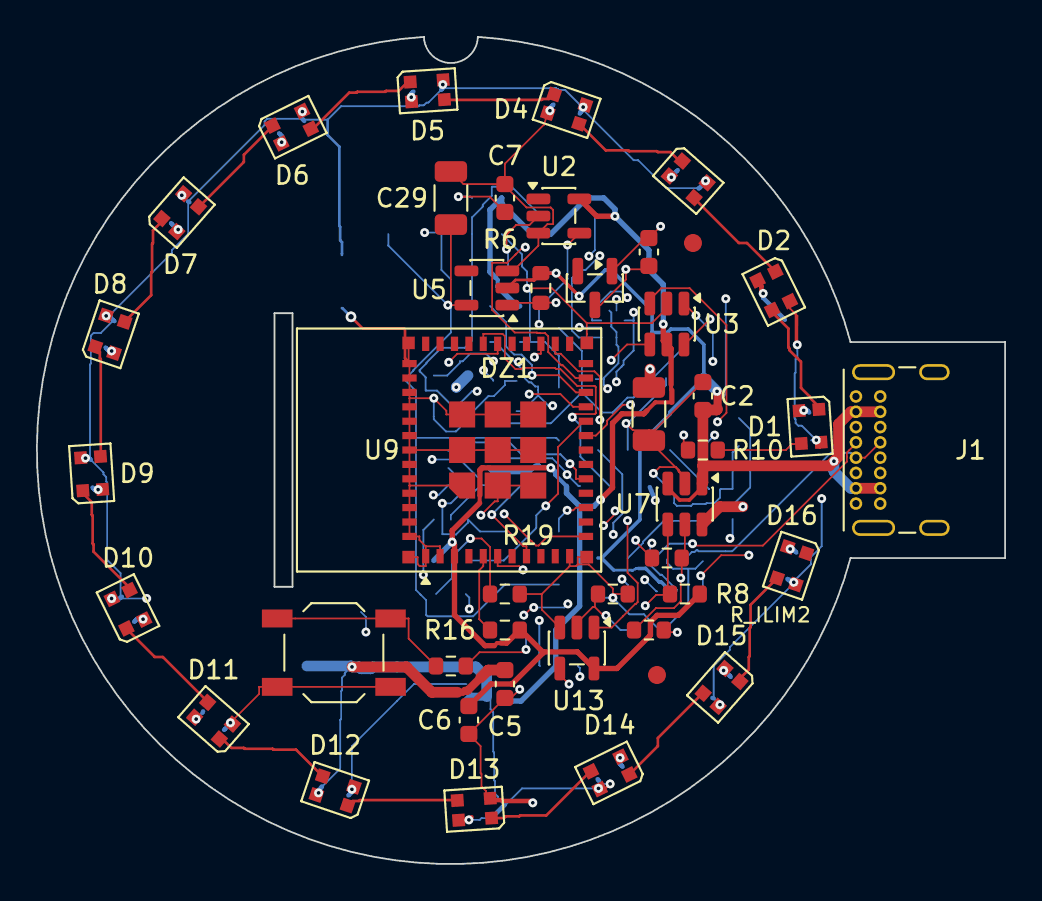
[picture p12: board busy_light_spike.kicad_pcb from above]

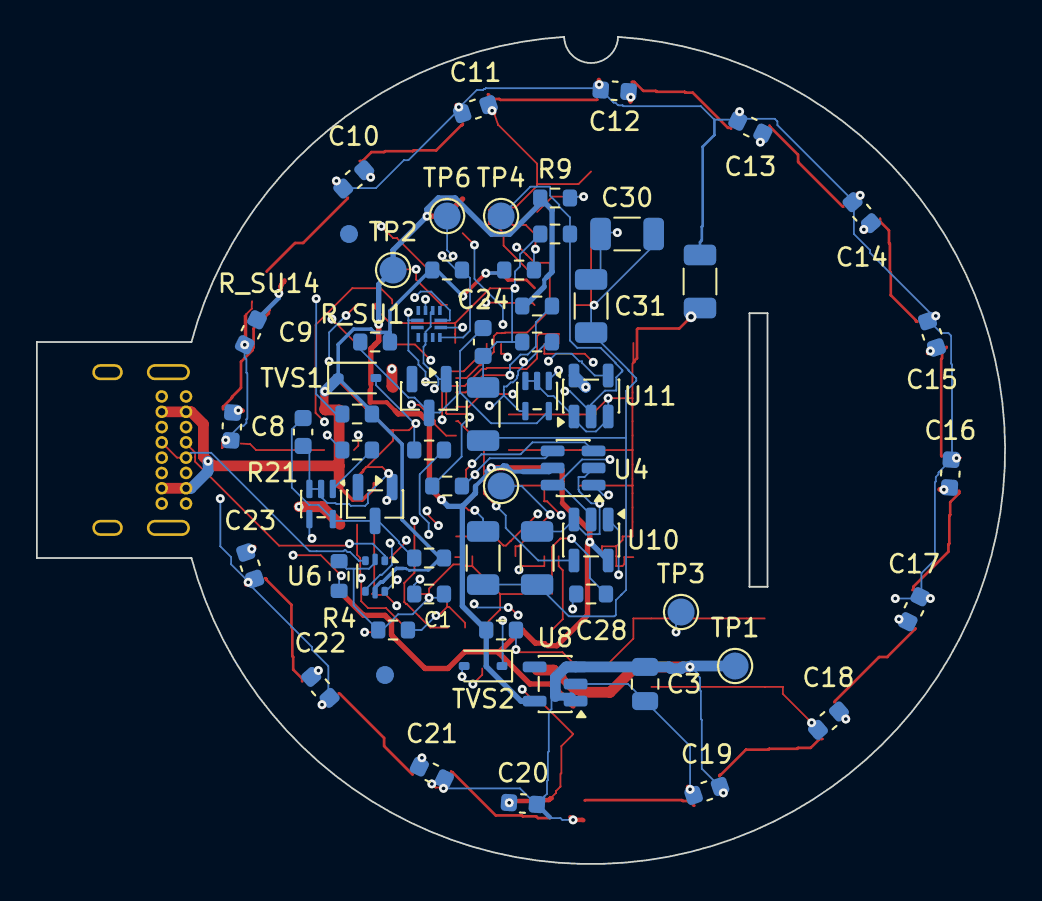
[picture p13: board busy_light_spike.kicad_pcb from below]

Board: 4 copper layers, 53.8 x 45.9 mm, 105 parts (62 on the bottom side), 55 nets.

Other parts of the board:
FID1, FID2, FID4, FID5: Fiducial
