spoorcc/busy-light/hw/kicad/spike-gate/src/pcb_pick.py

# SPDX-License-Identifier: Apache-2.0
"""Pick the best of several routing runs (Freerouting is not deterministic, so runs differ).

Usage: python3 pcb_pick.py <out dir> <run dir> [<run dir> ...]
Each run dir holds a/final.kicad_pcb and a/drc_final.json (written by run_pcb.sh). The score of a run is
(unconnected items, FAIL lines of the strict gate, hard findings, power nets over target, then the tidiness key of pcb_quality.py); the lowest wins, the first listed run on a tie. The files of the
winner are copied to <out dir>/best/ and a table of all runs is printed. Exit 0 when the winner has no unconnected item
and no hard finding, else 1.
"""
from __future__ import annotations

import json
import shutil
import sys
from pathlib import Path

HARD = ("clearance", "track_width", "via_dangling", "hole_clearance", "hole_to_hole", "copper_edge_clearance",
        "shorting_items", "isolated_copper", "min_through_hole", "annular_width", "starved_thermal")
TRACK = ("track_dangling", "track_not_centered_on_via")


def score(drc: dict) -> tuple[int, int, int]:
    """(unconnected items, hard findings, track findings) of one DRC report (kicad-cli JSON)."""
    kinds = [v["type"] for v in drc.get("violations", [])]
    return (len(drc.get("unconnected_items", [])), sum(k in HARD for k in kinds), sum(k in TRACK for k in kinds))


def strict_fails(board: Path, profile: str = "stitched-4l") -> int:
    """Number of FAIL lines of the strict gate (kicad_strict.py drc) for one board; the environment decides the mode."""
    import subprocess
    out = subprocess.run([sys.executable, str(Path(__file__).resolve().parent / "kicad_strict.py"), "drc", str(board), profile],
                         capture_output=True, text=True, check=False)
    return sum(1 for ln in (out.stdout + out.stderr).splitlines() if ln.lstrip().startswith("FAIL"))


def power_fails_from(text: str) -> int:
    """Number of power nets over their drop target in the output of pcb_power_check.py (an infinite drop counts); 99 when unreadable."""
    try:
        d = json.loads(text[text.index("{"):text.rindex("}") + 1])
        return sum(1 for v in d["nets"].values() if not v["within_50mv"])
    except (ValueError, KeyError, TypeError):
        return 99


def power_fails(board: Path) -> int:
    """Power-check failures of one board (pcb_power_check.py); the picker found ring15 run 1 without a +5V path before this existed."""
    import subprocess
    out = subprocess.run([sys.executable, str(Path(__file__).resolve().parent / "pcb_power_check.py"), str(board)],
                         capture_output=True, text=True, check=False)
    n = power_fails_from(out.stdout)
    if n == 99:
        print("power check not measured for %s" % board, file=sys.stderr)
    return n


def pick(runs: list[Path], gate=None, tidy=None, power=None) -> tuple[Path | None, list[tuple[Path, tuple[int, int, int] | None]]]:
    rows = []
    for r in runs:
        f = r / "a" / "drc_final.json"
        sc = score(json.loads(f.read_text(encoding="utf-8"))) if f.exists() and (r / "a" / "final.kicad_pcb").exists() else None
        if sc is not None and gate is not None:                  # the strict gate decides between runs with the same open items
            sc = (sc[0], gate(r / "a" / "final.kicad_pcb"), sc[1])
        if sc is not None and power is not None:                 # a net over the drop target or without a path ranks after the gate
            sc = sc + (power(r / "a" / "final.kicad_pcb"),)
        if sc is not None and tidy is not None:                  # tidiness (pcb_quality.rank_key) breaks the remaining ties
            sc = sc + tuple(tidy(r / "a" / "final.kicad_pcb"))
        rows.append((r, sc))
    ok = [(s, i) for i, (_, s) in enumerate(rows) if s is not None]
    return (rows[min(ok)[1]][0] if ok else None), rows


def tidiness(board: Path) -> tuple:
    """Tie-break key of one board (pcb_quality.rank_key); needs pcbnew, so it is only used from main()."""
    try:
        import pcb_quality
        return pcb_quality.rank_key(pcb_quality.board_metrics(str(board)))
    except Exception as e:                                       # unreadable board: rank it last among equals, say so
        print("tidiness not measured for %s: %s" % (board, str(e)[:80]), file=sys.stderr)
        return (float("inf"),) * 4


def main(argv: list[str]) -> int:
    out, runs = Path(argv[1]), [Path(a) for a in argv[2:]]
    best, rows = pick(runs, gate=strict_fails, tidy=tidiness, power=power_fails)
    for r, s in rows:
        print("%-40s %s" % (r.name, "no result" if s is None else "unconnected %d, strict FAIL %d, hard %d, power FAIL %d" % s[:4] + (", tidy %s" % (s[4:],) if len(s) > 4 else "")))
    if best is None:
        print("no run finished")
        return 1
    dst = out / "best"
    shutil.rmtree(dst, ignore_errors=True)
    dst.mkdir(parents=True)
    for f in (best / "a").glob("final.*"):
        shutil.copy2(f, dst / f.name)
    for f in (best / "a").glob("drc_final.json"):
        shutil.copy2(f, dst / f.name)
    for f in (best / "a").glob("*-lib-table"):                      # fp-lib-table, sym-lib-table: the board needs them to find its libraries
        shutil.copy2(f, dst / f.name)
    for d in (best / "a").glob("*.pretty"):
        shutil.copytree(d, dst / d.name)
    (dst / "chosen_run.txt").write_text(best.name + "\n", encoding="utf-8")
    s = dict(rows)[best]
    print("best:", best.name, "->", dst)
    return 0 if s[0] == 0 and s[1] == 0 and s[2] == 0 else 1


if __name__ == "__main__":
    sys.exit(main(sys.argv))
