spoorcc/busy-light/hw/kicad/spike-gate/src/mech_outline.py

# SPDX-License-Identifier: Apache-2.0
"""Spike: mechanical envelope of the PCB, taken from the FreeCAD spike model (CAD as code).

SPIKE ONLY. The source is a concept spike, not an Approved design: MECH requirements and plan 05 are Draft,
ADR-0011 (housing concept) is the basis, no variant of the USB-C position is chosen (HW-005, ADR-0003 open).
Nothing here is released. Every number below has a source line; where the model uses a placeholder it says so.

Source of every number: branch `spike/mech-concept`, commit deb9a5c,
  file mech/freecad/busy_light_housing.py (parameter block P, variant V1), and
  report docs/verification/reports/mech-spike-model.md (sections 4.1, 5, 6) on the same branch.
The FCStd files in the worktree .claude/worktrees/agent-ac020049007f58faf/mech/ were generated by that script
(V1, V2-posts and V2-pocket results.json agree with the script); the script is the readable source.

Variant choice: V1 (PCB tab at azimuth 0 carries the USB-C receptacle outside the LED ring). Reason: it is the
only variant of the three in the report that passes all 41 checks without breaking SYS-022 (one-side assembly,
report 4.1 "V2 conflicts with the one-side assembly rule SYS-022"). V0 fails (receptacle overlaps the LED ring).
V2-pocket and V2-posts are alternatives: the receptacle is on the PCB underside at azimuth 0, mouth at the
PCB edge, no tab; they need a different outline (plain disc D46) and put J1 on the bottom side.

Coordinates here are mechanical: mm, origin at the housing axis, azimuth 0 = +X, counter-clockwise seen from
above (LED side up). `kicad_xy` converts to KiCad board coordinates (y down), seen from above.
This module has no KiCad dependency, so the tests run with any Python.
"""
import math

# ----------------------------------------------------------------------------- numbers and sources
MECH = {
    # name: (value, source)
    "D_PCB": (46.0, "script P['D_PCB']; report 2: 'D_pcb / t_pcb 46.0 / 1.6'"),
    "T_PCB": (1.6, "script P['T_PCB']"),
    "N_LED": (16, "script P['N_LED']; HW-001 as quoted by the schematic (16 LEDs as a chain)"),
    "D_RING": (40.0, "script P['D_RING'] (LED ring diameter, LED centres)"),
    "LED_PHASE": (3.75, "script P['LED_PHASE']: ASSUMPTION of the mech spike (button at 240 deg in a gap); "
                        "HW-001 gives no phase. LED k is at LED_PHASE + k * 360 / N_LED degrees"),
    "NOTCH_R": (1.5, "script P['NOTCH_R']: poka-yoke notch in the PCB edge, radius"),
    "NOTCH_AZ": (90.0, "script P['NOTCH_AZ']"),
    "POST_AZ": ((30.0, 150.0, 270.0), "script P['POST_AZ'] (DEV from plan 05: off the antenna axis)"),
    "R_POST": (21.0, "script P['R_POST']: post centre radius under the PCB edge"),
    "POST_RAD": (2.0, "script P['POST_RAD']: post radial width (20.0 .. 22.0)"),
    "POST_TANG": (4.0, "script P['POST_TANG']: post and peg tangential width"),
    "HOOK_OVERLAP": (0.6, "script P['HOOK_OVERLAP']: hook lug overlaps the PCB top by 0.6 mm at the edge"),
    "HOOK_T": (0.6, "script P['HOOK_T']: hook lug height above the PCB top"),
    "Z_PCB_BOT": (5.0, "script P['Z_PCB_BOT']: PCB underside above the floor outer face; floor 2.0 mm -> 3.0 mm "
                       "free under the PCB (post height)"),
    "MOD_L": (16.6, "script P['MOD_L']: ESP32-C3-MINI-1 length (datasheet value used by the script)"),
    "MOD_W": (13.2, "script P['MOD_W']"),
    "MOD_H": (2.4, "script P['MOD_H']"),
    "MOD_ANT_L": (4.6, "ESP32-C3-MINI-1 datasheet v2.2 fig 11-1: 16.6 mm module - 11.2 mm pad area - 0.8 mm = 4.6 mm antenna area "
                       "beyond the pad rows (earlier script value 5.4 put the pad row 36 to 48 inside the strip)"),
    "SLOT_W": (1.0, "owner idea 2026-11-07: slot between the antenna end and the LED ring; vendor guide 1.4.7 says cut the "
                    "base board around the antenna; width 1.0 mm = a 1.0 mm router bit (to be checked with the fabricator)"),
    "SLOT_GAP": (1.5, "distance from the antenna end of the module to the slot (assumption of the spike)"),
    "SLOT_OVER": (1.0, "slot extends this far past each long side of the module"),
    "MOD_OFF": (1.0, "script P['MOD_OFF']: module centre offset towards azimuth 0 (report 5)"),
    "MOD_ANT_AZ": (180.0, "script P['MOD_ANT_AZ']: antenna end points to -X"),
    "ANT_KEEPOUT": (15.0, "script P['ANT_KEEPOUT']: vendor recommendation, plan 05 section 4.6"),
    "V1_TAB_W": (12.0, "script P['V1_TAB_W'] (variant V1): PCB tab width"),
    "V1_TAB_R": (29.0, "script P['V1_TAB_R'] (placeholder): PCB tab end radius"),
    "V1_TAB_ROOT": (3.0, "script: tab box starts at R_PCB - 3.0"),
    "V1_USB_R0": (22.5, "script P['V1_USB_R0'] (placeholder): receptacle body start radius"),
    "USB_L": (7.35, "script P['USB_L'] PLACEHOLDER typical mid-mount receptacle length"),
    "USB_W": (8.94, "script P['USB_W'] PLACEHOLDER"),
    "USB_H": (3.26, "script P['USB_H'] PLACEHOLDER"),
    "MAX_DIM_MECH001": (58.0, "script P['MAX_DIM_MECH001'], report 4.1: largest dimension limit"),
    "T_WALL": (1.6, "script P['T_WALL']"),
    "V1_MOUTH_IN": (0.5, "script P['V1_MOUTH_IN']: mouth protrudes 0.5 mm into the window"),
    "BTN_AZ": (240.0, "script P['BTN_AZ']: side-actuated button at the PCB edge"),
    "BTN_BODY_R": (3.5, "script P['BTN_BODY_R'] PLACEHOLDER side-actuated tact body radial depth"),
    "BTN_BODY_T": (4.5, "script P['BTN_BODY_T'] PLACEHOLDER body tangential width"),
    "H_LED": (0.65, "script P['H_LED']"),
    "D_LED": (8.0, "script P['D_LED']: diffuser distance"),
}


def m(name):
    return MECH[name][0]


R_PCB = m("D_PCB") / 2.0
R_RING = m("D_RING") / 2.0
N_LED = m("N_LED")
USB_MOUTH_R = m("V1_USB_R0") + m("USB_L")                  # 29.85, report 4.1: "R 22.5 to 29.85"
R_OUT = 26.5                                               # script P['D_OUT'] / 2 (D_OUT 53.0)


def largest_dim_mm(mouth_r):
    """Housing largest dimension in V1 for a receptacle mouth at radius mouth_r: end wall outer face plus R_OUT.
    The script gives 57.43 mm for mouth 29.85 (report 4.1); the limit is MAX_DIM_MECH001 = 58 mm."""
    return (mouth_r - m("V1_MOUTH_IN") + m("T_WALL")) + R_OUT


MAX_DIM_SPIKE_MM = 59.8      # plan 06 D2: the housing size of the earlier spike result; the board must not exceed it
LED_SIZE_MM = 2.0            # WS2812B-2020 stand-in (LED_WS2812B-2020_PLCC4_2.0x2.0mm), vendor drawing not checked


def check_largest_dim(mouth_r):
    """Raise ValueError when the housing for a receptacle mouth at mouth_r is larger than MAX_DIM_SPIKE_MM."""
    d = largest_dim_mm(mouth_r)
    if d > MAX_DIM_SPIKE_MM:
        raise ValueError("largest dimension %.2f mm exceeds %.1f mm" % (d, MAX_DIM_SPIKE_MM))
    return d


def kicad_xy(mx, my, cx, cy):
    """Mechanical (x right, y up, seen from above) to KiCad board coordinates (y down)."""
    return cx + mx, cy - my


def polar(r, az_deg):
    a = math.radians(az_deg)
    return r * math.cos(a), r * math.sin(a)


def led_azimuths():
    return [m("LED_PHASE") + k * 360.0 / N_LED for k in range(N_LED)]


def led_rotation_deg(az):
    """KiCad footprint rotation for a WS2812B PLCC4 (5x5 or the 2020 stand-in; same pad order) so that the footprint x axis points along the clockwise
    tangent (seen from above). Then pins 3 (GND) and 4 (DIN) face the previous LED and pins 1 (VDD) and
    2 (DOUT) face the next one, so DOUT(k) meets DIN(k+1) across the gap."""
    return (az - 90.0) % 360.0


def led_cap_shift_mm(k, az):
    """Tangential shift of the bypass cap on the underside so it clears the base posts (mech: post box
    R 20..22, 4 mm tangential, at the POST_AZ azimuths). Positive = counter-clockwise."""
    for pa in m("POST_AZ"):
        d = (az - pa + 180.0) % 360.0 - 180.0           # signed azimuth distance in degrees
        if abs(d) < 8.0:
            return (2.5 if d > 0 else -2.5)
    return 0.0


def tab_half_intersection():
    """Tab half width and the x where the tab sides meet the PCB circle."""
    hw = m("V1_TAB_W") / 2.0
    return hw, math.sqrt(R_PCB ** 2 - hw ** 2)


def outline_segments(tab_r=None):
    """Edge.Cuts outline as a list of ('arc', start, mid, end) / ('line', start, end) in mechanical mm,
    counter-clockwise from the upper tab junction. Circle R_PCB, tab of width V1_TAB_W to V1_TAB_R, notch."""
    hw, xj = tab_half_intersection()
    b = math.degrees(math.asin(hw / R_PCB))                  # tab junction azimuth
    nr, naz = m("NOTCH_R"), m("NOTCH_AZ")
    ncx, ncy = polar(R_PCB, naz)
    # notch circle (centre on the PCB edge at NOTCH_AZ, radius NOTCH_R) meets the PCB circle at +-d around naz
    d = math.degrees(math.acos(1.0 - nr ** 2 / (2.0 * R_PCB ** 2)))
    a1, a2 = naz - d, naz + d
    seg = []
    seg.append(("arc", polar(R_PCB, b), polar(R_PCB, (b + a1) / 2), polar(R_PCB, a1)))
    inward = polar(R_PCB - nr, naz)
    seg.append(("arc", polar(R_PCB, a1), inward, polar(R_PCB, a2)))
    seg.append(("arc", polar(R_PCB, a2), polar(R_PCB, (a2 + 360.0 - b) / 2), polar(R_PCB, 360.0 - b)))
    tr = m("V1_TAB_R") if tab_r is None else tab_r
    seg.append(("line", polar(R_PCB, 360.0 - b), (tr, -hw)))
    seg.append(("line", (tr, -hw), (tr, hw)))
    seg.append(("line", (tr, hw), polar(R_PCB, b)))
    return seg


def slot_rect():
    """Slot in the PCB beside the antenna end (x0, y0, x1, y1), mechanical mm: SLOT_GAP beyond the module end at -X."""
    mx0, my0, _, my1 = module_rect()
    xr = mx0 - m("SLOT_GAP")
    return (xr - m("SLOT_W"), my0 - m("SLOT_OVER"), xr, my1 + m("SLOT_OVER"))


def slot_segments():
    """Edge.Cuts lines of the slot, as ('line', start, end) like outline_segments."""
    x0, y0, x1, y1 = slot_rect()
    c = [(x0, y0), (x1, y0), (x1, y1), (x0, y1)]
    return [("line", c[i], c[(i + 1) % 4]) for i in range(4)]


def in_slot(x, y, margin=0.0):
    """Point within `margin` of the slot (or inside it)."""
    x0, y0, x1, y1 = slot_rect()
    return x0 - margin < x < x1 + margin and y0 - margin < y < y1 + margin


def inside_pcb(x, y, margin=0.0, tab_r=None):
    """Point inside the PCB (circle or tab), at least `margin` from the edge and from the slot (notch ignored, it is 1.5 mm)."""
    if in_slot(x, y, margin):
        return False
    hw = m("V1_TAB_W") / 2.0
    if math.hypot(x, y) <= R_PCB - margin:
        return True
    tr = m("V1_TAB_R") if tab_r is None else tab_r
    return (R_PCB - m("V1_TAB_ROOT") <= x <= tr - margin) and abs(y) <= hw - margin


def hook_keepouts():
    """Top-side footprint keep-out under the three hook lugs: rectangles in polar frame (r0, r1, half
    tangential width) at the POST_AZ azimuths. Hook lug: R_PCB - HOOK_OVERLAP .. R_PCB + peg, 4 mm wide."""
    r0 = R_PCB - m("HOOK_OVERLAP")
    return [(az, r0, R_PCB + 0.5, m("POST_TANG") / 2.0) for az in m("POST_AZ")]


def post_keepouts():
    """Bottom-side keep-out (the base posts under the PCB edge): (az, r0, r1, half tangential width)."""
    rp, w = m("R_POST"), m("POST_RAD") / 2.0
    return [(az, rp - w, rp + w, m("POST_TANG") / 2.0) for az in m("POST_AZ")]


def module_rect():
    """Module body on the top side: (x0, y0, x1, y1) mm mechanical, long axis along X, antenna end at -X."""
    off, L, W = m("MOD_OFF"), m("MOD_L"), m("MOD_W")
    return (-L / 2 + off, -W / 2, L / 2 + off, W / 2)


def antenna_strip():
    """Antenna strip of the module (x0, y0, x1, y1): the part of the board under it must have no copper."""
    x0, y0, x1, y1 = module_rect()
    return (x0, y0, x0 + m("MOD_ANT_L"), y1)


def vendor_keepout_rect():
    """Vendor recommendation: ANT_KEEPOUT mm beyond the module end in the antenna direction (not met, see report)."""
    x0, y0, x1, y1 = module_rect()
    return (x0 - m("ANT_KEEPOUT"), y0, x0, y1)


def region_rect_ok(side, x0, y0, x1, y1, r_move=16.6, tab_r=None):
    """Region where movable parts may sit, mechanical coordinates. Top (F): inside r_move and outside the module.
    Bottom (B): inside r_move, or on the tab behind the LED ring. Never in the antenna strip."""
    pts = [(x0, y0), (x0, y1), (x1, y0), (x1, y1)]
    ax0, ay0, ax1, ay1 = antenna_strip()
    if x1 > ax0 - 0.3 and x0 < ax1 + 0.3 and y1 > ay0 - 0.3 and y0 < ay1 + 0.3:
        return False
    sx0, sy0, sx1, sy1 = slot_rect()
    if x1 > sx0 - 0.6 and x0 < sx1 + 0.6 and y1 > sy0 - 0.6 and y0 < sy1 + 0.6:       # slot and 0.6 mm to copper
        return False
    if side == "F":
        mx0, my0, mx1, my1 = module_rect()
        if x1 > mx0 - 0.3 and x0 < mx1 + 0.3 and y1 > my0 - 0.3 and y0 < my1 + 0.3:
            return False
        return all(math.hypot(px, py) <= r_move for px, py in pts)
    hw = m("V1_TAB_W") / 2.0 - 0.7
    tr = m("V1_TAB_R") if tab_r is None else tab_r
    on_tab = x0 >= 22.9 and x1 <= tr - 0.7 and y0 >= -hw and y1 <= hw
    return on_tab or all(math.hypot(px, py) <= r_move for px, py in pts)
