spoorcc/busy-light/(commit log)

2026-11-03 docs: add stakeholder needs and draft system requirements (NEED-001..019, SYS-001..031)
    First release scope: Jenkins status pushed to the device and polled from
    a REST API, 16 RGB LED ring, Wi-Fi AP provisioning with web UI, OTA update,
    user-uploaded CA certificates, per-unit AP password, 3D printed housing
    of about 53 mm, EUR 10-20 per assembled PCB for a first order of 10.
    All documents are Draft; unconfirmed values are marked as assumptions.
    Claude-Session: https://claude.ai/code/session_01NnNc9E5Wb3NddyycCpVkr5
2026-11-03 chore: set up project structure, process, standards and tooling
    Directory layout for Zephyr software (sw/), KiCad hardware (hw/) and
    FreeCAD mechanics (mech/), with a regulated-company style process:
    V-model lifecycle with gates, Elephant-Goldfish planning, ADR and
    requirement templates, traceability and docs-style checks, diagrams
    as code, coding (CERT C / MISRA subset), hardware and mechanical DFx
    standards, ASD-STE100 based writing standard, regulatory (CE) scaffolding
    and the technical-file index, user documentation skeleton, and Claude
    skills and project instructions.
    Claude-Session: https://claude.ai/code/session_01NnNc9E5Wb3Nd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
2026-11-03 docs: add system design plan 02, ADR-0002 (ESP32-C3 proposed) and SYS-032..037
    Record owner rounds 2-7: shared networks, level mode, LAN TLS, own
    certificate, WPA2-Enterprise headroom, PC simulation, volume 1000/yr,
    platform ESP32-C3 with upstream-driver fallback. Add test case stubs
    TC-032..037, block diagram, changelog and process/template updates.
    Refs: SYS-021, SYS-032..SYS-037, NEED-009, ADR-0002
    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
2026-11-03 docs: ADR-0003..0008, goldfish review RV-001, risks, ARCH blocks, SYS-038..046, SW-001..004
    Draft ADR-0003 (antenna), 0004 (LED drive), 0005 (mapping), 0006 (provisioning),
    0007 (update and staged secure boot, Proposed), 0008 (transport). Add RV-001 with
    comprehension, antagonistic and readiness passes (readiness verdict NO-GO),
    risk register RISK-001..022, ARCH-001..019, regulatory first assessment,
    key-management draft, SYS-038..046, SW-001..004 and test case stubs.
    All documents are Draft/Proposed; nothing is Approved.
    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
2026-11-03 docs: add draft HW-001..009 and MECH-001..006 with test case stubs
    Hardware and mechanical requirements derived from SYS-001, 017, 020, 022, 023,
    028, 038 and ADR-0003, ADR-0004. All Draft; bracketed values are proposals.
    No CAD files changed.
    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
2026-11-03 docs: add draft plan 03 for spike 7.1 (Zephyr on ESP32-C3)
    Thirteen experiments with pass rules and fallbacks for flash fit, heap, AP+STA,
    TLS, MCUboot, power cuts and secure boot on sacrificial kits. Feeds ADR-0002,
    0004..0008 and SYS-012, 026, 027, 029, 034, 036, 043, 046. Draft; no code.
    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
2026-11-03 docs: review plan 03 (RV-002) and revise spike 7.1 plan
    Add goldfish review record RV-002. Plan 03 gains a desk survey E0, split
    E2 and E11 (E11a/b/c), power experiment E14, kit accounting, secrets and
    evidence rules, entry condition (owner approval before purchase).
    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
2026-11-03 docs: spike 7.1 E0 desk survey; pin Zephyr v4.5.0
    Add the E0 survey report (documentation pass and v4.5.0 source pass),
    move the west pin from v4.2.0 to v4.5.0 (owner approval), update plan 03
    assumption A2, risk-009 note and changelog.
    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
2026-11-03 docs: apply E0 findings to ADR-0004/0006/0007/0008; record release-key decision
    Owner decision: a lost or leaked release key means a recall of locked units
    (no second key in the Espressif MCUboot port). Apply desk-survey results:
    SPI LED route, radio-first rule for key and passphrase creation, PSA key
    handling, one-client access point, RSA-3072 secure-boot vs EC256 release key,
    write-block-size and swap-mode checks. Add E0 Pass 3. ADRs stay Proposed.
    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
2026-11-03 docs: record spike 7.1 E1 build results (hello_world, Wi-Fi shell)
    Build-only record for esp32c3_devkitm with Zephyr v4.5.0 and SDK 1.0.1:
    image sizes, default 4 MB flash layout, default RSA-2048 sample key and
    swap-using-offset noted. Nothing flashed or run.
    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
2026-11-03 docs: E11a partial record; chip revision >= v0.3 and virtual eFuse notes
    ECDSA P-256 sysbuild works (bootloader 5 KB smaller than RSA-2048). Record
    that secure boot needs ESP32-C3 rev >= v0.3 (HW-008, ADR-0007), that Zephyr
    v4.5.0 has virtual eFuses for rehearsal (ADR-0007, RISK-022), and that the
    official flash-encryption sample covers the classic ESP32 only.
    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
2026-11-03 docs: add spike 7.1 E2a paper flash budget
    Arithmetic from the E1 devicetree layout: break-even image about 1.31 MiB
    (75 % of a 1792 KiB slot), 1.38 MiB with unused areas reclaimed. Image
    sizes in the scenarios are estimates, not measurements.
    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
2026-11-03 docs: record E11a finding in ADR-0007; add RISK-023
    Zephyr v4.5.0 sysbuild MCUboot has no secure boot v2 or flash encryption
    options on the C3; they exist only in the standalone Espressif port with an
    ESP-IDF HAL 6.0.x. Owner decision pending; stage 1 unaffected.
    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
2026-11-03 docs: add spike 7.1 E2b size ladder; update RISK-008 and RISK-010
    Throw-away image with Wi-Fi AP+STA, HTTPS server and client, JSON, DHCP
    server, SPI LED, settings and PSA key: 792 KB signed (43 % of the default
    slot), static RAM 285 KB of 360 KB. Build only; lower bound.
    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
2026-11-03 docs: add spike 7.5 paper power budget; add USB current decision to guide
    At the 500 mA limit the ESP32-C3-MINI-1 TX peak (350 mA at 3.3 V) leaves
    46 mA (LDO) to 148 mA (buck at 85 %) for 16 LEDs, i.e. 5 to 58 % of full
    white depending on LED type. Several inputs not found; marked in the report.
    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
2026-11-03 docs: add ADR-0005 extractor prototype record; clarify SW-001 limits
    PC-only prototype (scratchpad): 27 tests, 5 M fuzz executions with no crash
    or hang, 4057 B text and 512 B stack on rv32imc. Add document nesting limit
    and number wording to SW-001 and ADR-0005; new owner question in the guide.
    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
2026-11-03 docs: add ADR-0004 limiter prototype record
    PC-only prototype (scratchpad): integer limiter, 31.7 M grid and 10 M random
    frames without failure, 532 B text and 48 B stack on rv32imc. Note the level
    mode fixed-scale and below-dark-current proposals in ADR-0004.
    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
2026-11-03 docs: allow higher USB current when the source advertises it (SYS-020, HW-003)
    Owner decision: default [500] mA; up to the advertised value (at most
    [1500] mA) read from the USB-C CC lines, with [500] mA fallback. Update
    SYS-020, HW-003, ADR-0004 context, RISK-003 and the owner guide. Draft.
    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
2026-11-03 docs: add power budget addendum for higher USB limits
    With a source advertising 1.5 A the limiter never dims for the three LED
    types; the default 500 mA case still sets the minimum. SYS-001 rationale
    notes the two operating points.
    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
2026-11-03 docs: add ADR-0009 (USB-C power input and CC detection), RISK-024..026
    Proposed ADR comparing ADC read of CC, CC detection IC, PD sink, comparators
    and fixed 500 mA (A 136, B 127, D 115, C 88; E excluded). Recommendation: A
    with B as fallback; spike decides. Many inputs marked not found.
    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
2026-11-03 docs: record ADC read and hardware current limit (ADR-0009, HW-010)
    Owner input: read USB-C CC lines with the ADC; add a hardware current limit
    that starts at [500] mA and is raised by firmware after the CC read. Draft
    HW-010 and TC-210; ADR-0004 item 4 and RISK-025 updated. ADRs stay Proposed.
    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
2026-11-03 docs: add ADR-0010 (USB input hardware current limit)
    Proposed ADR with 26 sourced evidence rows and six options. Recommendation:
    TPS2553 (auto-retry) with a firmware-switched limit resistor (163 of 190);
    tolerance wider than the [10] % margin noted. Owner guide updated.
    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
2026-11-04 docs: add mechanical plan 05, ADR-0011 and concept analysis
    Concept B (opaque base + translucent lid), FDM without PLA; dimension
    proposal 55 x 28 mm, PCB 44 mm, ring 40 mm. Thermal, tolerance and light
    estimates marked as rough. Open conflicts and 13 owner questions listed.
    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
2026-11-04 docs: resolve the three mechanical conflicts (label, antenna, PCB size)
    Unit lies flat (assumption): label on the underside, D_out 53 mm, PCB 46 mm,
    H about 16.5 mm; MECH-003 limited to housing-controlled plastic-only box;
    ADR-0003 finding on cut-outs and the LED distance. Thermal re-estimate:
    PETG fails 2.5 W at 35 C, ASA passes. Remaining misfits listed in plan 05.
    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
2026-11-04 docs: add RISK-031 (USB-C receptacle vs LED ring) and owner decision 15
    The FreeCAD spike model found a 2.6 mm3 overlap: the 8.94 mm receptacle does
    not fit between LEDs of a 40 mm, 16-LED ring (pitch 7.85 mm). Options in the
    owner guide; variants being modelled on spike/mech-concept.
    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
2026-11-04 docs: record FreeCAD spike variant results in the guide and RISK-031
    V1 (board tab and wall bulge) passes all checks at 57.43 mm; V2 passes with
    a floor pocket or taller posts but breaks one-side assembly. Placeholders;
    nothing printed or fitted. Spike branch stays unmerged.
    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
2026-11-04 ci: add CI workflow, tool environment and ADR-0012 (hardware design flow, Proposed)
    Adds docs, python-tools, hardware, mechanical and software jobs with local
    scripts (ci_hw.sh, ci_mech.sh, ci_sw.sh), pyproject.toml, regression tests
    for check_docs_style.py, and ADR-0012 pinned to KiCad 10.0.6.
    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
2026-11-04 docs: update ADR-0012 with KiCad spike evidence; add spike report (Draft)
    Replaces byte-identical regeneration by semantic equality, adds a schematic
    and routing spike as a condition before generation.
    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
2026-11-04 docs: record G1 work (scripted routing, parity, rules, peg/LED conflict) in report and ADR-0012
    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
2026-11-04 docs: record widened dump, regeneration gate and pcbnew deprecation in report and ADR-0012
    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
2026-11-04 docs: IPC API evaluation (spike report section 10) and pcbnew adapter item in ADR-0012
    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
2026-11-04 docs: kiutils board builder results (report section 11) and ADR-0012 item 12
    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
2026-11-04 docs: gate failure path and CI wiring status (spike report section 12)
    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
2026-11-04 docs: ADR-0014 back mounting interface (Proposed); record orientation decisions (NEED-014, MECH-003, RV-004 A1)
    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
2026-11-04 docs: draft requirements for orientation, mounting and label on the back (NEED-020..022, SYS-047, HW-011, MECH-006..008)
    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
2026-11-04 ci: pin PlantUML 1.2026.8 by SHA-256 and use the built-in layout for the block diagram
    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
2026-11-04 docs: README gallery with block diagram, stand-in board render and housing concept preview
    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
2026-11-04 docs: draft SW-005..SW-008 for USB current step handling, test stubs TC-105..108
    Closes the RV-008 action to write the software requirement (RV-006 S3..S6).
    Traces to SYS-020, SYS-029, ADR-0016.
    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
2026-11-04 spike: ADR-0016 gate fragment from code, KiCad ERC, parity check, truth-table test (exploratory)
    Traces to ADR-0016, HW-003, HW-010, RV-008 H5.
    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
2026-11-04 spike: ngspice power-up scenarios for the ADR-0016 gate (behavioural, assumed IC glitch)
    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
2026-11-04 spike: hold-off scenarios D to G in the ngspice power-up check
    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
2026-11-04 spike: hold-off tolerance arithmetic and finding F7
    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
    [holdoff_tolerance.py]
2026-11-04 docs: rename G1 re-run report so the traceability check does not read it as an ADR
    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
2026-11-04 docs: fix title of the G1 re-run report (traceability ID clash)
    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
2026-11-04 spike: gate fragment v2 (IC on VBUS, hold-off timer, 3-input AND); writer does not finish (HW-010, HW-003, ADR-0016)
    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
2026-11-04 spike: deterministic own KiCad schematic writer for the gate fragment (ADR-0012, ADR-0016, HW-010)
    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
2026-11-04 spike: gate v3 (supervisor hold-off restarts after VBUS dip, one ILIM net, 6-pin footprint), failing-safe power-up script, goldfish and datasheet reports (HW-010, HW-003, ADR-0016)
    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
    [gen_gate.py, holdoff_tolerance.py, test_gate_logic.py]
2026-11-04 spike: gate v3b (TPS3840 pin order, current writer fixture, power-order model, scenarios L and M), second goldfish review (HW-010, RISK-044)
    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
    [gen_gate.py, test_gate_logic.py]
2026-11-04 spike: hand-laid-out schematic writer (wires, signal flow, captions), run_layout.sh, tests (ADR-0012, HW-010)
    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
2026-11-04 spike: full-board schematic (USB-C, CC IC, gate, TPS2553, regulator, ESP32-C3, button, 16 LEDs, test points), intent check, report (ADR-0012, HW-001, HW-002, HW-003, HW-006, HW-007, HW-010)
    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
2026-11-04 docs: drop UART test points, assign GPIO20/21 to gate-enable readbacks in HW-010 proposal (HW-006, HW-010, SW-009)
    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
2026-11-04 spike: GPIO20/21 read the gate enables, UART test points dropped (HW-006, HW-010)
    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
2026-11-04 spike: pull up GPIO2/GPIO8, connection-based 5 V test, report corrected, goldfish review recorded (HW-006, HW-007, HW-010)
    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
    [layout_full.py, test_layout_full.py]
2026-11-04 spike: TUSB321 symbol matches the datasheet pinout, invented ADR pin removed (ADR-0016, HW-010)
    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
2026-11-05 spike report: M1 USBLC6 pin map verified, back-feed path described, size open (ADR-0016, HW-010)
    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
2026-11-05 spike report: M1 D+ pull-up facts from ESP32-C3 TRM v1.4 (ADR-0016, HW-010)
    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
2026-11-05 docs: spike report examines CC_OK validity without VBUS and the console/ROM print on GPIO20/21 (HW-010, SW-009, ADR-0016)
    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
2026-11-05 docs: datasheet evidence for TPS2553, 74LVC1G125, 74AHCT1G125; U7/U10/U11 pin test, caption fix (HW-010, ADR-0016)
    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
    [layout_full.py, test_layout_full.py]
2026-11-05 docs: second goldfish review of the full-board schematic spike (HW-010, SW-009, ADR-0016)
    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
2026-11-05 docs: untrack ERC/log output, fix stale report counts and caption, add merge note (review N3, N5, N6)
    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
    [layout_full.py]
2026-11-05 docs: HW-010 proposal names the spike readback resistor values as proposed (HW-010, SW-009)
    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
2026-11-05 docs: N4 analysis of the TPS3840 CT capacitor; no single 620 nF C0G part found, parallel C0G sets fit on paper (HW-003, HW-010)
    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
2026-11-05 docs: ILIM select switch candidates, TMUX1101 recommended pending rail check (HW-010, ADR-0016)
    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
2026-11-05 spike: hold-off capacitor drawn as 470n + 150n C0G in parallel (HW-010, HW-003, ADR-0016)
    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
2026-11-05 spike: placed and routed PCB of the full board by script, grid router fallback, DRC and parity results (HW-010, HW-003, ADR-0016, ADR-0012)
    Freerouting was not run (download refused by the permission layer). 3 connections unrouted, 4 clearance errors, DRC not clean. Spike only; nothing approved.
    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
    [pcb_check.py, pcb_dsn.py, pcb_full.py, pcb_rules.py, route_grid.py, test_pcb_full.py]
2026-11-05 spike: PCB outline from the FreeCAD spike (V1), annealing placer, Freerouting v2.5.0 runs, 2 against 4 layers, plane vias (HW-010, HW-003, ADR-0016, ADR-0012)
    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
2026-11-05 feat(hw): part-evidence schema, checker and first evidence files for the gate chain (HW-010, ADR-0016)
    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
2026-11-05 feat(hw): evidence for TPS3840, 2N7002, USBLC6, ESP32-C3-MINI-1 and pin aliases (HW-010)
    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
2026-11-05 spike: ERC and DRC fail on any finding not on the visible waiver list (HW-010, ADR-0012)
    kicad_strict.py runs kicad-cli with --severity-all --exit-code-violations, no tail masking; known-open-violations.json records the counts of 2026-11-05.
    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
    [kicad_strict.py, test_kicad_strict.py]
2026-11-05 docs: README shows spike full-board schematic and 4-layer board, with honest captions (ADR-0012, HW-010)
    Images are kicad-cli exports made by hw/kicad/spike-gate/render_readme_images.sh.
    Captions state the DRC result of that run (252 violations, 57 unconnected items) and that nothing is approved.
    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
2026-11-05 docs: README schematic as two legible crops; state both routing numbers (40 unrouted, 57 after stitching) (HW-010, ADR-0012)
    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
2026-11-05 docs: desk reports on ILIM switch, stock, Zephyr console and GPIO pulls, SW-005 hold-off timing (HW-010, SW-005, SW-009, SYS-020, ADR-0016)
    Draft reports only. Nothing measured, built or approved; stock figures come from a
    parts mirror and are unconfirmed. Open: TMUX1101 3V3-off condition, SYS-020 1 s not met.
    Claude-Session: https://claude.ai/code/session_01NnNc9CXaSMwmsPGCK65UHv
2026-11-05 spike: G1 geometry for the clean-route plan, plan 06 and RV-009 (work in progress) (HW-001, HW-003, HW-005, HW-010, ADR-0016, ADR-0012)
    Adds the 2020 LED stand-in, largest-dimension check, placement accept rules, T1/T2/T3/T12
    and G0 DRC fixtures. Unit tests: test_pcb_full 22 OK (observed). Strict placed DRC fails:
    29 footprint_symbol_mismatch against a cap of 13 (all stand-in refs). Not done: T13 and
    OVERLAP_PEN_FLOOR, run_pcb.sh changes, routing (no Freerouting jar in the run), G2 onward.
    Spike only; nothing Approved by this commit.
    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
    [mech_outline.py, pcb_full.py, pcb_place.py, test_pcb_full.py]
2026-11-05 docs: record owner decisions of 2026-11-05 (b) as Proposed amendments (SYS-020, HW-010, SW-005, SW-006, SW-007, SW-009, ADR-0016)
    SYS-020 [2] s, TMUX1101 ILIM switches with DEV-001 and RISK-045, ILIM
    resistor values, hold-off capacitor set, SW amendments P1-P6, TC-105/109/210
    outlines. Nothing set to Approved or Accepted.
    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
2026-11-05 spike: G1 remainder, placement overlap floor, per-ref DRC allow-list, M3 exit code (HW-001, HW-010, ADR-0012)
    T13 and OVERLAP_PEN_FLOOR = 2000.0 in pcb_place.py (SA_SEEDS widened to 16: with the floor
    seed 12 is the first that meets LAYOUT_RULES). kicad_strict.py checks refs per class and reads
    strict_allow; footprint_symbol_mismatch cap 29 for the stand-in refs only (DEV-001, proposed,
    not approved); run_pcb.sh no longer swallows a pad-net comparison failure.
    Observed: placed 4-layer DRC with the allow-list exits 0 (241 unconnected, 12+1 on U9).
    Not done: T5 (jar check is G3), routing. Spike only; nothing Approved.
    Claude-Session: h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
    [kicad_strict.py, pcb_full.py, pcb_place.py, test_kicad_strict.py, test_pcb_place.py]
2026-11-05 spike: TMUX1101 ILIM switches, 0.1 % ILIM resistors, 220+220+100+68 nF hold-off set, analysis re-run (HW-010, SW-009, ADR-0016)
    Owner decisions of 2026-11-05 (b) in the spike generators; placer weights keep the
    gate layout rules; fixtures regenerated; report is Draft.
    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
    [gen_gate.py, holdoff_cap.py, ilim_steps.py, layout_full.py, layout_sch.py, pcb_full.py, pcb_place.py, pcb_rules.py]
2026-11-05 spike: G2 rules in pcb_rules.py, write_dru, net_class_widths, T4 and T11 (HW-010, HW-003, ADR-0012)
    Rule numbers moved to pcb_rules.py (pure Python); pcb_full, write_project and pcb_stitch read them;
    a .kicad_dru is written next to the project. Values not loosened (FLOOR). Stitch width of +5V is
    NET_WIDTH (0.6). Observed: board and .kicad_pro byte-identical to the build before G2, placed DRC
    counts equal; test_pcb_rules 13 OK, test_pcb_full 22 OK, test_pcb_place/test_kicad_strict OK.
    Spike only; nothing Approved.
    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
    [pcb_full.py, pcb_rules.py, pcb_stitch.py, test_pcb_rules.py]
2026-11-05 spike: G3 first run, jar hash check, stitch step, M1/M2 helpers, stitched-4l profile; M2 = 71, gate not met (HW-010, HW-003, ADR-0012)
    Tests first: T5 (jar), T9 (stitcher exit code), T10 (count_unrouted on fixtures with M1 added to
    drc_expected.json), refs_any, run meta keys. Observed run: M1 = 0, M2 = 71 (GND; 60 pads failed to stitch),
    M3 = 0, strict stitched DRC 324 findings with 7 classes over their limit (see plan amendment A-7).
    Waiver caps of placed-4l and routed-4l not raised; DEV-002 and DEV-003 proposed, not approved.
    Not run: T6, T7, T8, T15, T17, G4 onward.
    Claude-Session: https://claude.ai/code/session_01NnNc9CXaSMwmsPGC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
    [kicad_strict.py, pcb_check.py, pcb_replay.py, pcb_stitch.py, test_kicad_strict.py, test_pcb_rules.py, test_run_pcb_jar.py]
2026-11-05 spike: ILIM resistors 56.9 k and 27.7 k single parts, remove R_ILIM3B (HW-010, SW-009, ADR-0016)
    Owner decision 2026-11-06. Both values are unsourced at 0.1 % 0603.
    Tests changed first (7 failed red). 53 nets, 92 components, unit tests 173 OK.
    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
    [gen_gate.py, ilim_steps.py, layout_full.py, layout_sch.py, pcb_full.py, test_gate_logic.py, test_ilim_steps.py, test_layout_full.py]
2026-11-05 spike: generate library tables, project file and custom libraries; fix the ERC/DRC library findings at the cause (HW-010, ADR-0012)
    kicad-cli loads a project library table only next to a project file; the generated
    directories had none. ERC footprint_link_issues 96 -> 0, lib_symbol_issues 241 -> 0
    (gate-layout 28 -> 0, 61 -> 0), placed DRC lib_footprint_issues 93 -> 0. Caps removed
    or lowered only. Plan 06 A-9 updated, A-11 added.
    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
    [custom_fp.py, layout_full.py, layout_sch.py, lib_tables.py, pcb_full.py, test_kicad_strict.py, test_lib_tables.py]
2026-11-06 docs: ADR-0016 amendment 2 (Proposed) for the ILIM select switch, ILIM resistors and hold-off capacitors (ADR-0016, HW-010, SYS-020)
    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
2026-11-06 docs: ILIM resistors back to 47.0 / 56.9 / 27.7 kohm, 56.2 k / 27.4 k + 301 ohm kept as sourcing fallback (HW-010, ADR-0016, SYS-020)
    Owner decision 2026-11-06. 56.9 k and 27.7 k at 0.1 % 0603 are unsourced
    (stock-check-ilim-holdoff.md) and must be confirmed before ordering. Windows
    recomputed with ilim_steps.py. Nothing Approved or Accepted.
    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
2026-11-06 docs: rule 12 requires CAD changes through the KiCad and FreeCAD scripting APIs, not user GUI edits
    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
2026-11-06 hw: ILIM select MOSFET leakage bound for the 2N7002 replacement, with tested script (HW-010, ADR-0010, ADR-0016)
    Datasheet IDSS bounds for BSS138 and AO3400A do not prove 0.1 % accuracy;
    the ILIM pin voltage is not stated by TI. Bench measurement proposed, owner decides.
    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
2026-11-06 docs: HW-010 proposal names the owner-chosen ILIM resistors and the 6 x 100 nF hold-off set, TC-210 outline follows (HW-010, ADR-0016, TC-210)
    Proposed text only; Approved text unchanged. Live JLCPCB stock of 2026-11-06 noted.
    Hold-off window 203.2 to 553.2 ms from holdoff_cap.py, margin 3.2 ms to the lower edge.
    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
2026-11-06 docs: ADR-0016 amendment 2 follows the 2026-11-06 owner decisions: E96 resistors with live stock, 6 x 100 nF hold-off set, 3.2 ms margin (ADR-0016, HW-010, SYS-020)
    Amendment stays Proposed; the Accepted decision is unchanged.
    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
2026-11-06 docs: goldfish review RV-010 of the HW-010 gate bundle, fix ADR-0016 option C score and Related list, SYS-020 worst case for the six 100 nF set (HW-010, SYS-020, ADR-0016, RV-010)
    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
2026-11-06 docs: consolidate the HW-010 Proposed text into one revision with a current-values table, add RV-010 acceptance criteria, note the E96 decision in the owner record and DEV-001 (HW-010, ADR-0016, RV-0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
2026-11-07 docs: ILIM switches supplied from VBUS_IC removes the TMUX1101 over-voltage by design: analysis, ADR-0016 update, HW-010 revision, DEV-001 and RISK-045 notes (HW-010, ADR-0016, DEV-001, RISK-045)
    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
2026-11-07 docs: the TVS clamp question for the switch supply is a selection requirement for the placeholder TVS1 (HW-010, ADR-0016, RISK-045)
    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
2026-11-07 spike: generators and fixtures at the approved HW-010 values: E96 ILIM resistors, six 100 nF hold-off, TMUX1101 supply from VBUS_IC, CC_OK_3A deleted (HW-010, ADR-0016, ADR-0012)
    185 spike tests pass; routing and routed DRC fixtures not regenerated.
    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
    [gen_gate.py, holdoff_cap.py, ilim_steps.py, layout_full.py, layout_sch.py, pcb_full.py, test_gate_logic.py, test_holdoff_cap.py]
2026-11-07 docs: owner accepts ADR-0003 (antenna A first, spike gate) and ADR-0011 for the prototype (PETG); ADR-0014 stays Proposed (ADR-0003, ADR-0011, ADR-0014, HW-010)
    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
2026-11-07 docs: draft procedures for TC-210, TC-213, TC-105, TC-109, TC-110 and a TVS1 / 3V3 regulator shortlist; a plain 5 V TVS cannot meet the 6 V switch supply clamp (HW-010, HW-013, SW-005, SW-009, SW-010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
2026-11-07 docs: RV-010 records the rerun of the readiness check: NO-GO overall, firmware-logic slice possible after the plan, pin map and board files (RV-010, HW-010, SW-005, SW-009, SW-010)
    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
2026-11-07 docs: firmware plan 07 with the spike pin map, TC-107 procedure, datasheet readings for the TVS1 and 3V3 regulator shortlist (SW-005, SW-006, SW-007, SW-009, SW-010, HW-010, HW-012, ADR-0016)
    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
2026-11-07 docs: owner decisions on surge protection, 3V3 regulator, sensor pins and the SW-005 step table recorded as Proposed amendments (HW-010, HW-011, HW-013, SW-005, SW-009)
    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
2026-11-07 test: ngspice analysis of series resistor and 5.1 V zener at the TMUX1101 and TUSB321 supply pins: 1 kohm and 470 ohm; HW-010 Proposed amendment carries the values (HW-010, ADR-0016, DEV-001)
    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
2026-11-07 docs: regulator heat analysis (TLV75733P DYD recommended), CC-pin protection options, surge values approved by the owner (HW-010, HW-013, ADR-0016)
    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
2026-11-07 docs: owner chooses the standard regulator package with a firmware limit and ESD part plus series resistors on CC; limits and caution recorded (HW-010, HW-013, ADR-0016)
    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
2026-11-07 style: wrap a long line in the regulator heat script so ruff passes (HW-010)
    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
2026-11-07 docs: fix review findings that are plain errors: regulator text, test counts, TC-106 procedure, TC-109 and TC-107 pass wording, plan 07 interface and gate (HW-010, SW-006, SW-007, SW-009, SW-010)
    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
2026-11-07 docs: ADR-0018 and ADR-0019 (Proposed) record the FAULT_N and regulator choices with the assistant's dissent; SW-007 and SW-010 Proposed amendments for flag, clock and watchdog (ADR-0018, ADR-0019, S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
2026-11-07 docs: part-rating table for VBUS_IC and +5V shows the surge exposes the TPS2553, the regulator and the LED placeholder; options S1 to S3 for the owner (HW-010, ADR-0010, ADR-0016, RV-011)
    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
2026-11-07 docs: owner chooses to measure the 5 V-side surge first; TC-210 step 4 records the peaks against the part ratings (HW-010, TC-210, ADR-0010)
    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
2026-11-07 feat: first FreeCAD housing generator and tolerance check for the 53 mm housing, with tests and evidence report (MECH-001, MECH-004, MECH-006, MECH-007, MECH-009)
    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
2026-11-07 docs: owner raises the USB-C window to 14.2 x 8.2 mm for worst-case reserve (MECH-004)
    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
2026-11-07 feat: FreeCAD coupon generator for diffuser plates, spacer rings and bayonet floor disc (MECH-002, MECH-007)
    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
2026-11-07 feat: complete housing model with lid spigot and snap bumps, PCB posts, button hole and bayonet detent; spigot tolerance check (MECH-001, MECH-004, MECH-007, MECH-009)
    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
2026-11-07 feat: spike schematic with the AND gate readback, free sensor pins and supply-pin resistors with zeners; six tests (HW-010, HW-012, ADR-0016, ADR-0018)
    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
2026-11-07 docs: README status, schematic, board and housing images refreshed; routed spike rerun with the AND gate and supply-pin protection; README render script for the housing views (HW-010, MECH-007, ADR-0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
2026-11-07 feat: antenna strip set to the 4.6 mm of the ESP32-C3-MINI-1 datasheet, module pads placed outside it, slot beside the antenna end with a copper keep-out, movable-part radius 17.3 mm; five tests (HW-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
    The 21 module ground pads that sat inside the 5.4 mm strip were caused by the strip length and by centring the pad area in the module body.
    The datasheet (v2.2, fig 11-1) puts the antenna area beyond the pad rows. The slot follows the vendor hardware guide (1.4.7).
    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
2026-11-07 feat: spike PCB routing fixes and post-route clean-up: stitcher retry passes and layer-aware joins, dangling-via removal, silk waiver DEV-006, VBUS_IC main-path split, VBUS_IC placement weight, grid-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
    Best run: 1 unconnected item (/ILIM) and only the tolerated known findings; Freerouting still varies between runs.
    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
    [pcb_dsn.py, pcb_fix.py, pcb_rules.py, pcb_stitch.py, test_pcb_rules.py]
2026-11-07 docs: spike PCB run table and evidence, DEV-006 silk waiver (proposed), CHANGELOG (HW-010, ADR-0012, DEV-006)
    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
2026-11-08 feat: datasheet-based footprints for the spike board: ESP32-C3-MINI-1, TUSB321 redrawn from the TI drawing, TLV75733P SOT-23-5, WS2812B-2020 symbol with matching pin numbers; tests (HW-010, ADR-0004,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
    The old LED pairing (5050 symbol, 2020 footprint) put power and data on the wrong pads; the old TUSB321 land pattern was wrong.
    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
    [custom_fp.py, layout_full.py, pcb_full.py, test_kicad_strict.py, test_layout_full.py, test_pcb_full.py]
2026-11-08 feat: spike gate: default-ignored ERC/DRC checks switched on, best-of-N routing (run_best.sh), outer-layers-only rule for VBUS_IC and +3V3, power and plane check, clean-up of edge/hole/off-centre fin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
2026-11-08 docs: spike PCB report update (real footprints, best-of-N, power check), deviations DEV-002/003/006 updated, CHANGELOG (HW-010, DEV-002, DEV-003, DEV-006)
    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
2026-11-08 feat: run_best.sh gives each run its own placement seeds (PLACE_SEED_START); report of the re-placement for the real footprints (HW-010)
    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
2026-11-08 feat: spike board fine-rule experiment profile (JLCPCB multilayer minimums), signals off the ground plane, J1 edge-silk footprint copy, picker copies libraries, power check with 15.2 um inner copper;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
2026-11-08 feat: spike board LED cell ring (pcb_ring), connection_width clean-up, soft placement ties on the VBUS_IC and +3V3 current paths, picker ranking (HW-010, ADR-0020)
    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
2026-11-08 docs: skill pcb-route-and-gate and its goldfish review RV-012 (HW-010)
    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
2026-11-08 docs: spike report (ring4 to ring6 batches, power drops), README images and captions from the best of 12 runs, CHANGELOG (HW-010)
    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
2026-11-08 fix: spike schematic symbols of U1 and U9 carry the datasheet pad numbers, PADMAP deleted, test points out of the BOM; ring7 batch record (HW-010, DEV-002)
    The TUSB321 (TI SLLSEO6C section 5) and ESP32-C3-MINI-1 (datasheet v2.2
    table 3-1) box symbols now use pad numbers, so the DRC schematic parity
    check covers both parts: net_conflict 77 -> 0 on the best ring7 run
    (98 -> 16 findings). No ring7 run passes the strict gate (one batch).
    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
    [layout_full.py, pcb_check.py, pcb_full.py, test_layout_full.py]
2026-11-08 chore: strict waiver limits of the spike profile stitched-4l lowered to the observed counts (owner decision 2026-11-08; DEV-002, DEV-004)
    net_conflict 0, footprint_symbol_mismatch 2 (C3 and C4 only),
    courtyards_overlap 14 (U9 only); test pins the limits.
    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
2026-11-08 docs: draft requirements HW-014 (+5V capacitance), HW-015 (VBUS capacitance), HW-016 (spare footprints), analysis and bound script, goldfish review RV-013 (HW-004, HW-010)
    All three requirements are Draft. RV-013 rejected the first HW-014
    draft; the redraft follows the owner decision of 2026-11-08 (lower
    bound = part makers' minimum, spare footprints, prototype measurement)
    and has not been reviewed again.
    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
2026-11-08 feat: spike layout tidiness numbers and tie-break of the run picker, SEED_OFFSET for run_best.sh (HW-010)
    pcb_quality.py reports vias, track length, off-45 length, sharp corners, LED ring spread, passives in rows,
    parts on 90 degrees, passive to partner distance, block member distance and like-part orientation.
    pcb_pick.py uses it only after the gate score, so a tidier board never beats a board that passes more of the gate.
    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
2026-11-08 feat: spike placer options for grid, antenna keep-out, regulator ties, functional blocks and orientation (HW-010)
    PLACE_GRID, PLACE_ANT_KEEPOUT, PLACE_BLOCKS, PLACE_ORIENT, PLACE_STRICT and PLACE_ROWS, all off by default.
    BLOCKS and TWINS in pcb_rules.py; pin ties C5-U8 and C6-U8. Batches ring8 to ring14 are in the spike report;
    PLACE_STRICT and PLACE_ROWS gave no gain (ring13) and stay off. The radii and weights are first guesses.
    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
2026-11-08 fix: spike clean-up snaps track ends onto the via centre at the gate findings (HW-010)
    snap_to_vias existed but nothing called it, so ends 0.009 and 0.05 mm beside a via stayed as
    track_not_centered_on_via. last_pass now calls it at the reported sites only (an unrestricted snap broke a
    clearance, 0.093 against 0.100 mm) and removes a track left with no length. Regression tests first.
    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
    [pcb_fix.py]
2026-11-08 feat: spike fabricator-minimum check against the JLCPCB numbers of ADR-0020 (HW-010)
    Partial and single-fabricator: ADR-0020 is Proposed, the capability page was not read again, no Gerber or
    assembly checks. Slots are modelled as capsules (test first).
    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
2026-11-08 docs: spike report, journal and CHANGELOG for batches ring8 to ring14 and the fabricator-minimum check (HW-010, ADR-0020)
    Two of 12 ring14 runs pass the strict gate. Not run: fab review, Gerber checks, RF, thermal, bench.
    HW-014, HW-015 and HW-016 stay Draft; ADR-0020 stays Proposed.
    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
2026-11-08 feat: spike run picker ranks power-check failures before tidiness (HW-010)
    Ring15 run 1 won the pick but has no +5V copper path and 50.4 mV on VBUS_IC.
    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
    [pcb_pick.py, test_pcb_pick.py]
2026-11-08 docs: store the routed spike board (ring14 run 9) and re-render the README images and caption (HW-010, ADR-0020)
    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
    [busy_light_spike.kicad_pcb, busy_light_spike.kicad_sch]
2026-11-08 feat: spike assembly check pcb_fabreview.py and fab review report of the stored board (HW-010, ADR-0020)
    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
2026-11-08 refactor: rename the seven unannotated spike references to numbered ones (C1B to C1F to C27 to C31, R_ILIM3B to R20, R_VD to R21) (HW-010)
    KiCad reads a reference without a trailing number as unannotated and lists it with a question mark in the BOM.
    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
2026-11-08 feat: spike board finishing (silkscreen designators, fiducials), stored board renamed and finished, README images and fab review updated (HW-010, ADR-0020)
    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
    [busy_light_spike.kicad_pcb, busy_light_spike.kicad_sch]
2026-11-08 fix: CI for the stored spike board (strict wrapper in ci_hw.sh, ERC severities in the board project, symbol library next to the schematic) and ruff line length of bulk_cap_bounds (HW-010, ADR-0012)
    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
    [pcb_full.py, test_pcb_full.py]
2026-11-08 feat: BOM sourcing fields (MPN, manufacturer, LCSC) in the spike schematic and a fab-review finding for parts without an MPN (HW-008, HW-010)
    Only TMUX1101DCKR has a recorded source; 92 BOM references still have none.
    Stored schematic regenerated (ERC 0, only the added fields differ).
    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
    [busy_light_spike.kicad_sch]
2026-11-08 feat: MPNs for 13 ICs and specific parts of the spike BOM from web lookups, with evidence per entry; 61 references still without MPN (HW-008, HW-010)
    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
    [busy_light_spike.kicad_sch]
2026-11-08 feat: capacitor values C2 to C6 and second spare C32 on the spike board, sourcing fields on the footprints (HW-014, HW-015, HW-016, HW-010)
    Owner decisions 2026-11-08: C2 4.7u, C3 10u 0805, C5 2.2u, C6 10u, C4 and C32
    1206 do-not-populate spares. C32 is on the bottom side (24 mm from U7 pin 6;
    the HW-016 [5] mm is not met). Also fixes 100 footprint_symbol_field_mismatch
    warnings that the earlier MPN-field change caused in the strict DRC.
    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
    [busy_light_spike.kicad_pcb, busy_light_spike.kicad_sch]
2026-11-08 docs: open to-dos of the spike board after the fab-review work (HW-010)
    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
2026-11-08 feat: MPNs for passives and U9 of the spike BOM from web lookups; 7 references still without MPN (HW-008, HW-010)
    Resistors (Uni-Royal, FH, Yageo), 100n/1u capacitors, ESP32-C3-MINI-1-N4.
    Schematic regenerated, footprint fields synced; strict ERC 0, strict DRC
    only tolerated findings. C2/C3/C5/C6, J1, TVS1, TVS2 stay empty.
    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
    [busy_light_spike.kicad_pcb, busy_light_spike.kicad_sch]
2026-11-09 feat: real parts for C2, C3, C5, C6 of the spike board with Samsung DC-bias analysis; 3 references still without MPN (HW-014, HW-015, HW-010)
    Value texts carry the rating, MPN/LCSC added from listings. dc_bias_caps.py applies the
    Samsung Component Library curves (25 degC, 1 kHz, 1 Vrms) plus tolerance and X5R spread:
    C2 1.69 uF at 5.25 V, C5 0.67 uF at 5.5 V. Schematic and board regenerated; strict ERC 0,
    strict DRC 9 tolerated findings. Bench criteria still open.
    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
    [busy_light_spike.kicad_pcb, busy_light_spike.kicad_sch]
2026-11-09 feat: DC-bias analysis for the 100 nF X7R capacitors and the room for the spares C4, C32 (HW-014, HW-015)
    Samsung curve read for CL10B104KB8NNN (retention 0.998 at 5.6 V); spare room 65 uF nominal; tests and report updated.
    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
2026-11-09 feat: TVS1 PESD5V0S1BA under surge option S1; draft ADR-0021, HW-017, TC-217, RISK-046; protection-part capacitance bound (HW-010, HW-015, HW-017)
    TVS1 sourcing entry (owner choice 2026-11-09), protection parts bounded at 0.98 nF on VBUS_IC. ADR-0021 Proposed, HW-017 Draft, nothing approved.
    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
2026-11-09 feat: part evidence for TVS1 PESD5V0S1BA and the Nexperia BZX84-C5V1 from the downloaded datasheets; USBLC6-2P6 VBUS capacitance recorded as source-missing (HW-012, HW-010)
    All claims unverified. Quotes and hashes pass check_part_evidence.py with the datasheets folder present.
    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
    [sourcing.py]
2026-11-09 feat: MPNs for J1 (GCT USB4085-GF-A) and TVS2 (PESD3V3L1BA,115) with evidence files; USBLC6-2P6 VBUS capacitance sensitivity (HW-008, HW-010, HW-012, HW-015)
    No edge-mount USB4085 variant exists; the project footprint is the USB4085 pad pattern at the board edge. All new claims unverified. No BOM reference is left without an MPN.
    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
2026-11-10 feat: automated compliance checks in CI for hardware, firmware and the compliance matrix (ADR-0022, HW-018, HW-019, HW-020, SW-011, SW-012, SYS-044)
    Hardware rules HWC-001..009 read the stored KiCad board and schematic without a
    KiCad install (scripts/kicad_sexp.py, scripts/check_hw_compliance.py): ESD clamp
    on every external interface net, clamp distance, test points on rails and
    reset/boot, board name and revision on the silkscreen, MPN per BOM part,
    RoHS/REACH register (hw/compliance/materials.yaml), lifecycle, debug-access
    inventory. Gate findings of the spike board are waived under DEV-007; a stale
    waiver fails.
    Firmware rules SWC-001..009: Kconfig security policy (sw/kconfig-policy.ya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
2026-11-10 docs: regulatory update, standards list, CRA Annex I mapping, labelling and RoHS approach; draft regulatory requirements (SYS-048, SYS-049, HW-018, HW-019, HW-020, SW-011, SW-012, ADR-0022, DEV-007)
    Applicability assessment update of 2026-11-10 (RED cyber delegated act
    repealed from 11 December 2027 by (EU) 2026/339, CRA reporting from
    11 September 2026, default CRA class), candidate standards per RED article
    and for the CRA, CRA Annex I mapping with gaps, labelling and user-information
    item list, RoHS/REACH/WEEE approach, compliance-matrix rows for every
    requirement with a regulatory reference, rule catalogue of the automated
    checks. All legal references come from secondary sources (eur-lex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
2026-11-10 feat: supply track width rule HWC-010 and fix of the secret scan flagging its own test (HW-003, ADR-0022)
    HWC-010 (report) compares every track segment of a supply net with the
    IPC-2221 chart formula for the net's design current. On the spike board many
    segments of VBUS_IC and +5V are narrower than the 0.57 mm it asks for 1.6 A on
    an outer layer; copper areas are not counted, so a reviewer checks the main
    path.
    Fix: scripts/test_check_sw_policies.py held a quoted option name that the
    secret scan (SWC-003) matched once the file was tracked, so the previous
    commit would fail CI. The string is now built at run time.
    Tests: 101 pass; ruff, mypy, reuse lint pass locally.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
2026-11-10 docs: technical-file grade regulatory documents with applicability per act, product risk assessment, clause-level standards list and test plan (SYS-050, SYS-051, SYS-052, SYS-053, HW-021, MECH-010, M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
    - Product description (technical file 01) from existing requirements only.
    - Applicability assessment RAA-001 v0.3: scope test per act, manufacturer
    role and start of duties, acts found not applicable with reasons,
    conformity strategy, dates, open decisions D1-D8 and checks V1-V8. Owner
    answers and the 2026-11-03 consequence list are kept unchanged.
    - Product risk assessment: method, scales, proposed criteria, 32 scored
    hazards (safety, EMC, radio, c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
