spoorcc/busy-light/(notices)

Notices in the files:
README.md:
Docs, hardware, mechanics: CC BY-NC-SA 4.0
